awhite2000/sigmidi/design/front-panel.md

# SIGMIDI Foot Controller v0.1 — Front panel

The preferred Left main enclosure measures **350 × 92 × 54 mm**, with 65 mm horizontal switch pitch, 32.5 mm stagger, 53 mm row spacing and a 30 mm raised upper row. The shell has at least 2 mm sides and 3 mm top panels.

Viewed from the playing position, Left labels run **A B C D E** across the raised row and **1 2 3 4 5** across the lower row. The display and encoder are on the left. The Waveshare 24382 glass is flush with the lower deck; the ribbon is on the left and the firmware selects 180° rotation. Right has electronics on the right and labels **E D C B A / 5 4 3 2 1**.

Modular Left assemblies have an A B / 1 2 electronics section, C/3, D/4 and E/5 sections as required, and a right end cap. Right extends leftward from its electronics section. Every extension occupies 65 mm of width.

Switch names use Arial Bold outlines, 8 mm high and recessed 0.8 mm. The roof below the markings is 2.2 mm thick. An optional LED is below each switch; covers close unused LED holes.

The Left electronics upper shell carries a **25 × 20.183 mm** icon between A and B, raised 0.6 mm and backed by the full 3 mm roof. Maximum local body height at the icon is 54.6 mm.

Use the [Left top view](fusion/mirrored/main/top.png), [populated assembly](fusion/mirrored/main/assembled.png), [icon detail](fusion/mirrored/main/embossed-icon.png) and [assembly-coordinate geometry](fusion/mirrored/layout.json). Renders are overviews; manufacture from the [CAD and oriented print files](fusion/mirrored/README.md).
