awhite2000/sigmidi/previews/kicad-schematic.html

# SIGMIDI Foot Controller v0.1 · KiCad schematic

External board pins only. Arduino Nano ESP32 and display connectors retain physical pin order.

57 components · 49 nets · 178 connected terminals · connectivity and pin order verified against the electrical diagram.

Fit− 100%+ Readable detailOpen vector drawing PNG

Complete SIGMIDI KiCad schematic with physically ordered Arduino Nano ESP32 and display pins
