awhite2000/sigmidi/design/ladders/voltage-targets.csv

layout | switch_count | tap | displayed_switch | series_ohms | nominal_mV_at_3V3
linear | 4 | 0 | idle |  | 2200.000
linear | 4 | 1 | 1 | 1000 | 286.957
linear | 4 | 2 | 2 | 2000 | 507.692
linear | 4 | 3 | 3 | 3000 | 682.759
linear | 4 | 4 | 4 | 4000 | 825.000
linear | 5 | 0 | idle |  | 2200.000
linear | 5 | 1 | 1 | 1000 | 286.957
linear | 5 | 2 | 2 | 2000 | 507.692
linear | 5 | 3 | 3 | 3000 | 682.759
linear | 5 | 4 | 4 | 4000 | 825.000
linear | 5 | 5 | 5 | 5000 | 942.857
linear | 6 | 0 | idle |  | 2200.000
linear | 6 | 1 | 1 | 1000 | 286.957
linear | 6 | 2 | 2 | 2000 | 507.692
linear | 6 | 3 | 3 | 3000 | 682.759
linear | 6 | 4 | 4 | 4000 | 825.000
linear | 6 | 5 | 5 | 5000 | 942.857
linear | 6 | 6 | 6 | 6000 | 1042.105
linear | 7 | 0 | idle |  | 2200.000
linear | 7 | 1 | 1 | 1000 | 286.957
linear | 7 | 2 | 2 | 2000 | 507.692
linear | 7 | 3 | 3 | 3000 | 682.759
linear | 7 | 4 | 4 | 4000 | 825.000
linear | 7 | 5 | 5 | 5000 | 942.857
linear | 7 | 6 | 6 | 6000 | 1042.105
linear | 7 | 7 | 7 | 7000 | 1126.829
linear | 8 | 0 | idle |  | 2200.000
linear | 8 | 1 | 1 | 1000 | 286.957
linear | 8 | 2 | 2 | 2000 | 507.692
linear | 8 | 3 | 3 | 3000 | 682.759
linear | 8 | 4 | 4 | 4000 | 825.000
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
