awhite2000/sigmidi/design/fusion/archive/README.md

# Wall sample data

`post-display-m2x5-wall-sampling.zip` contains Right-enclosure thickness samples. Left samples are in `../mirrored/wall-sampling.zip`. The [complete native Fusion model](../sigmidi-foot-controller-0.1.f3d) contains all enclosure assemblies and part libraries.
