awhite2000/sigmidi/design/branding/sigmidi-mark-light.png

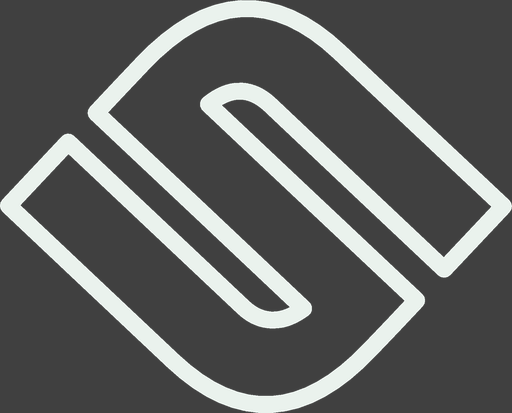
design/branding/sigmidi-mark-light.png
