awhite2000/sigmidi/design/branding/sigmidi-mark-original.png

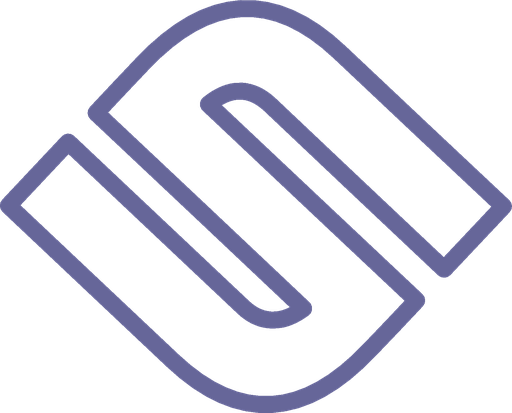
design/branding/sigmidi-mark-original.png
