awhite2000/sigmidi/design/fusion/base-corner-detail.png

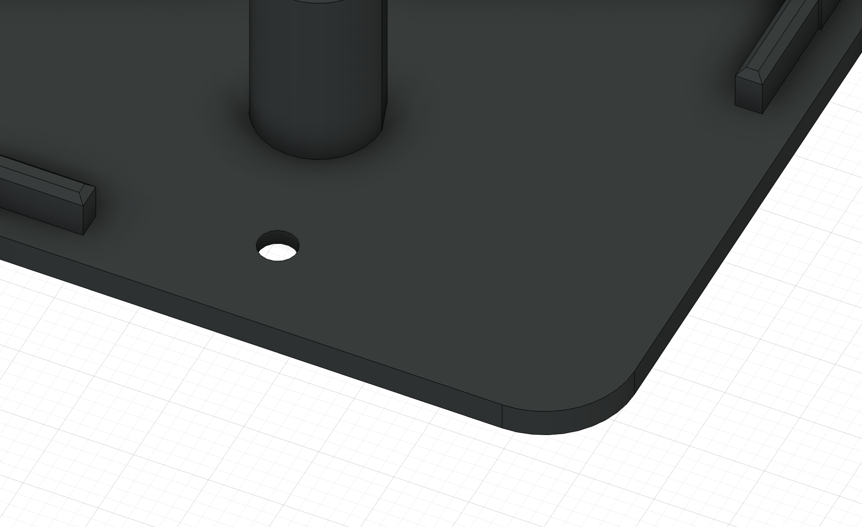
design/fusion/base-corner-detail.png
