awhite2000/sigmidi/design/fusion/base-open.png

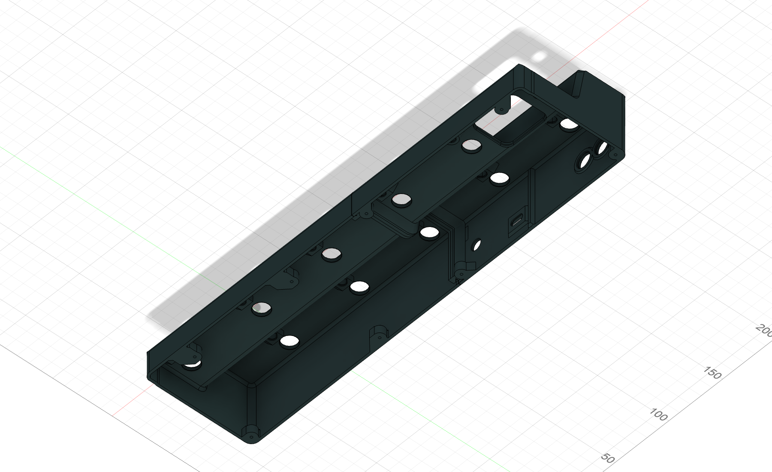
design/fusion/base-open.png
