awhite2000/sigmidi/design/fusion/base-supports.png

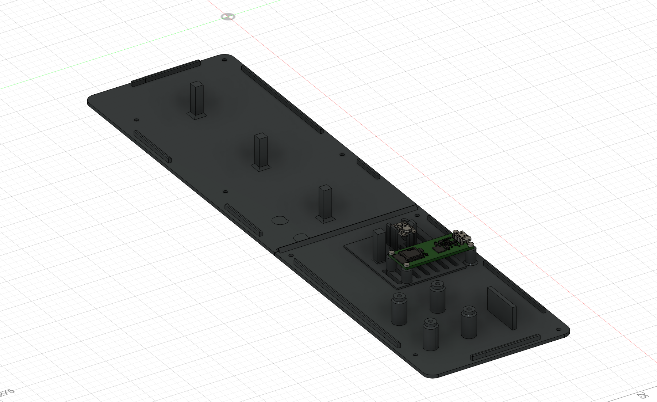
design/fusion/base-supports.png
