awhite2000/sigmidi/design/fusion/blind-pilot-cap-section.png

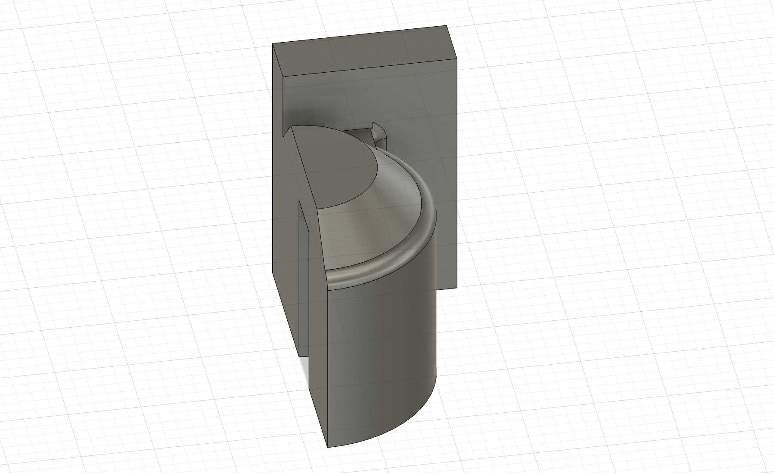
design/fusion/blind-pilot-cap-section.png
