awhite2000/sigmidi/design/fusion/clip-mount.png

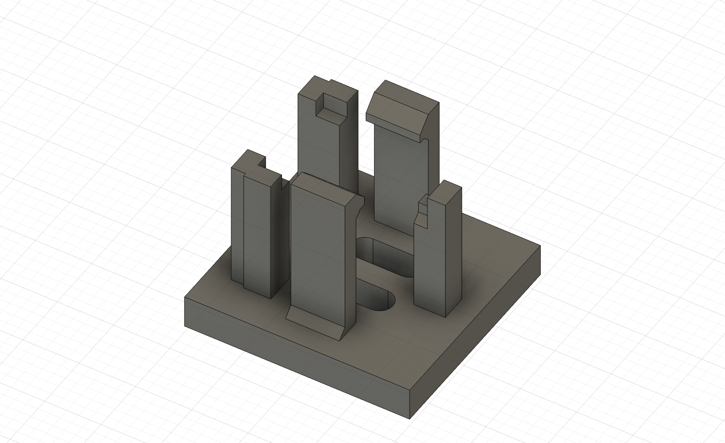
design/fusion/clip-mount.png
