awhite2000/sigmidi/design/fusion/exploded.png

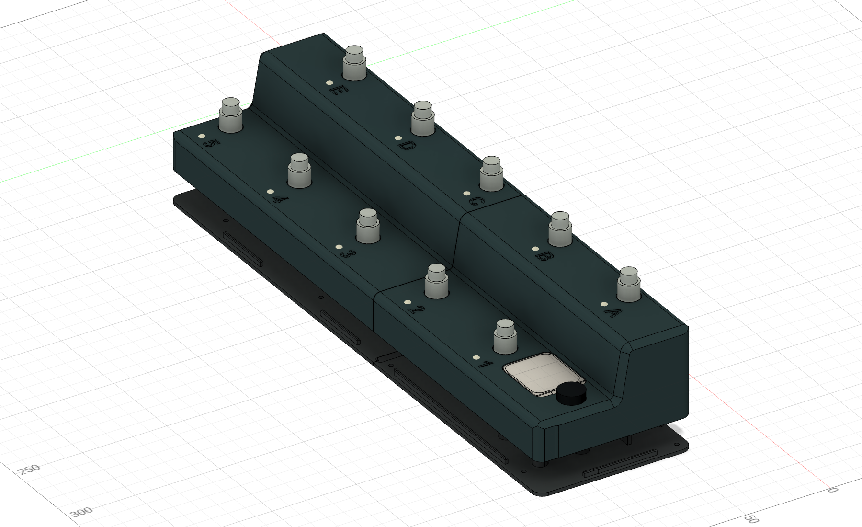
design/fusion/exploded.png
