awhite2000/sigmidi/design/fusion/internal.png

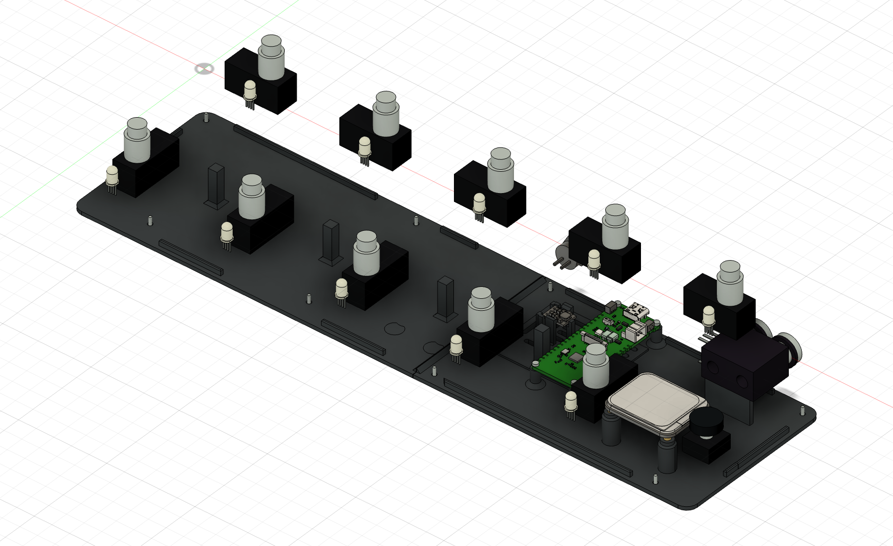
design/fusion/internal.png
