awhite2000/sigmidi/design/fusion/mirrored/main/display-ribbon-left.png

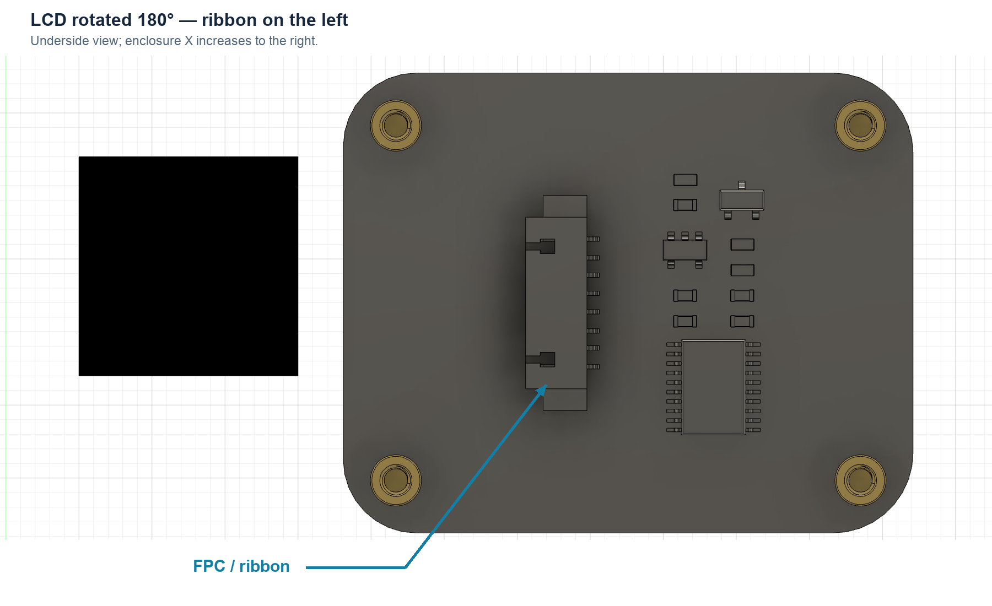
design/fusion/mirrored/main/display-ribbon-left.png
