awhite2000/sigmidi/design/fusion/mirrored/main/exploded.png

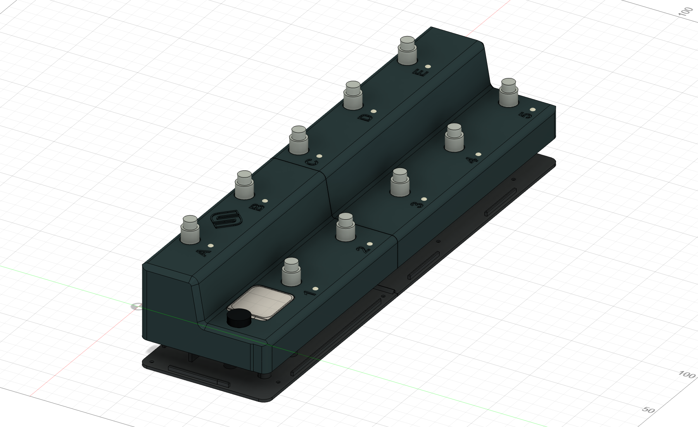
design/fusion/mirrored/main/exploded.png
