awhite2000/sigmidi/design/fusion/mirrored/main/internal.png

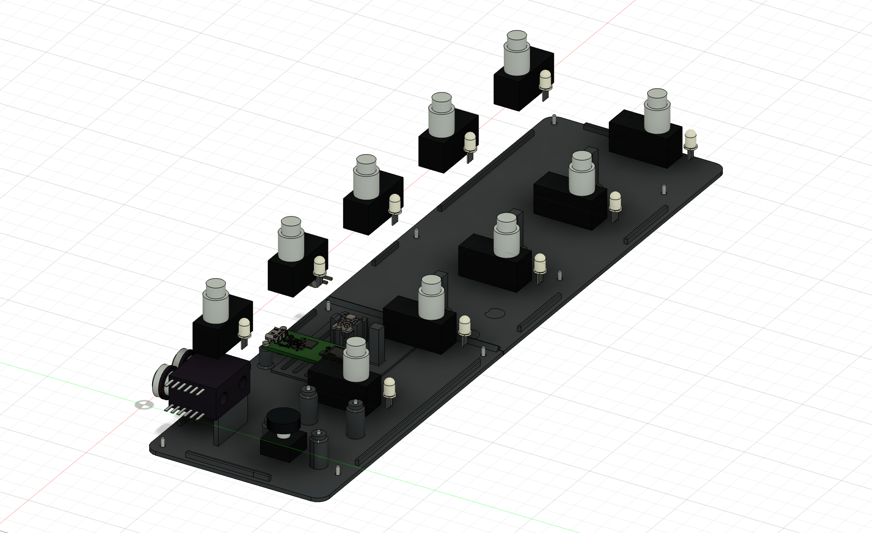
design/fusion/mirrored/main/internal.png
