awhite2000/sigmidi/design/fusion/mirrored/main/rear.png

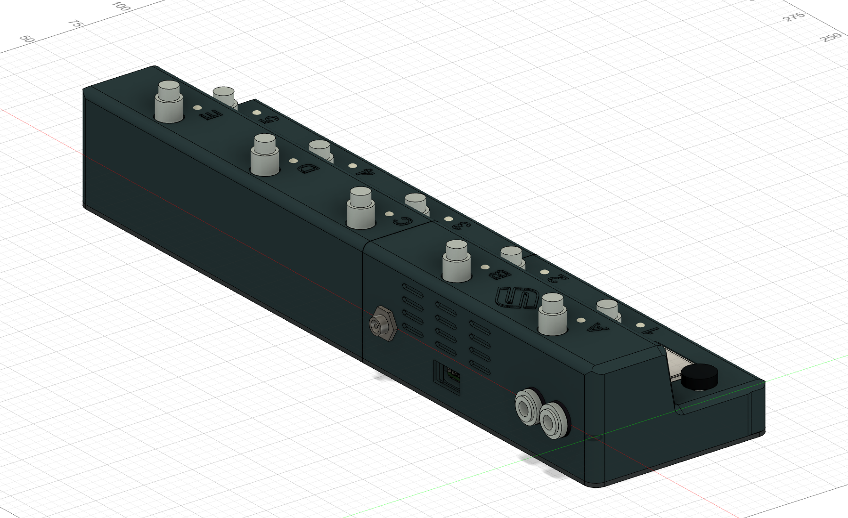
design/fusion/mirrored/main/rear.png
