awhite2000/sigmidi/design/fusion/mirrored/main/top.png

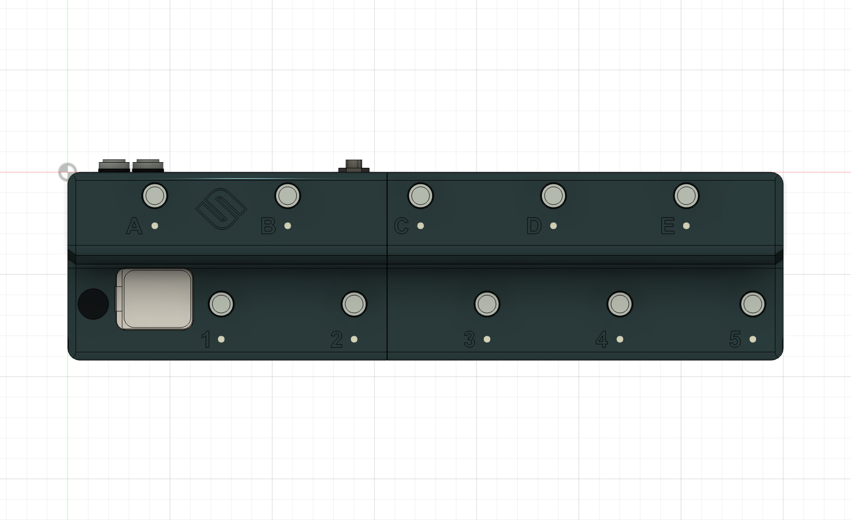
design/fusion/mirrored/main/top.png
