awhite2000/sigmidi/design/fusion/mirrored/modular/base-mounts.png

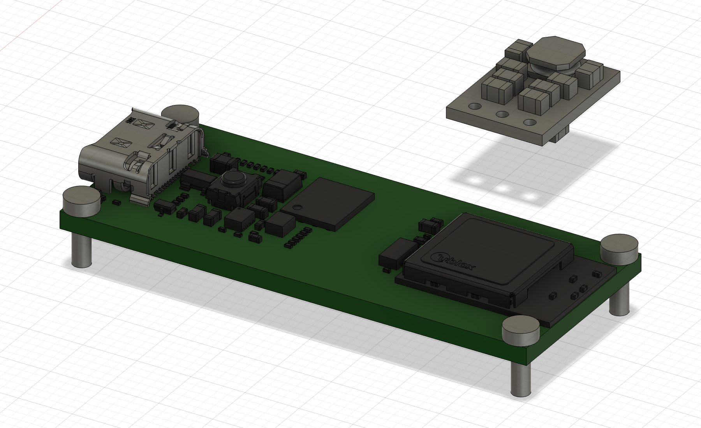
design/fusion/mirrored/modular/base-mounts.png
