awhite2000/sigmidi/design/fusion/mirrored/modular/exploded.png

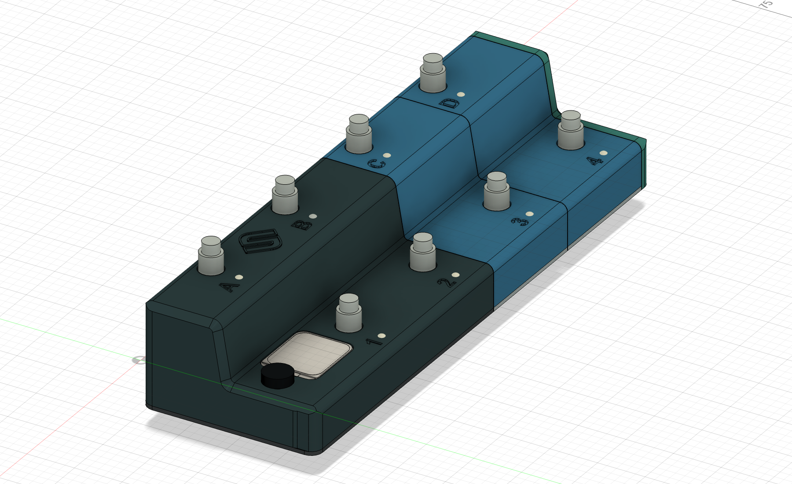
design/fusion/mirrored/modular/exploded.png
