awhite2000/sigmidi/design/fusion/mirrored/modular/internal.png

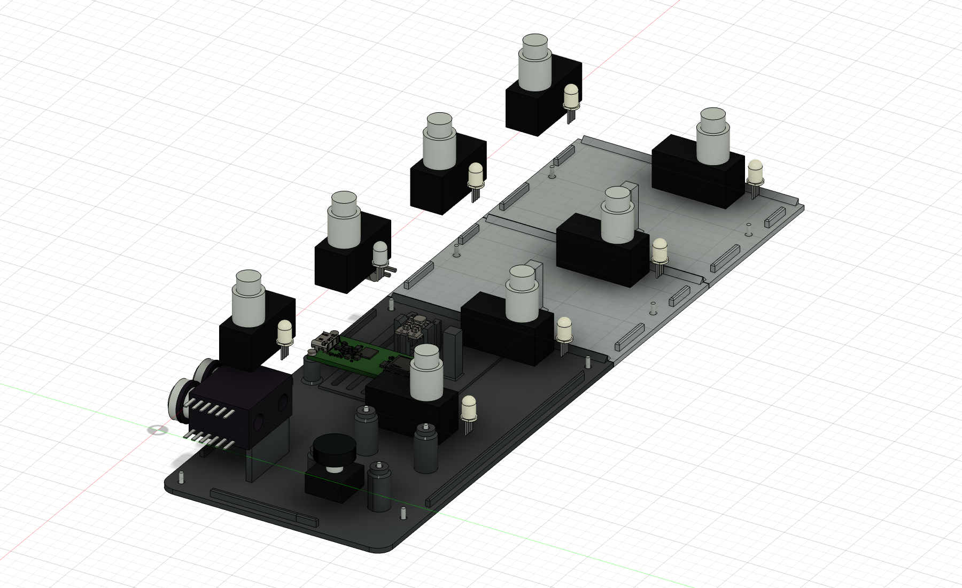
design/fusion/mirrored/modular/internal.png
