awhite2000/sigmidi/design/fusion/mirrored/modular/rear.png

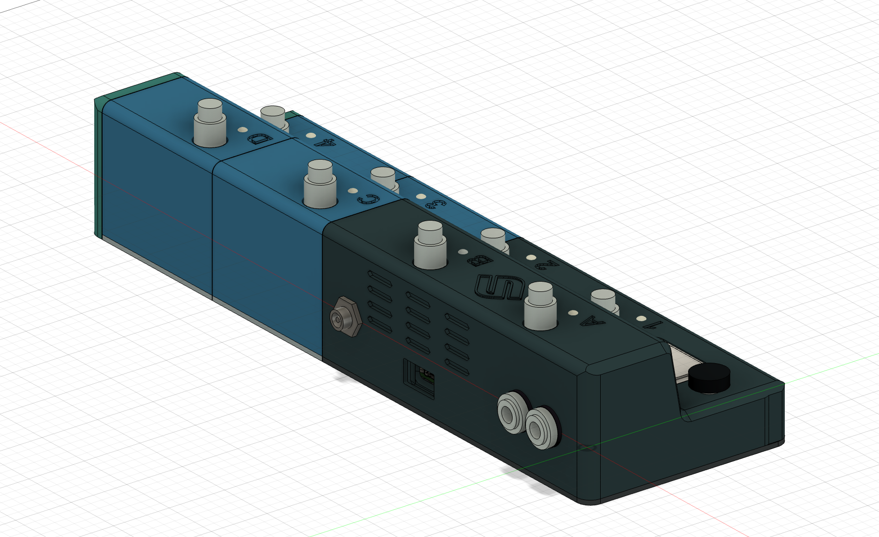
design/fusion/mirrored/modular/rear.png
