awhite2000/sigmidi/design/fusion/mirrored/modular/top.png

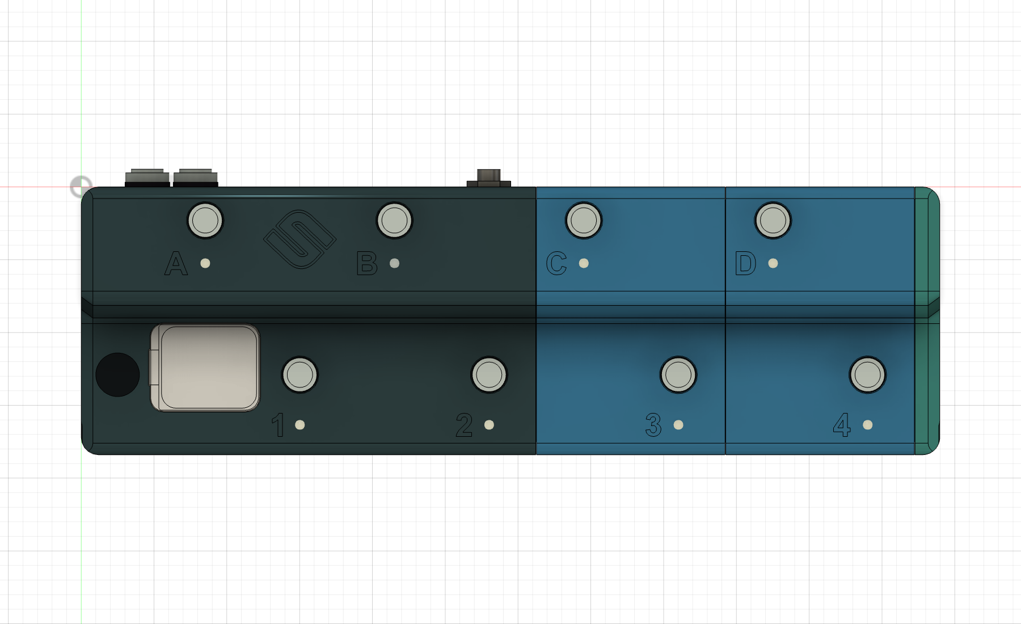
design/fusion/mirrored/modular/top.png
