awhite2000/sigmidi/design/fusion/modular/base-mounts.png

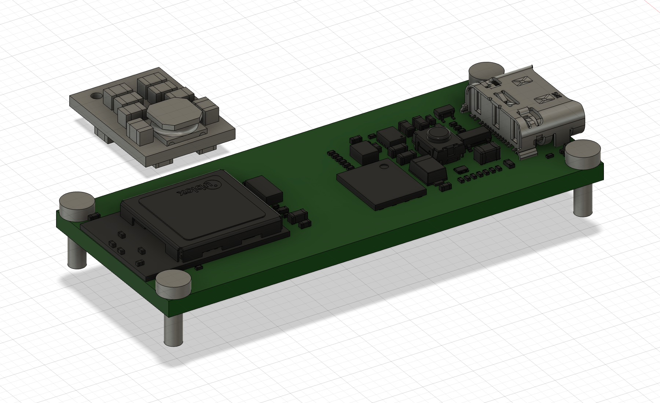
design/fusion/modular/base-mounts.png
