awhite2000/sigmidi/design/fusion/modular/cap-floor-underside.png

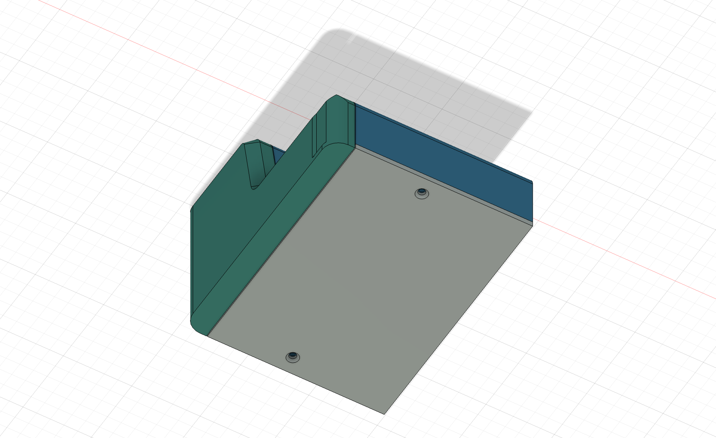
design/fusion/modular/cap-floor-underside.png
