awhite2000/sigmidi/design/fusion/modular/modular-internal.png

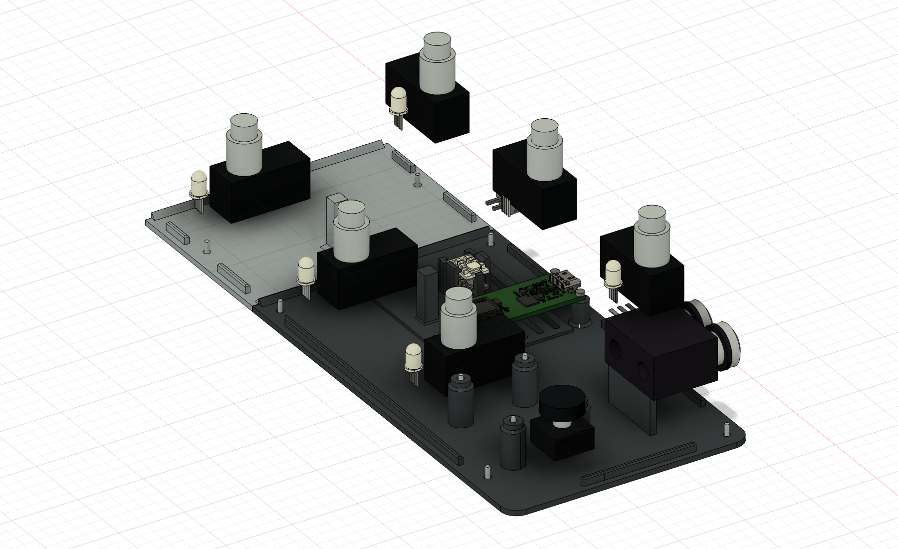
design/fusion/modular/modular-internal.png
