awhite2000/sigmidi/design/fusion/modular/pair-two-screw-mounts.png

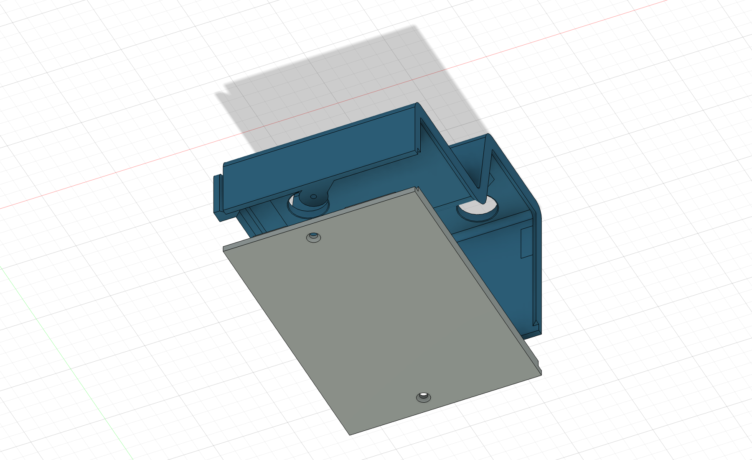
design/fusion/modular/pair-two-screw-mounts.png
