awhite2000/sigmidi/design/fusion/modular/rear.png

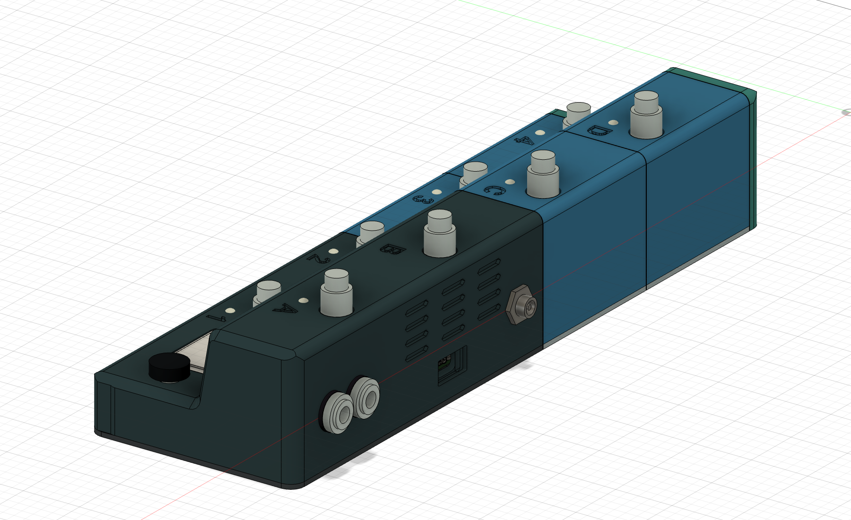
design/fusion/modular/rear.png
