awhite2000/sigmidi/design/fusion/modular/top.png

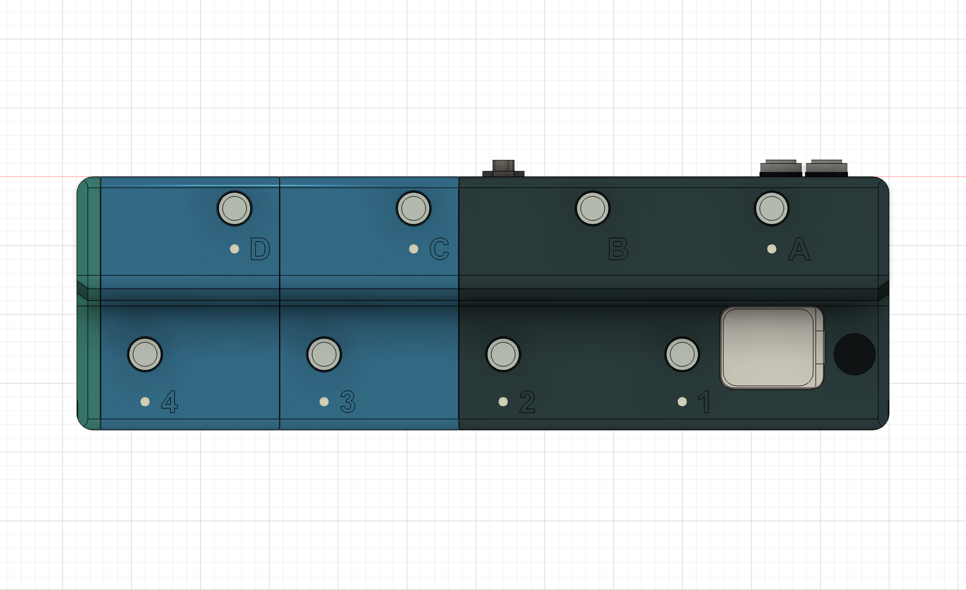
design/fusion/modular/top.png
