awhite2000/sigmidi/design/fusion/mounted-boards.png

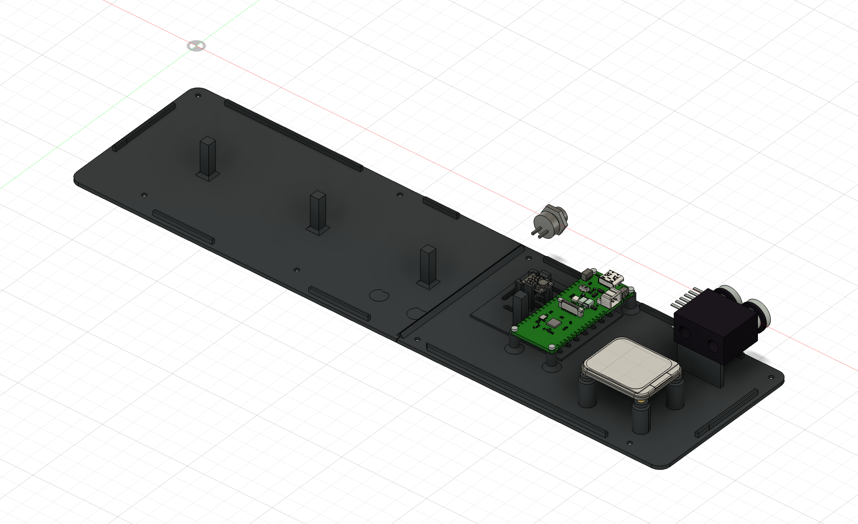
design/fusion/mounted-boards.png
