awhite2000/sigmidi/design/fusion/nano-esp32/posts.png

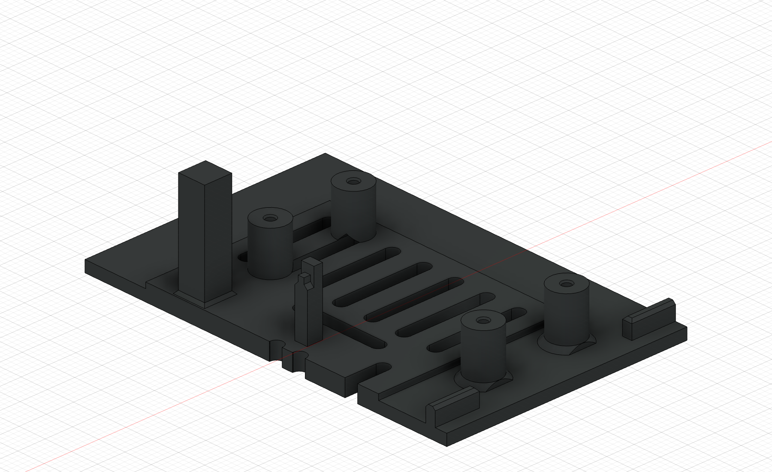
design/fusion/nano-esp32/posts.png
