awhite2000/sigmidi/design/fusion/panel-top.png

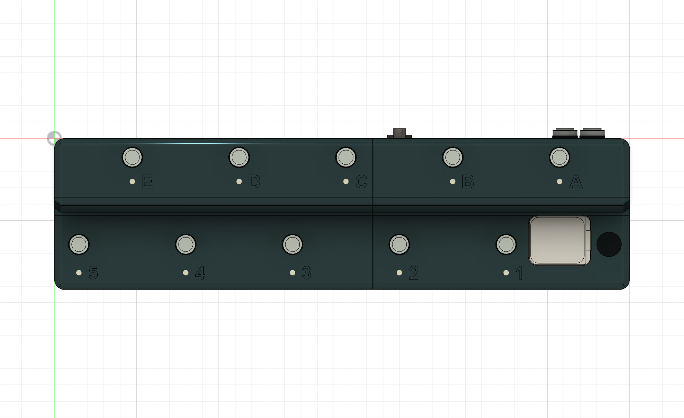
design/fusion/panel-top.png
