awhite2000/sigmidi/design/fusion/power-internal.png

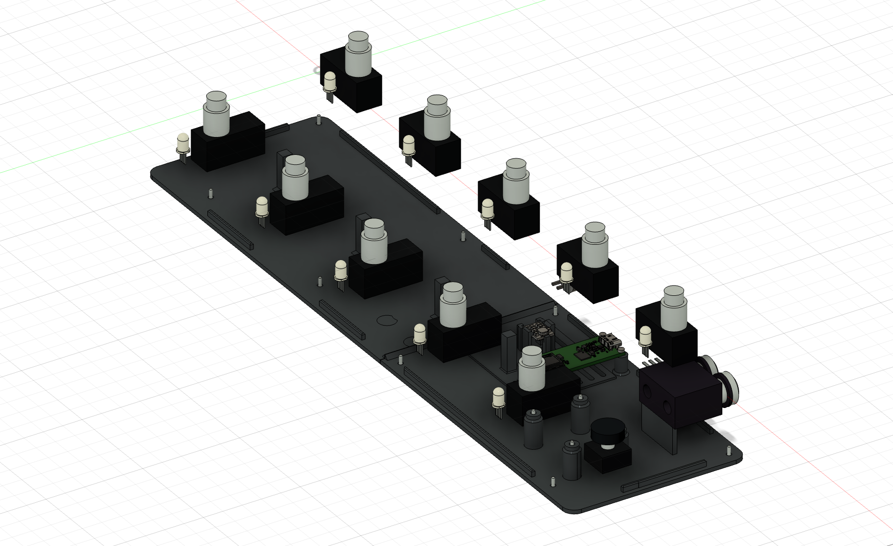
design/fusion/power-internal.png
