awhite2000/sigmidi/design/fusion/power-rear.png

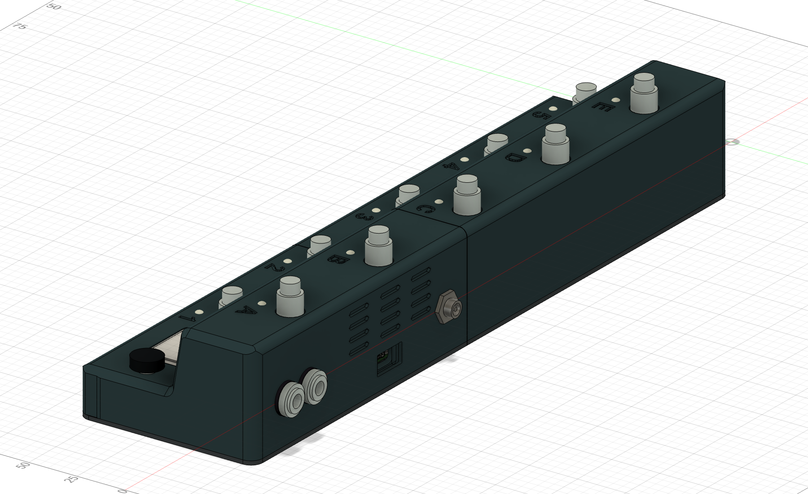
design/fusion/power-rear.png
