awhite2000/sigmidi/design/fusion/rear-rib-base-seat.png

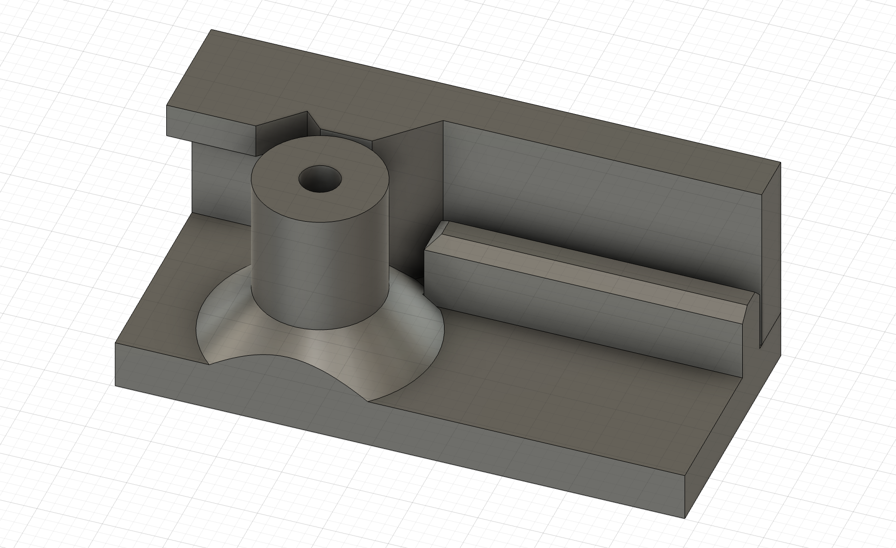
design/fusion/rear-rib-base-seat.png
