awhite2000/sigmidi/design/fusion/rear-ribs-internal.png

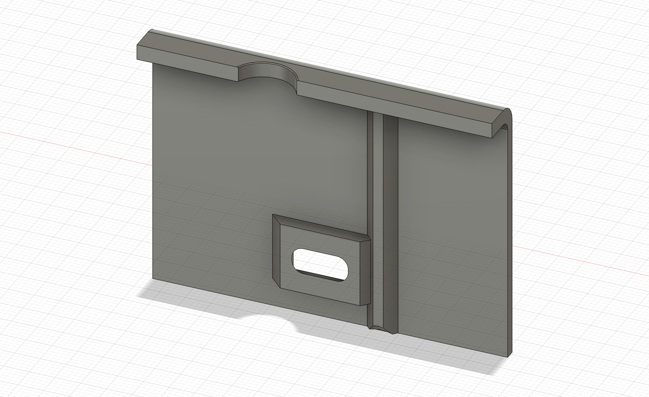
design/fusion/rear-ribs-internal.png
