awhite2000/sigmidi/design/fusion/rear-vent-membrane-section.png

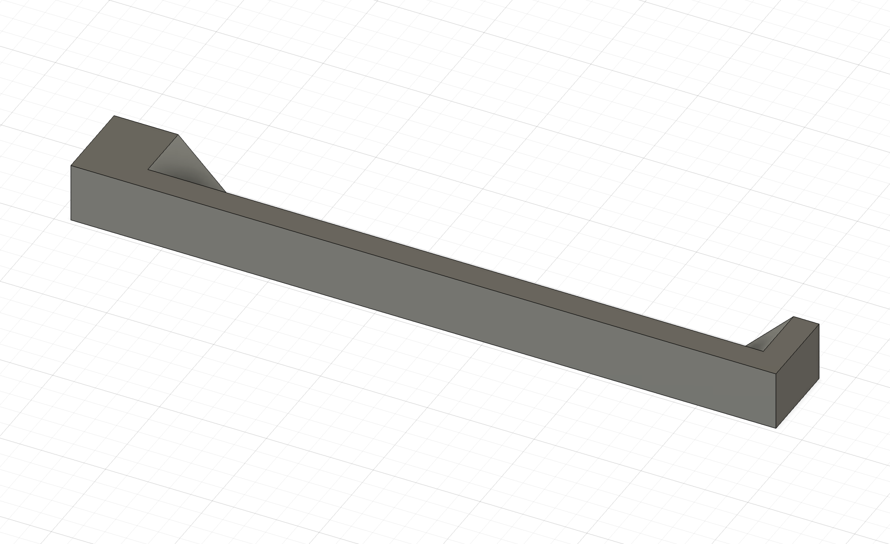
design/fusion/rear-vent-membrane-section.png
