awhite2000/sigmidi/design/fusion/switch-labels.png

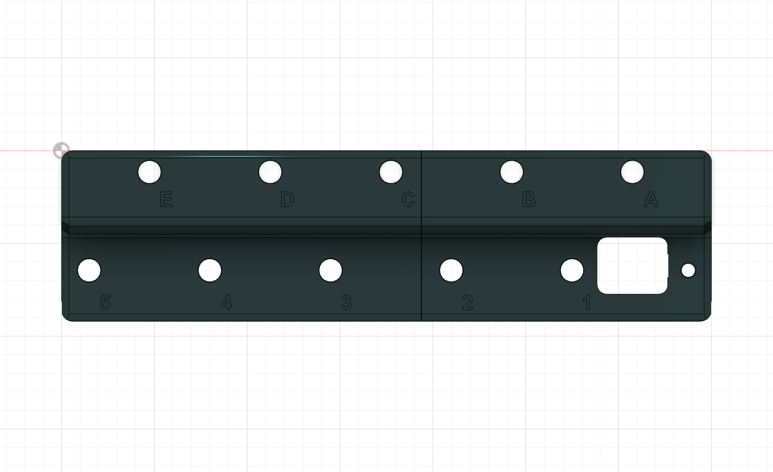
design/fusion/switch-labels.png
