awhite2000/sigmidi/design/fusion/upper-corner-toolpaths.png

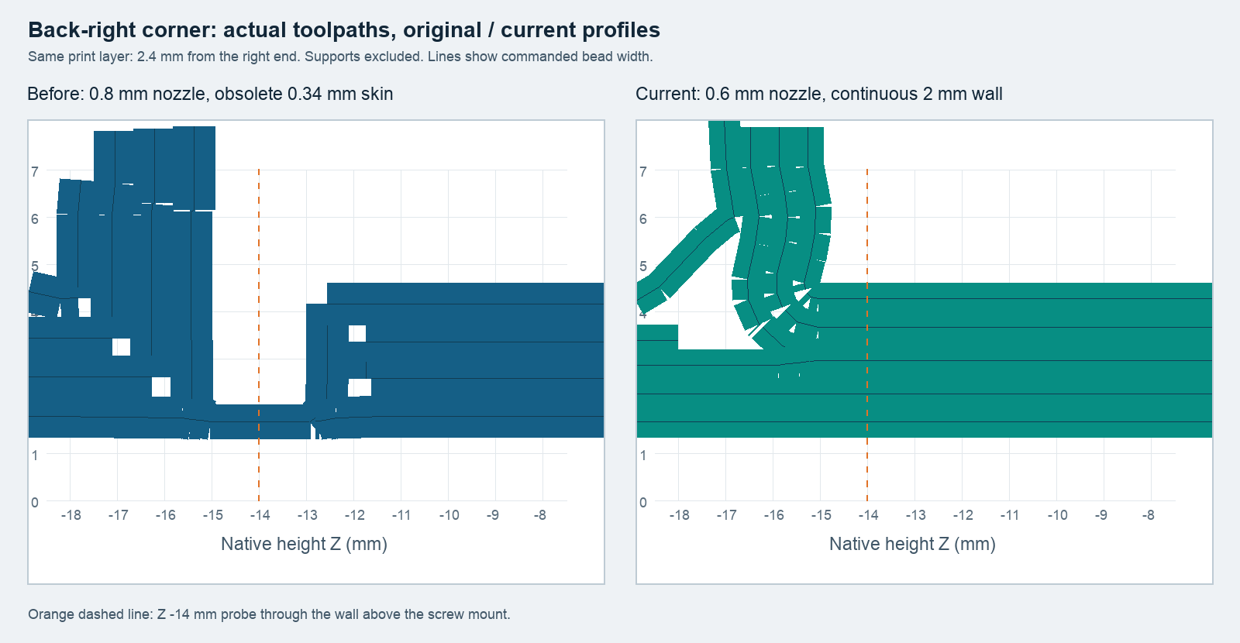
design/fusion/upper-corner-toolpaths.png
