awhite2000/sigmidi/design/fusion/upper-corner-wall-detail.png

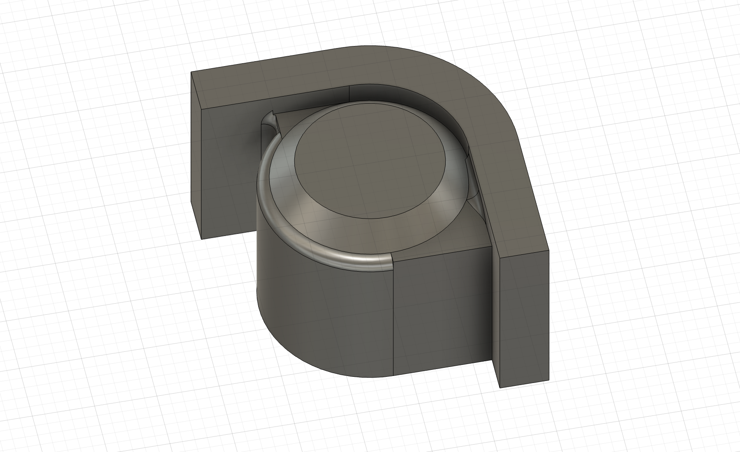
design/fusion/upper-corner-wall-detail.png
