awhite2000/sigmidi/design/fusion/ventilation-base.png

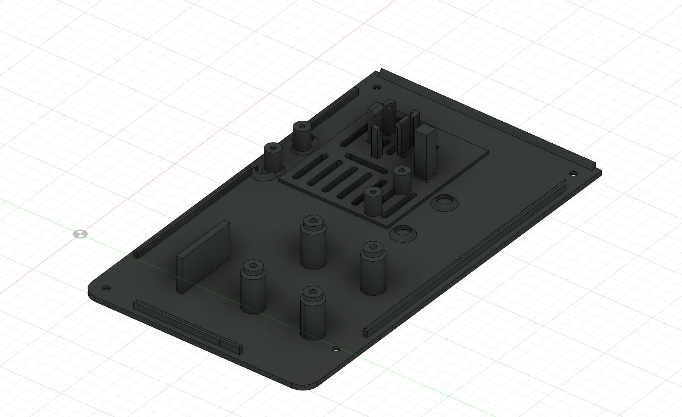
design/fusion/ventilation-base.png
