awhite2000/sigmidi/design/fusion/ventilation-rear.png

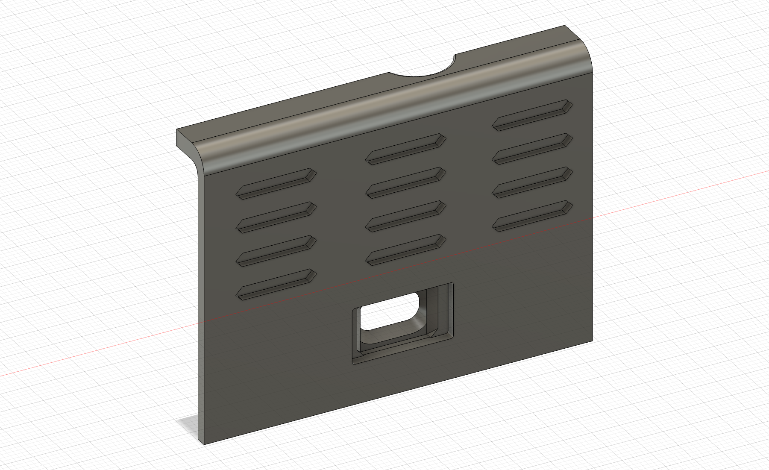
design/fusion/ventilation-rear.png
