awhite2000/sigmidi/design/kicad/sigmidi-foot-controller.png

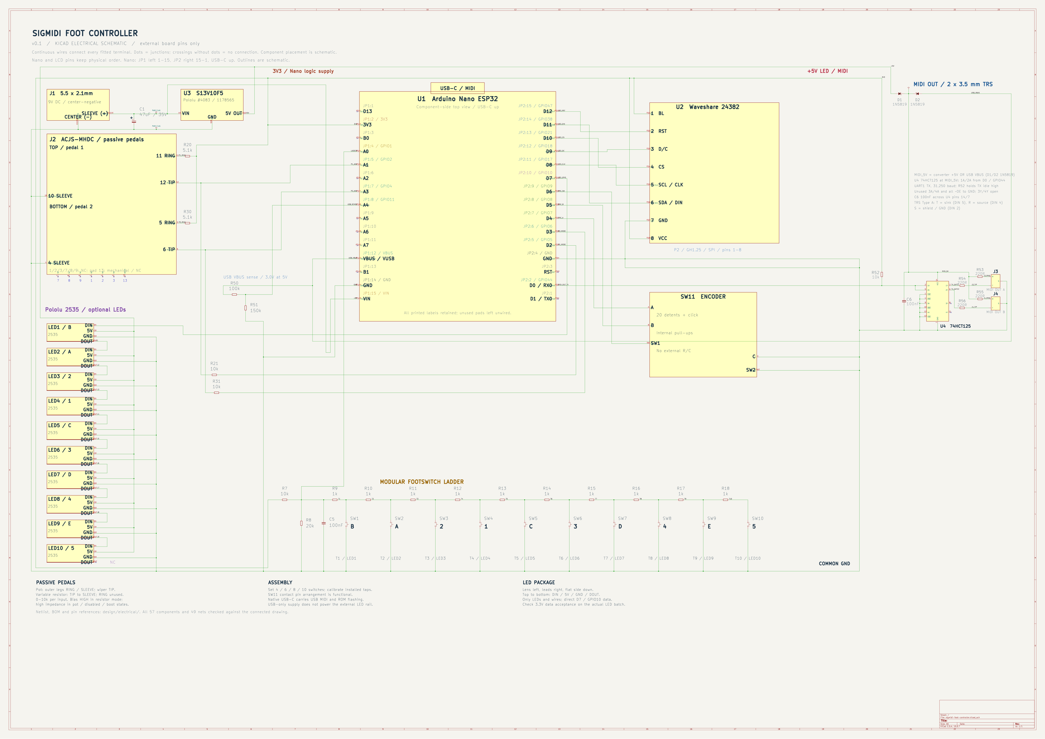
design/kicad/sigmidi-foot-controller.png
