awhite2000/sigmidi/distribution/web-flasher/assets/enclosure-left.png

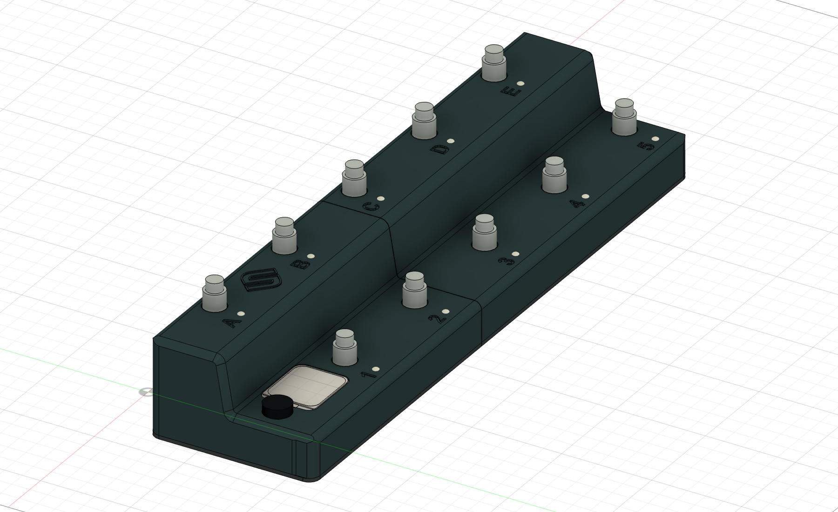
distribution/web-flasher/assets/enclosure-left.png
