awhite2000/sigmidi/docs/device-workflows/config-enclosure.png

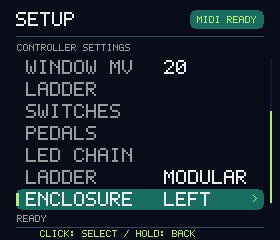
docs/device-workflows/config-enclosure.png
