awhite2000/sigmidi/docs/device-workflows/config-ladder.png

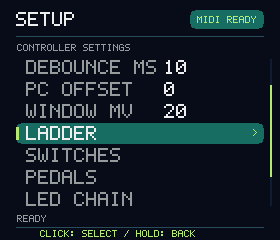
docs/device-workflows/config-ladder.png
