awhite2000/sigmidi/docs/device-workflows/config-switches.png

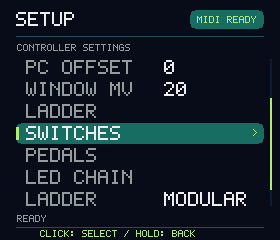
docs/device-workflows/config-switches.png
