awhite2000/sigmidi/docs/device-workflows/ladder-centers.png

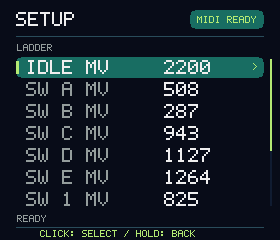
docs/device-workflows/ladder-centers.png
