awhite2000/sigmidi/docs/device-workflows/led-settings.png

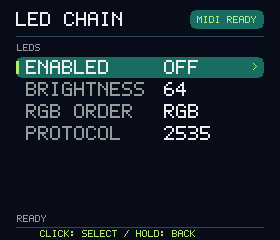
docs/device-workflows/led-settings.png
