awhite2000/sigmidi/docs/device-workflows/message-actions.png

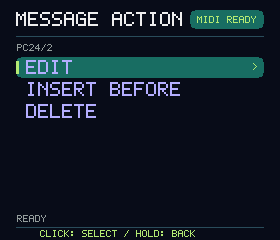
docs/device-workflows/message-actions.png
