awhite2000/sigmidi/docs/device-workflows/pc-editor.png

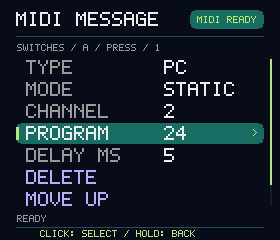
docs/device-workflows/pc-editor.png
