awhite2000/sigmidi/docs/device-workflows/pedal-list.png

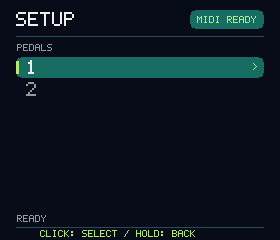
docs/device-workflows/pedal-list.png
