awhite2000/sigmidi/docs/device-workflows/pedal-settings.png

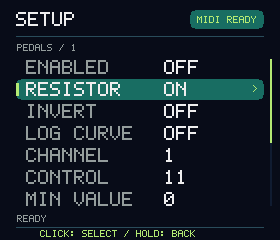
docs/device-workflows/pedal-settings.png
