awhite2000/sigmidi/docs/device-workflows/press-list.png

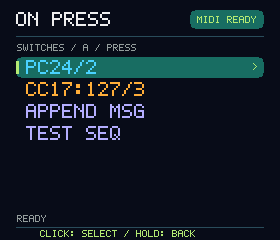
docs/device-workflows/press-list.png
