awhite2000/sigmidi/docs/device-workflows/save-workflow.png

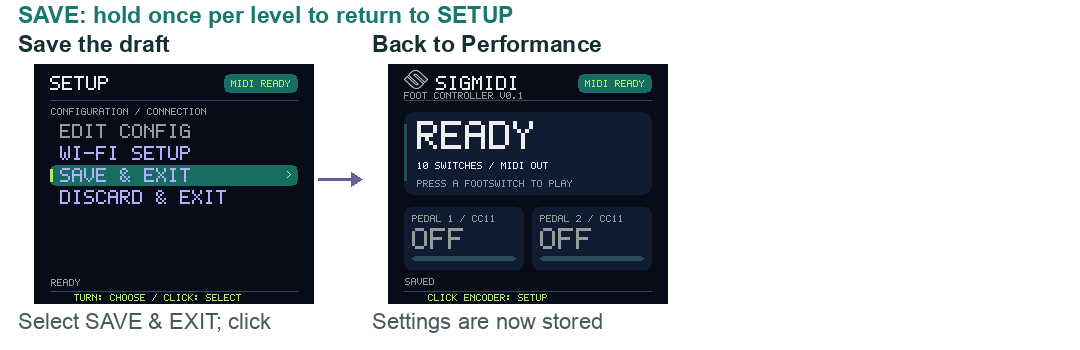
docs/device-workflows/save-workflow.png
