awhite2000/sigmidi/docs/device-workflows/switch-list.png

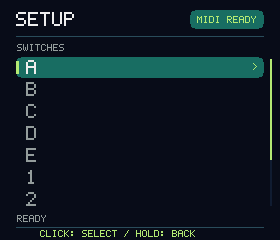
docs/device-workflows/switch-list.png
