awhite2000/sigmidi/docs/device-workflows/switch-press.png

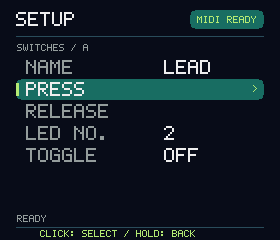
docs/device-workflows/switch-press.png
