awhite2000/sigmidi/previews/06.png

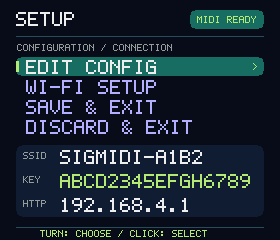
previews/06.png
