awhite2000/sigmidi/previews/07.png

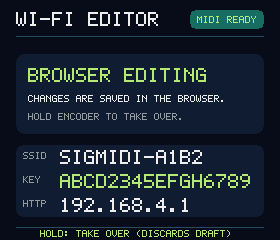
previews/07.png
