awhite2000/sigmidi/previews/10.png

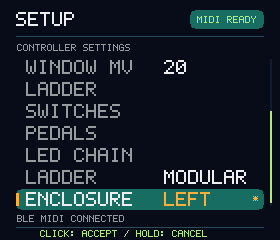
previews/10.png
