awhite2000/sigmidi/previews/13.png

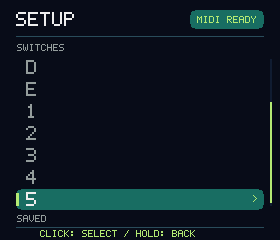
previews/13.png
