awhite2000/sigmidi/previews/14.png

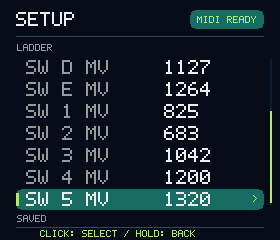
previews/14.png
