awhite2000/sigmidi/previews/17.png

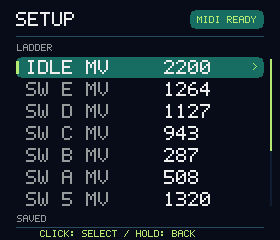
previews/17.png
