awhite2000/sigmidi/previews/18.png

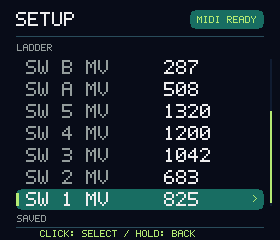
previews/18.png
