awhite2000/sigmidi/previews/21.png

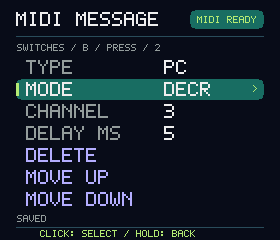
previews/21.png
