awhite2000/sigmidi/previews/24.png

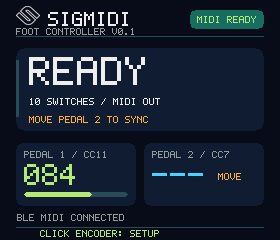
previews/24.png
