awhite2000/sigmidi/previews/25.png

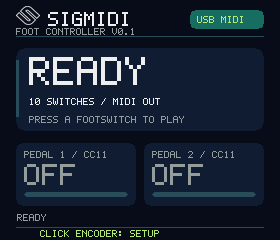
previews/25.png
