awhite2000/sigmidi/previews/cable-bundles-left-detail.png

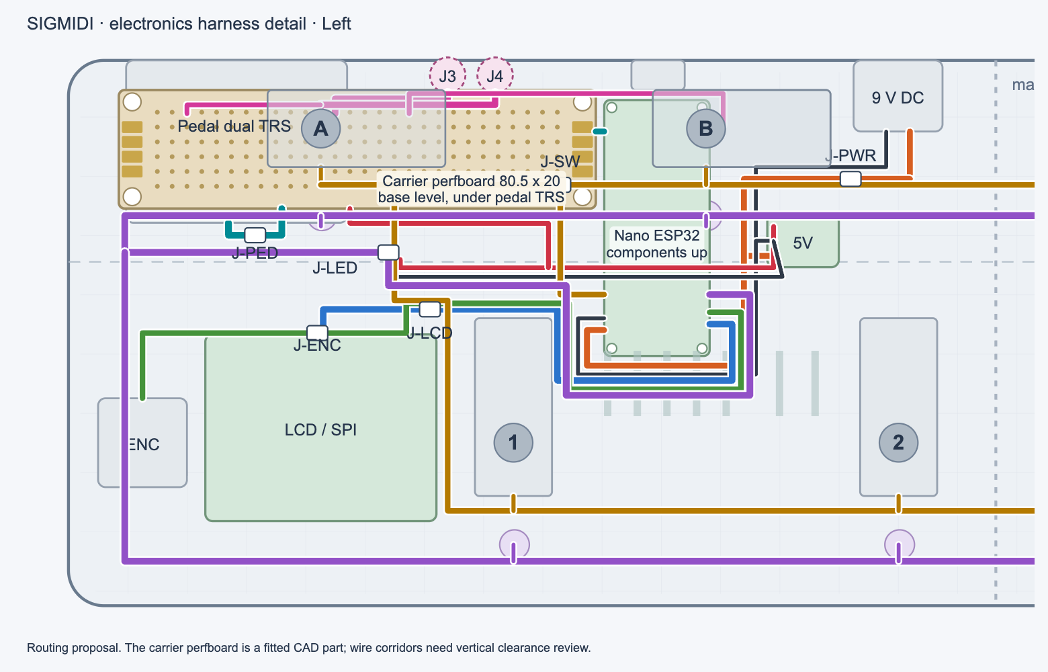
previews/cable-bundles-left-detail.png
