awhite2000/sigmidi/previews/display-overview.png

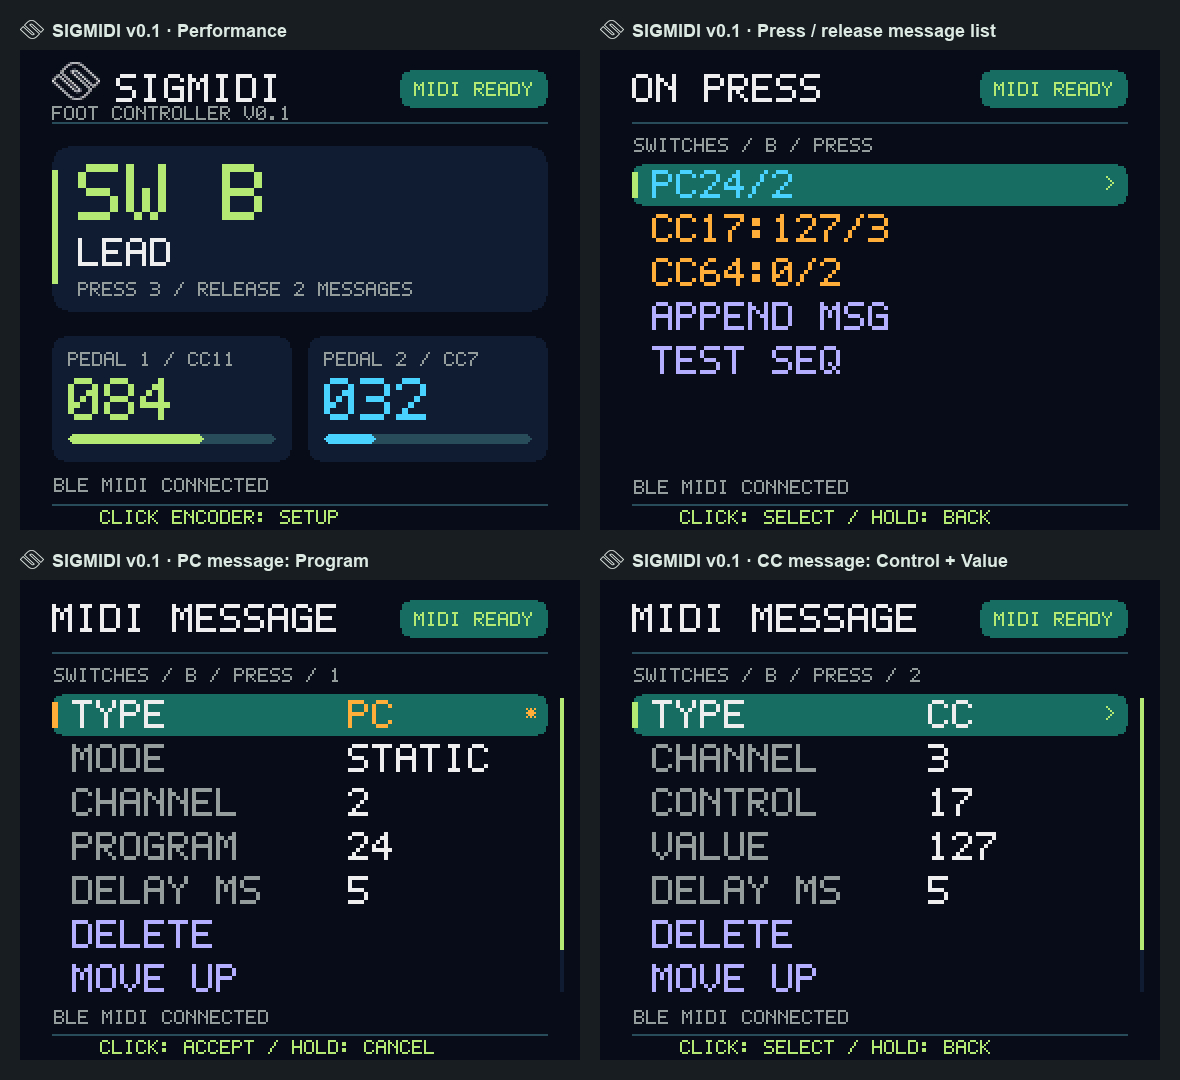
previews/display-overview.png
