awhite2000/sigmidi/previews/display-preview.png

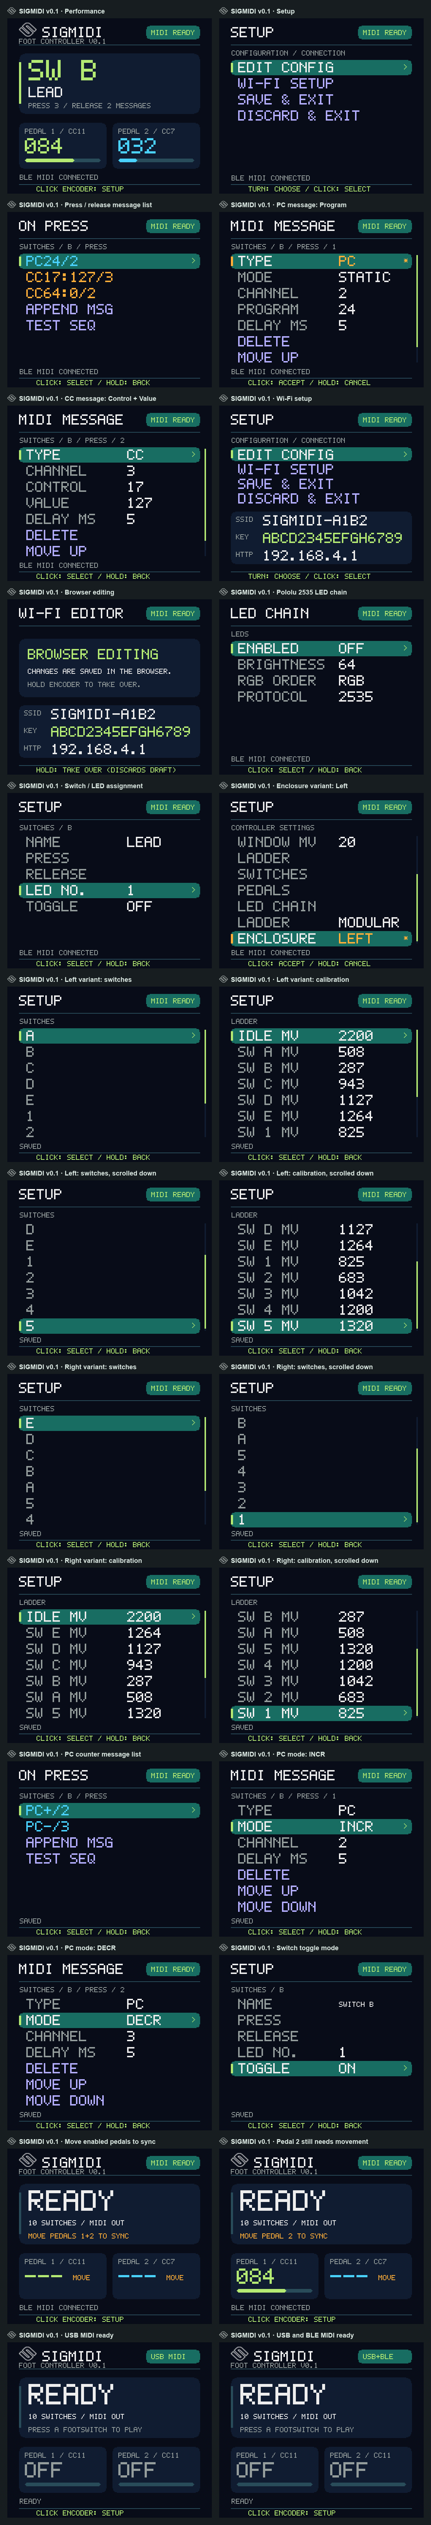
previews/display-preview.png
