awhite2000/sigmidi/previews/electrical-01.png

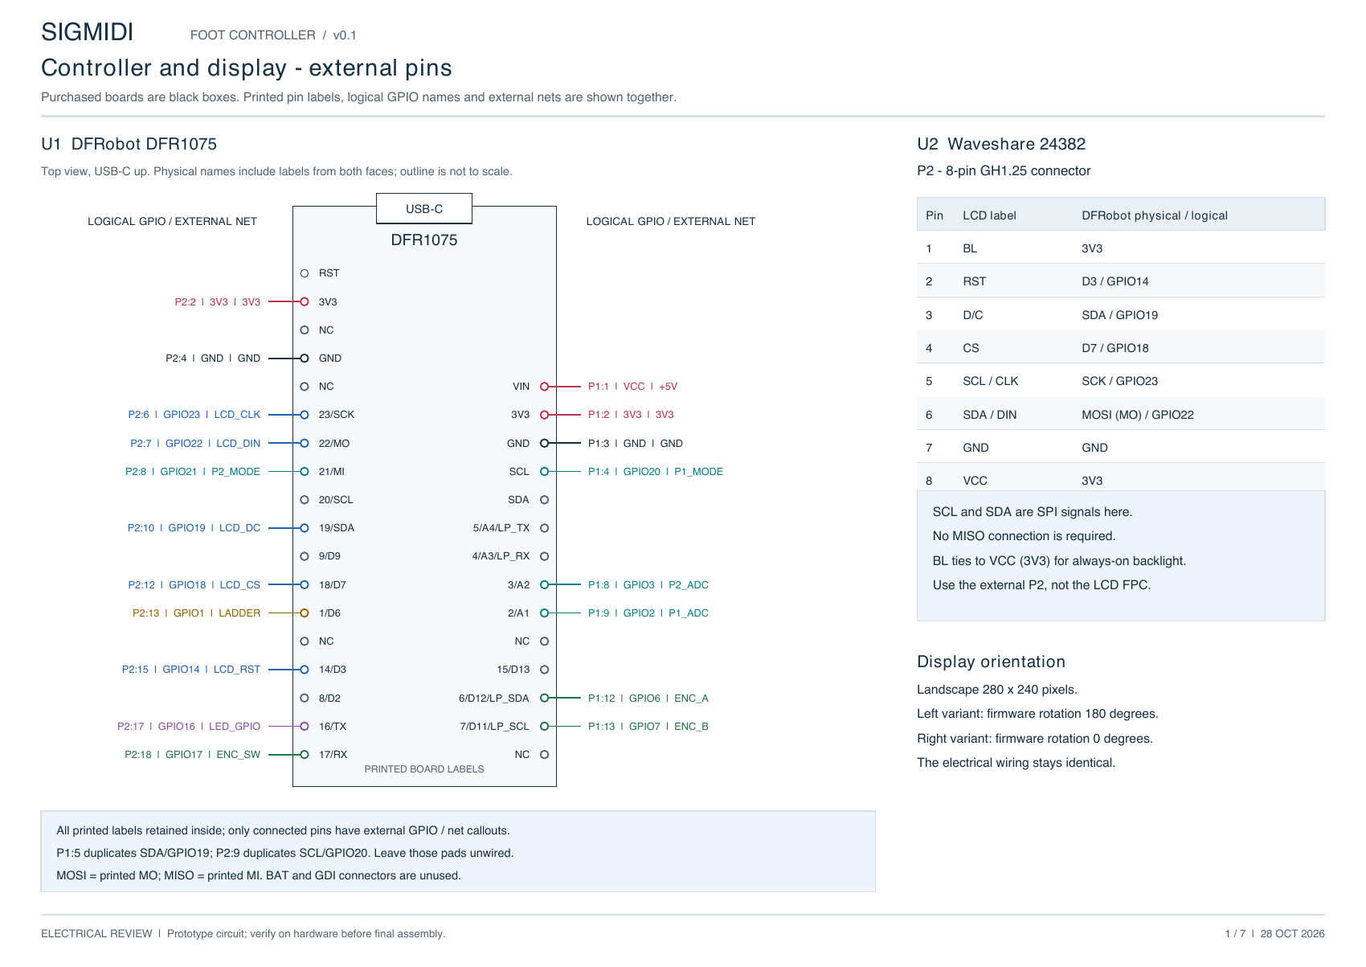
previews/electrical-01.png
