awhite2000/sigmidi/previews/electrical-02.png

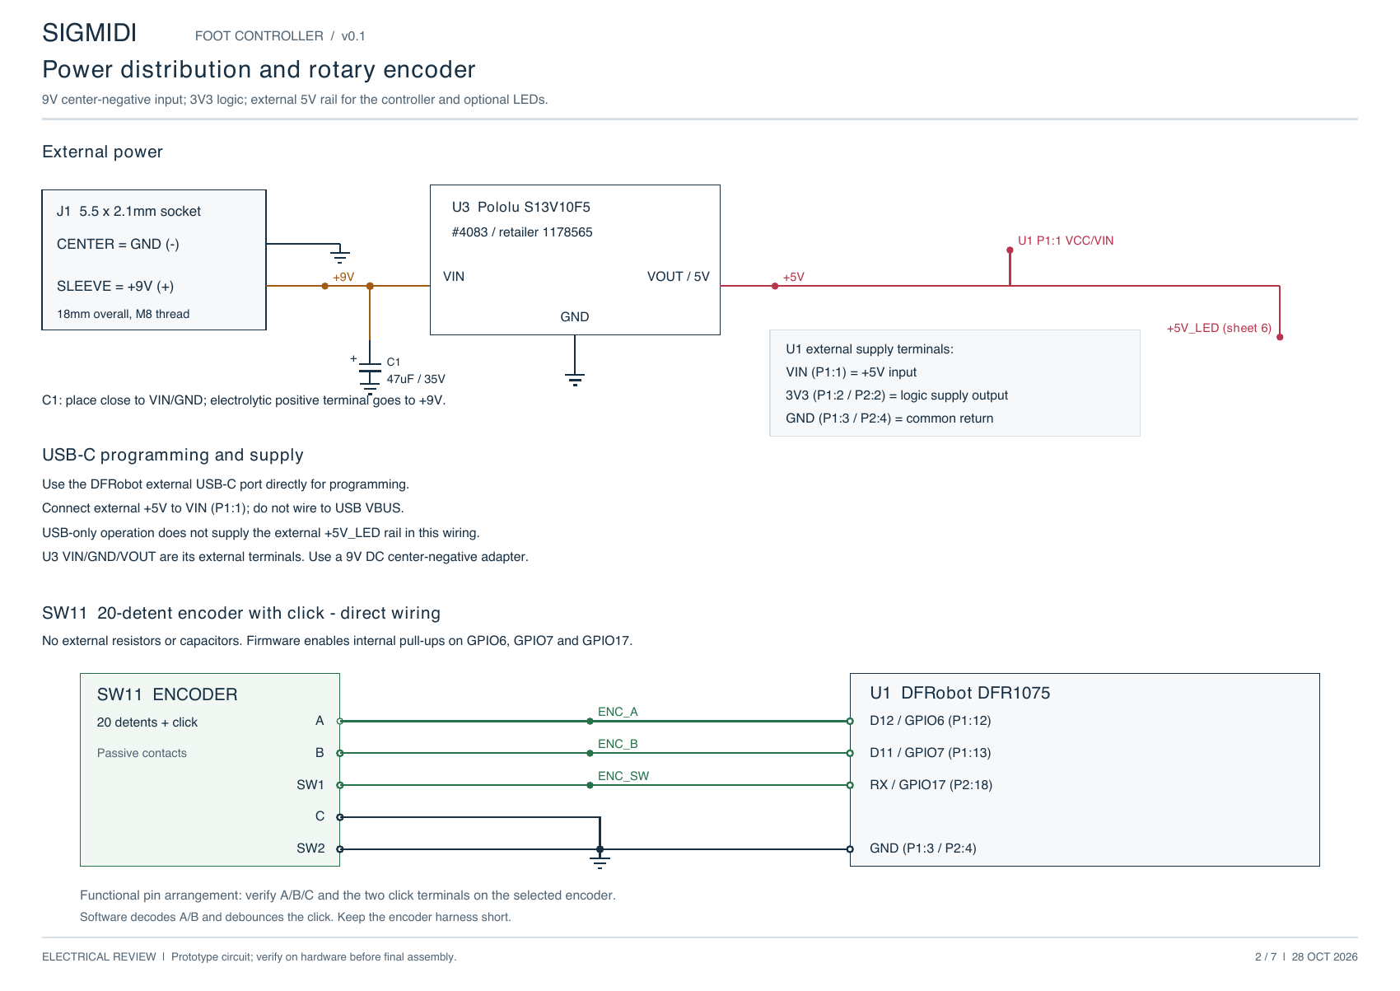
previews/electrical-02.png
