awhite2000/sigmidi/previews/electrical-03.png

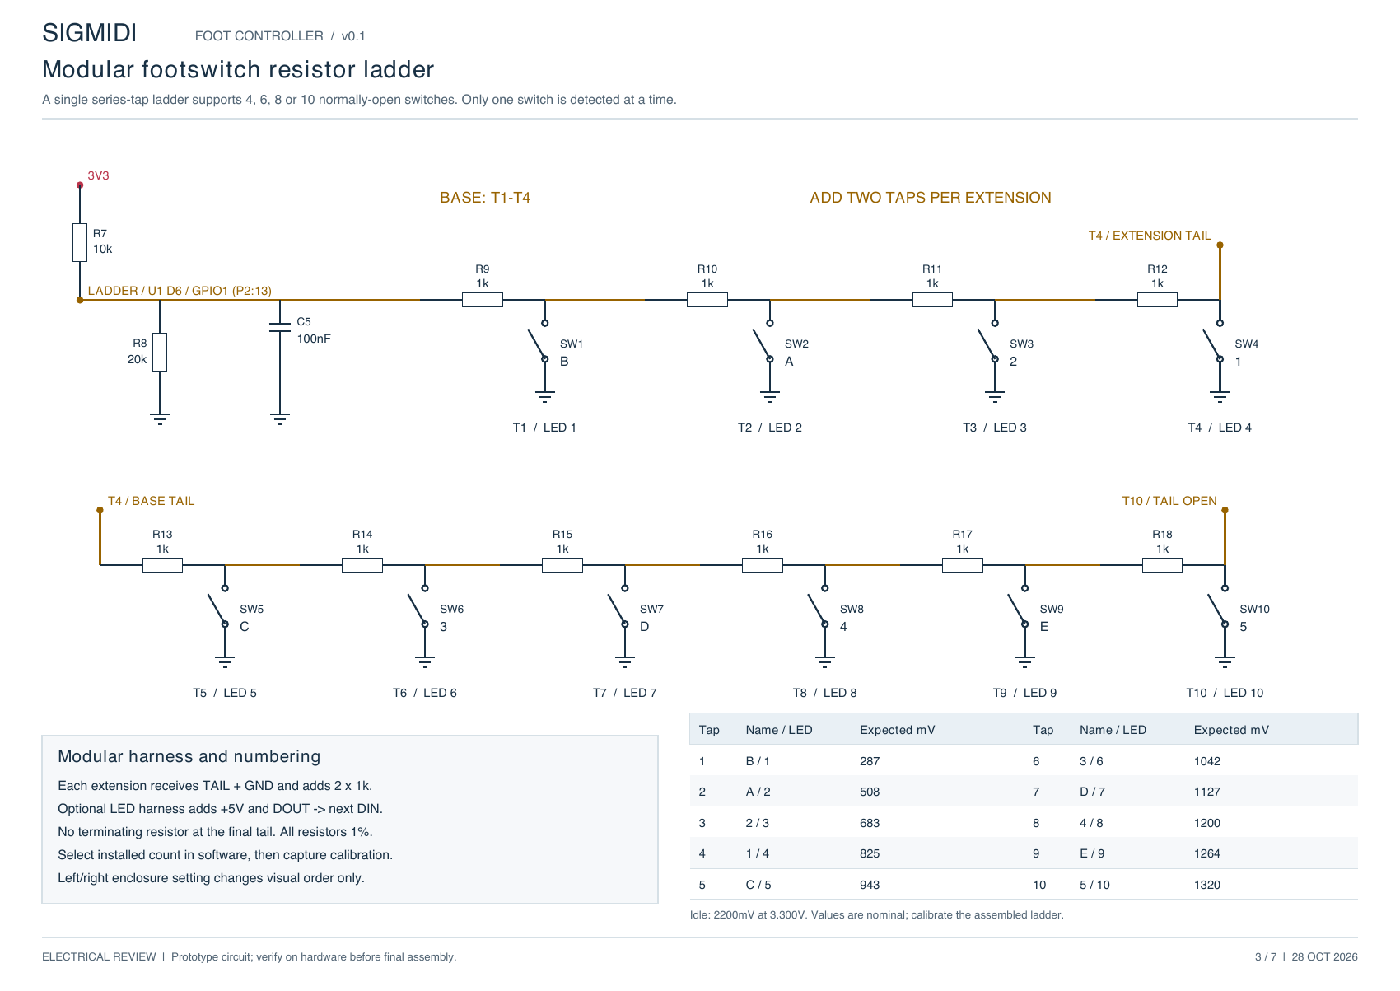
previews/electrical-03.png
