awhite2000/sigmidi/previews/electrical-04.png

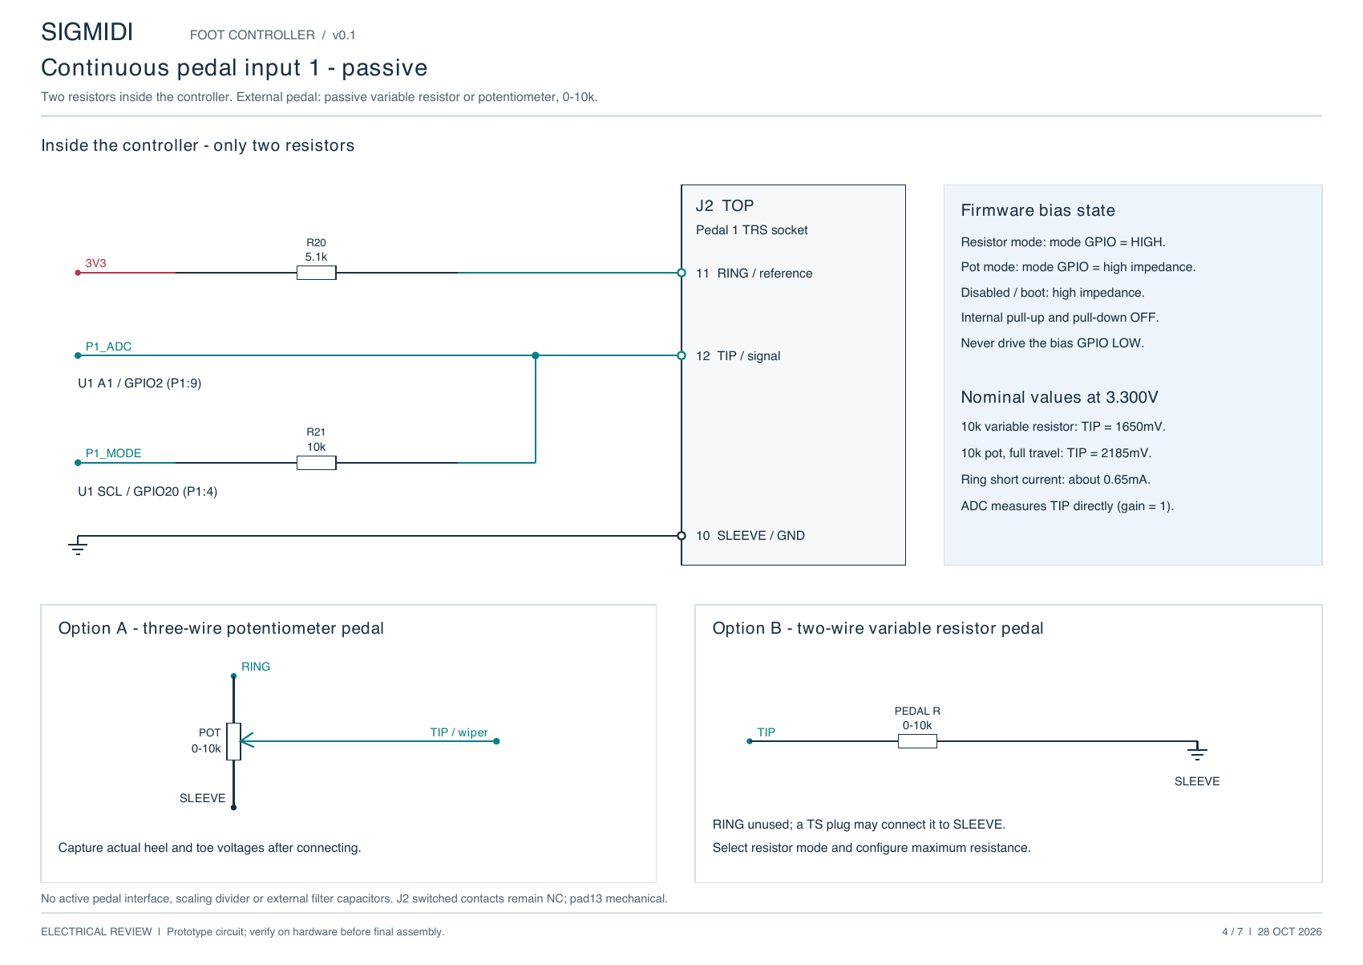
previews/electrical-04.png
