awhite2000/sigmidi/previews/electrical-06.png

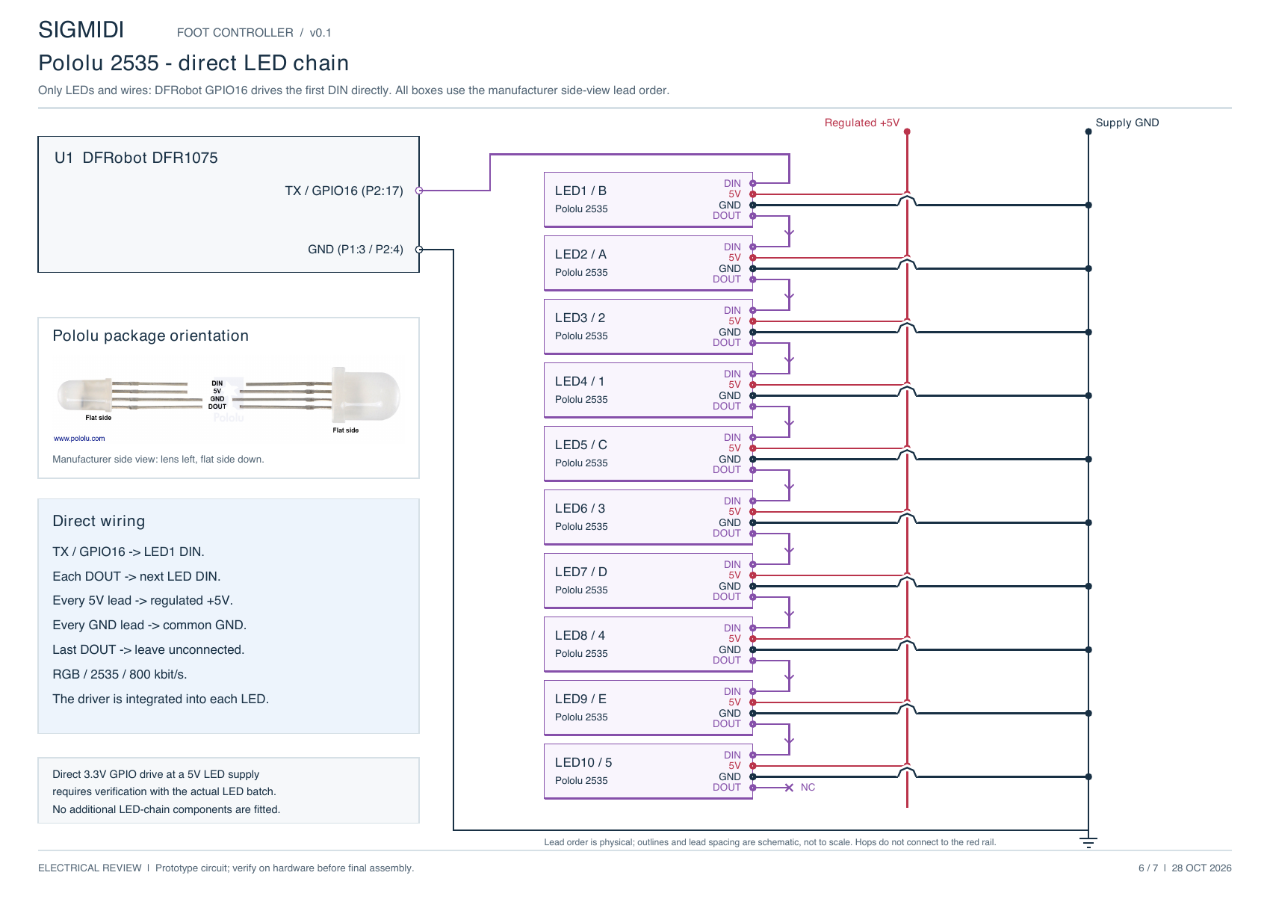
previews/electrical-06.png
