awhite2000/sigmidi/previews/electrical-07.png

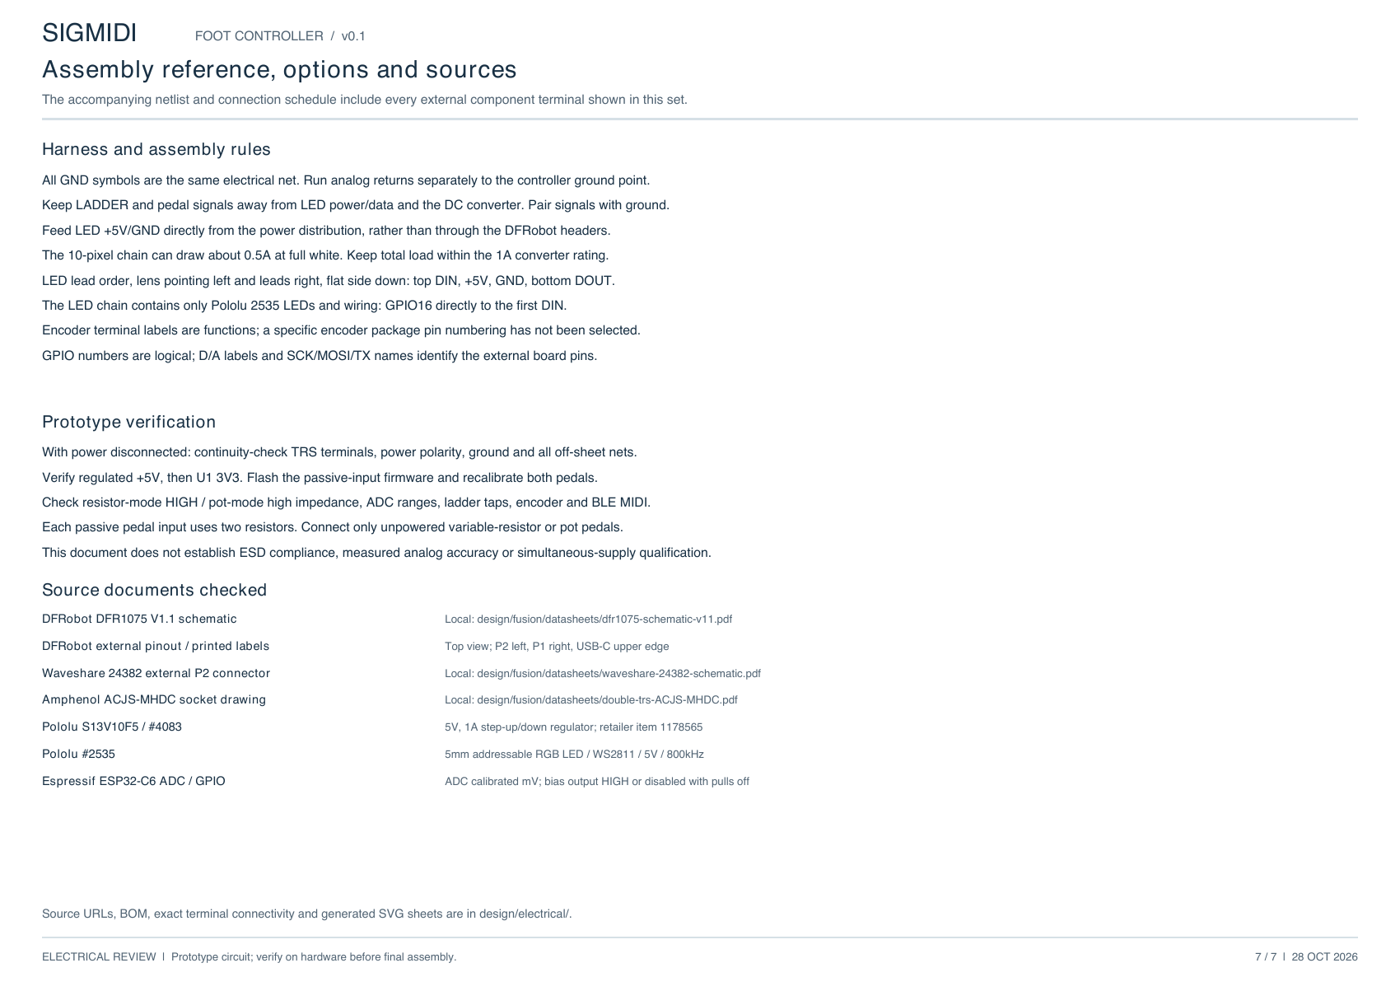
previews/electrical-07.png
