awhite2000/sigmidi/previews/electrical-browser.png

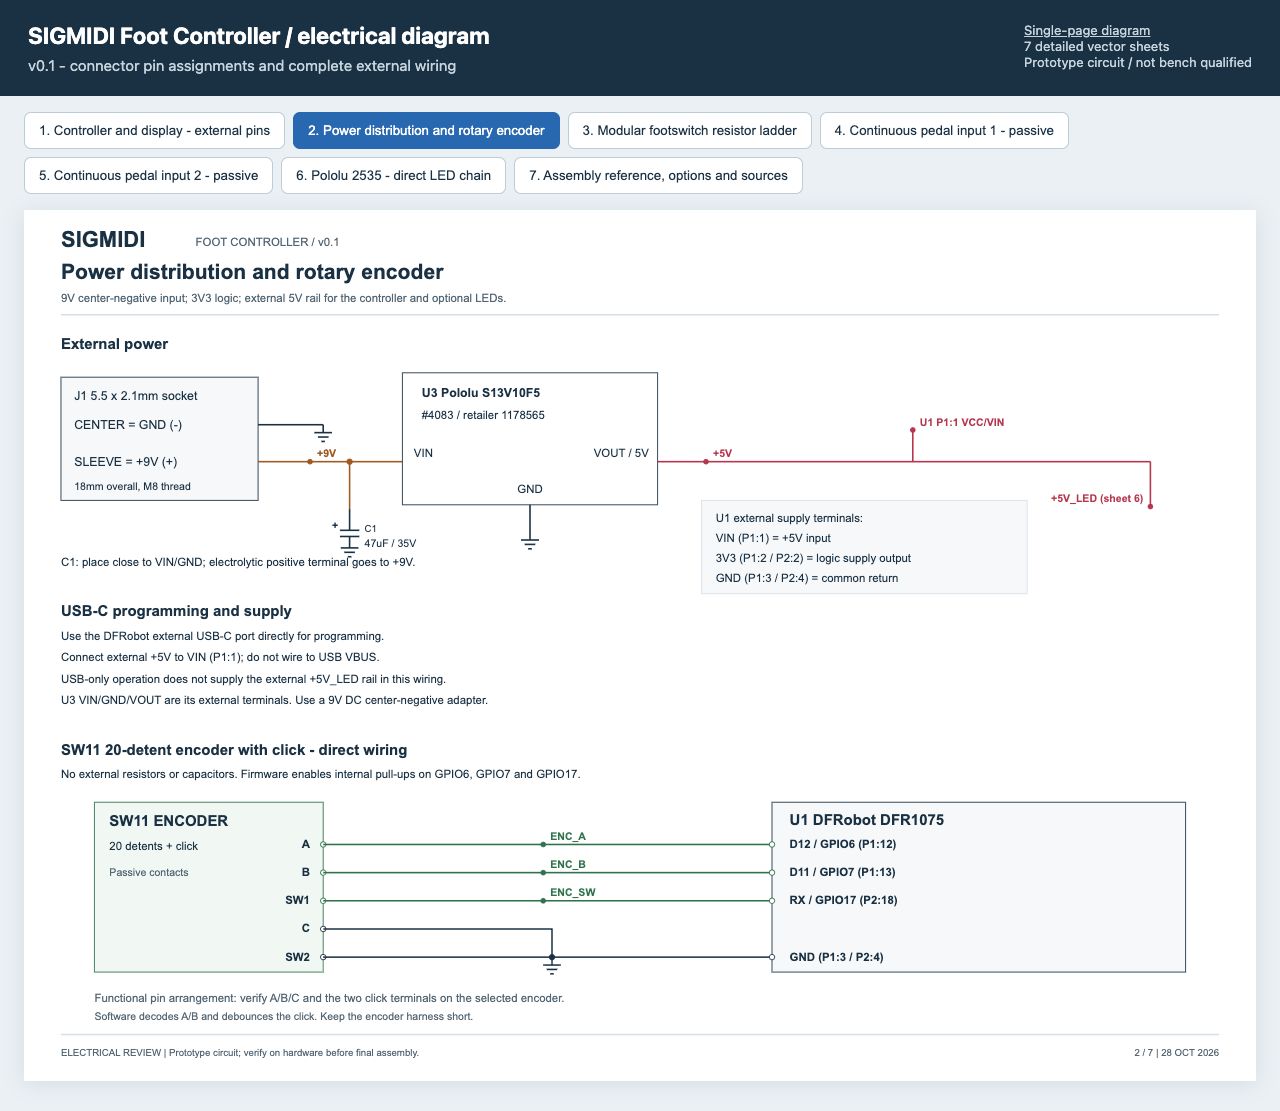
previews/electrical-browser.png
