awhite2000/sigmidi/previews/electrical-single-page-browser.png

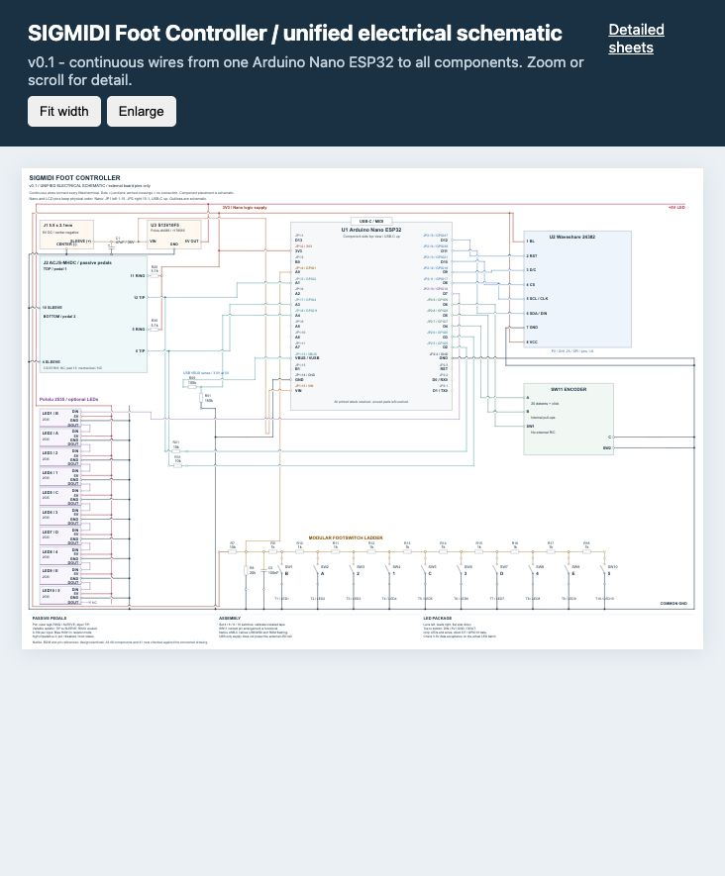
previews/electrical-single-page-browser.png
