awhite2000/sigmidi/previews/electrical-single-page.png

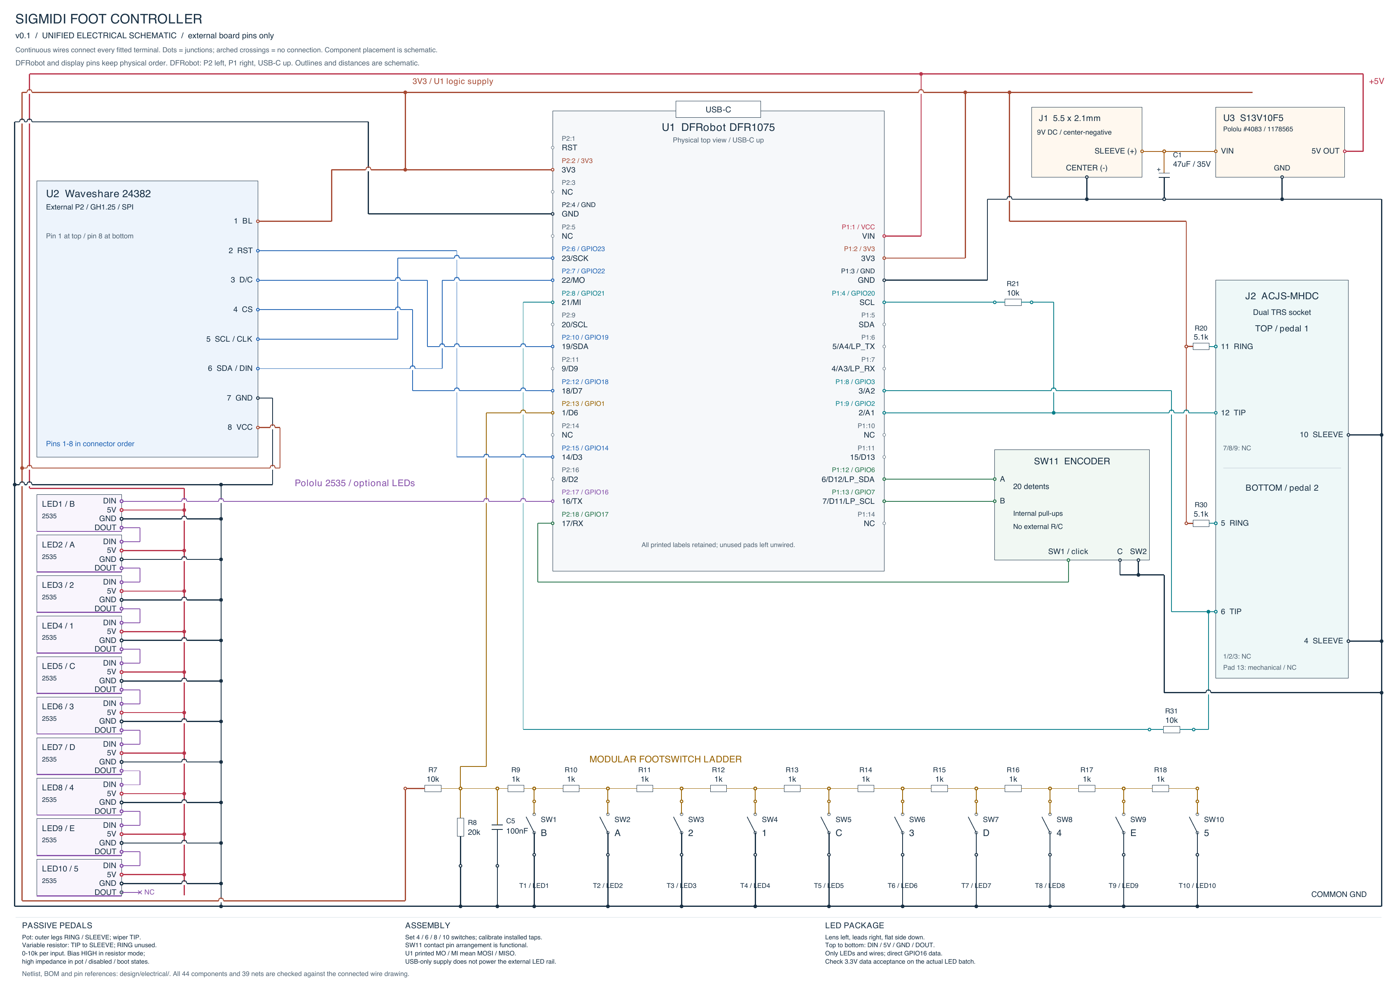
previews/electrical-single-page.png
