awhite2000/sigmidi/previews/enclosure-menu-preview.png

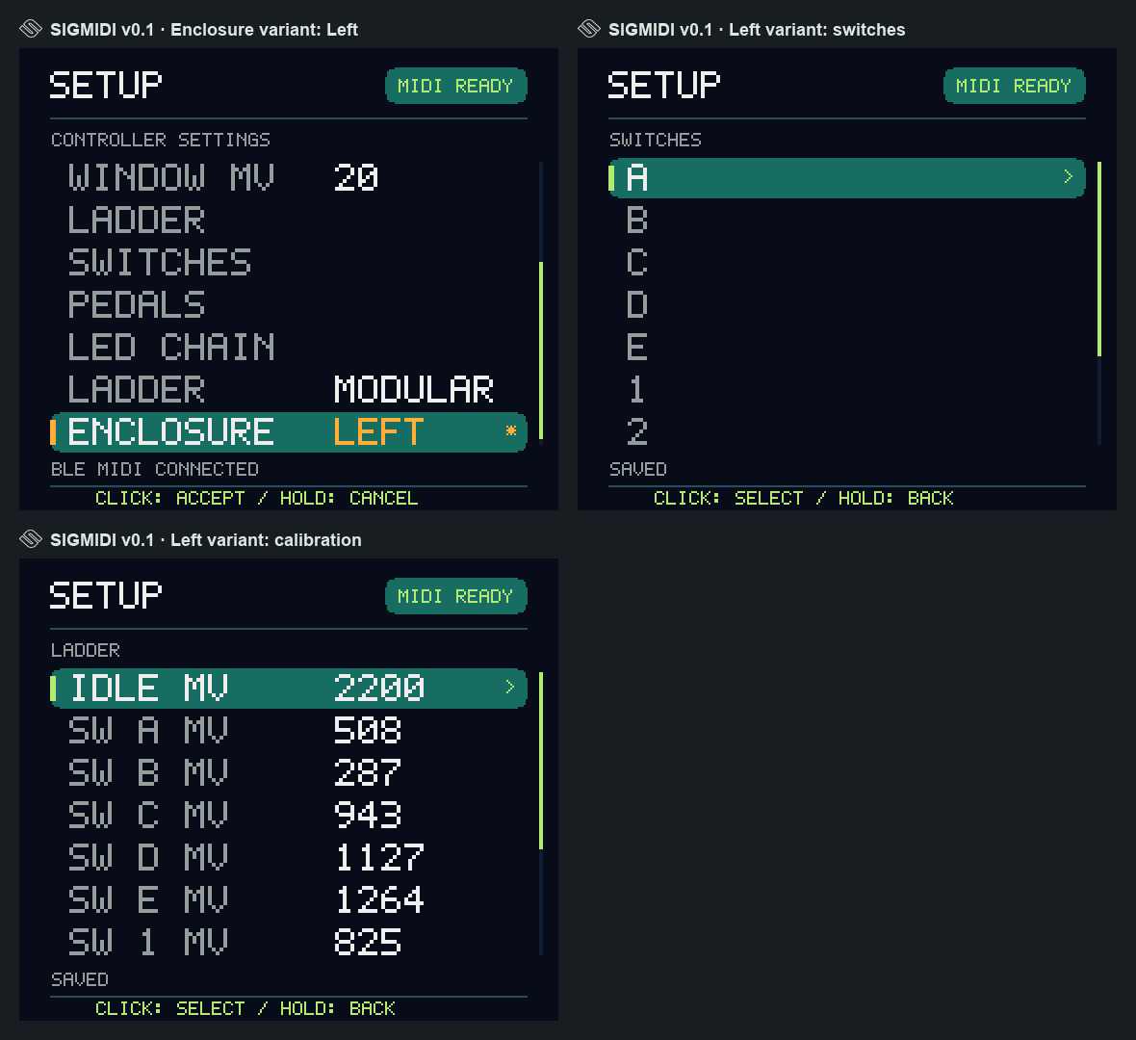
previews/enclosure-menu-preview.png
