awhite2000/sigmidi/previews/enclosure-menus-both-variants.png

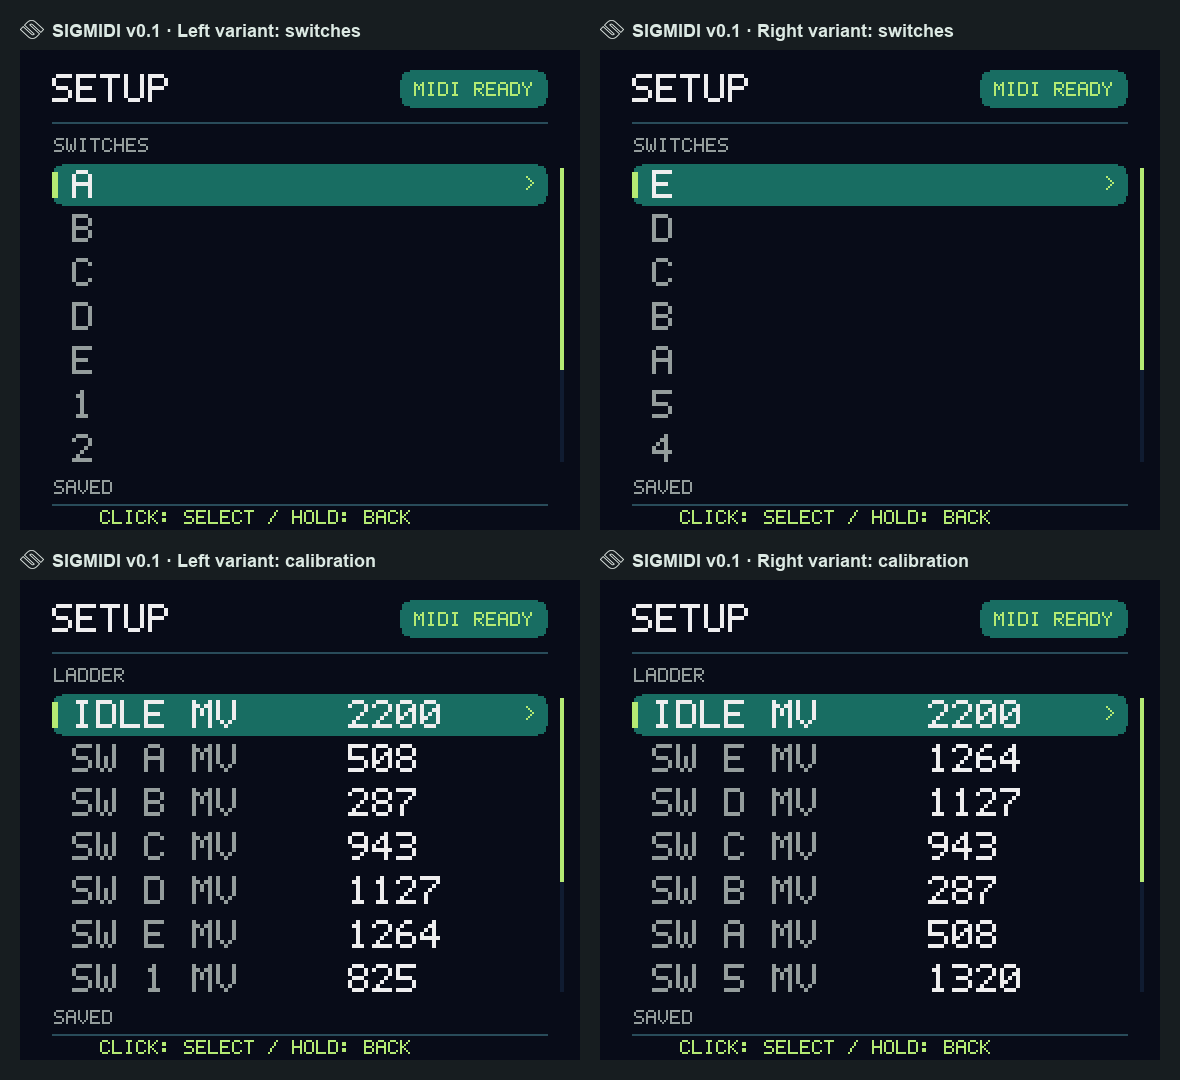
previews/enclosure-menus-both-variants.png
