awhite2000/sigmidi/previews/enclosure-menus-scrolled.png

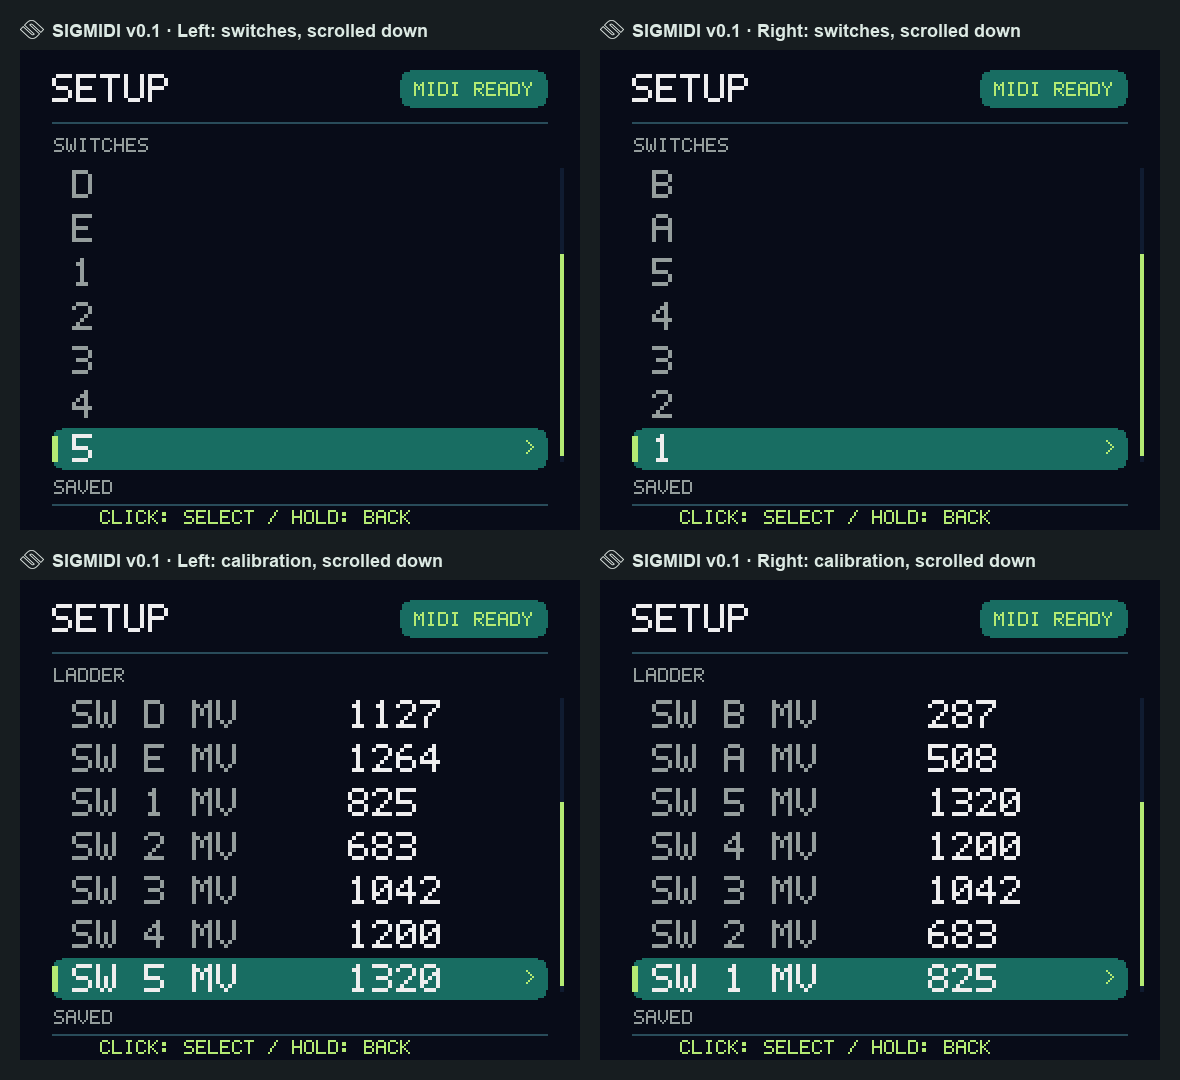
previews/enclosure-menus-scrolled.png
