awhite2000/sigmidi/previews/kicad-schematic-browser.png

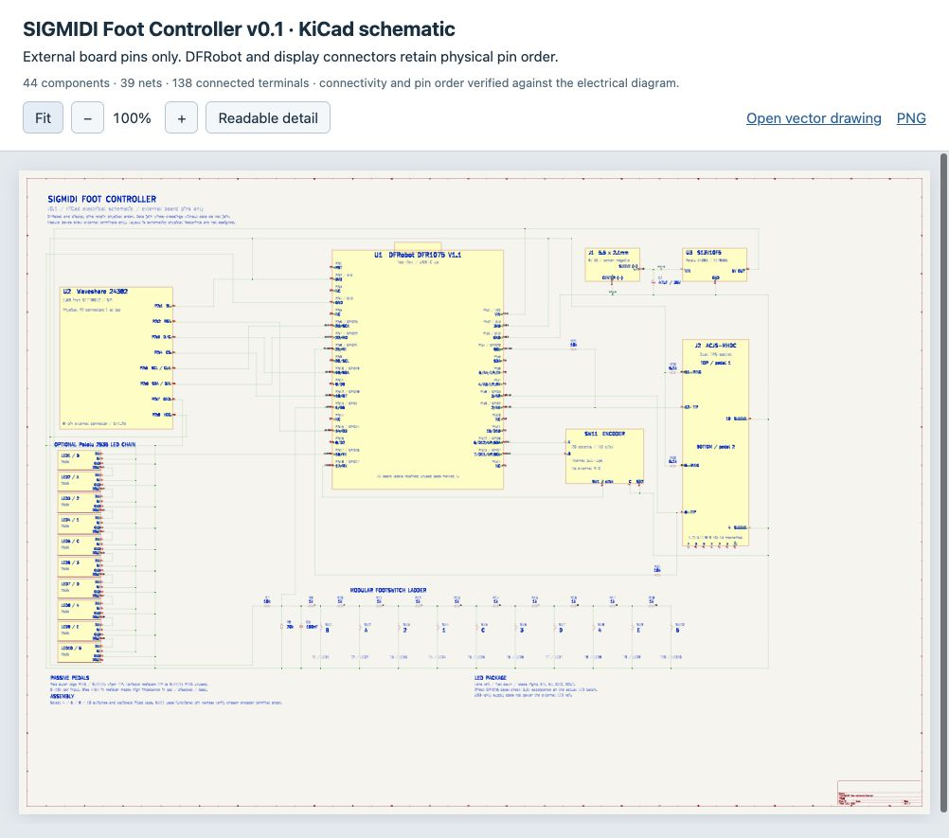
previews/kicad-schematic-browser.png
