awhite2000/sigmidi/previews/led-menu-preview.png

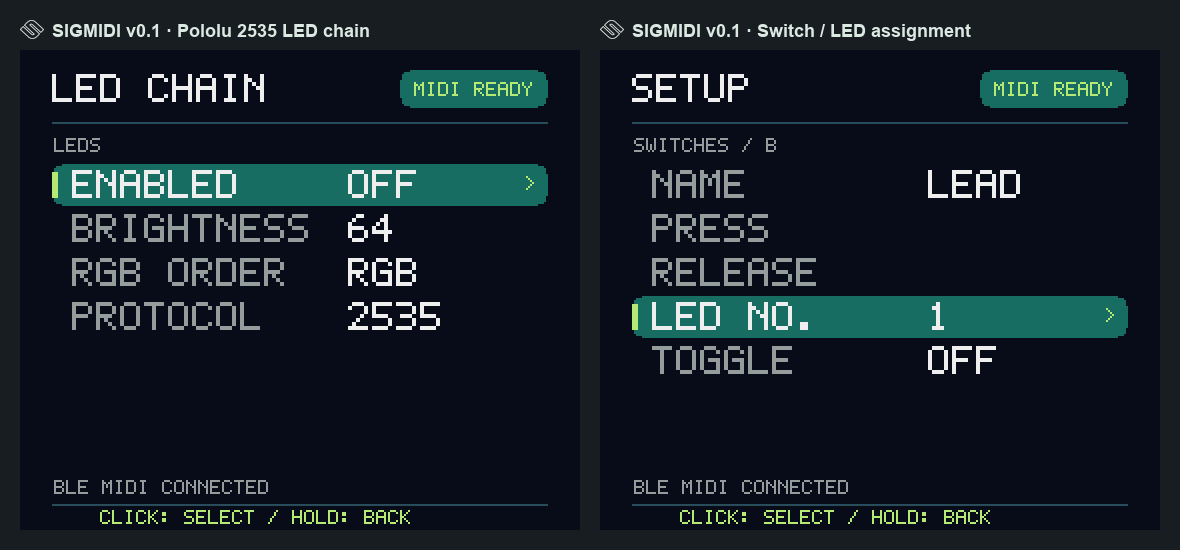
previews/led-menu-preview.png
