awhite2000/sigmidi/previews/menu-editor-preview.png

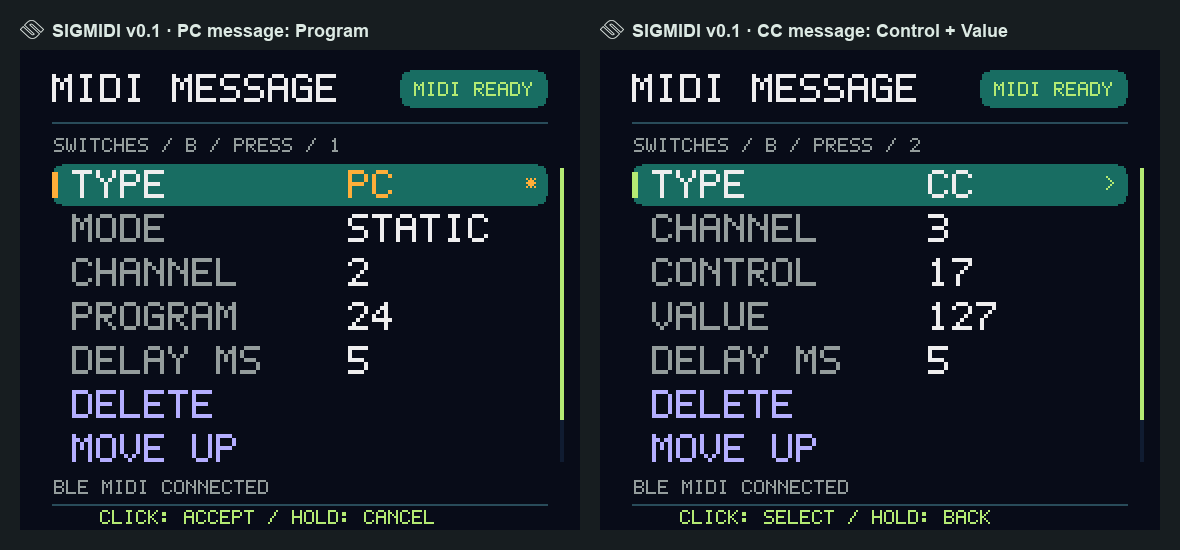
previews/menu-editor-preview.png
