awhite2000/sigmidi/previews/pc-counter-menu-preview.png

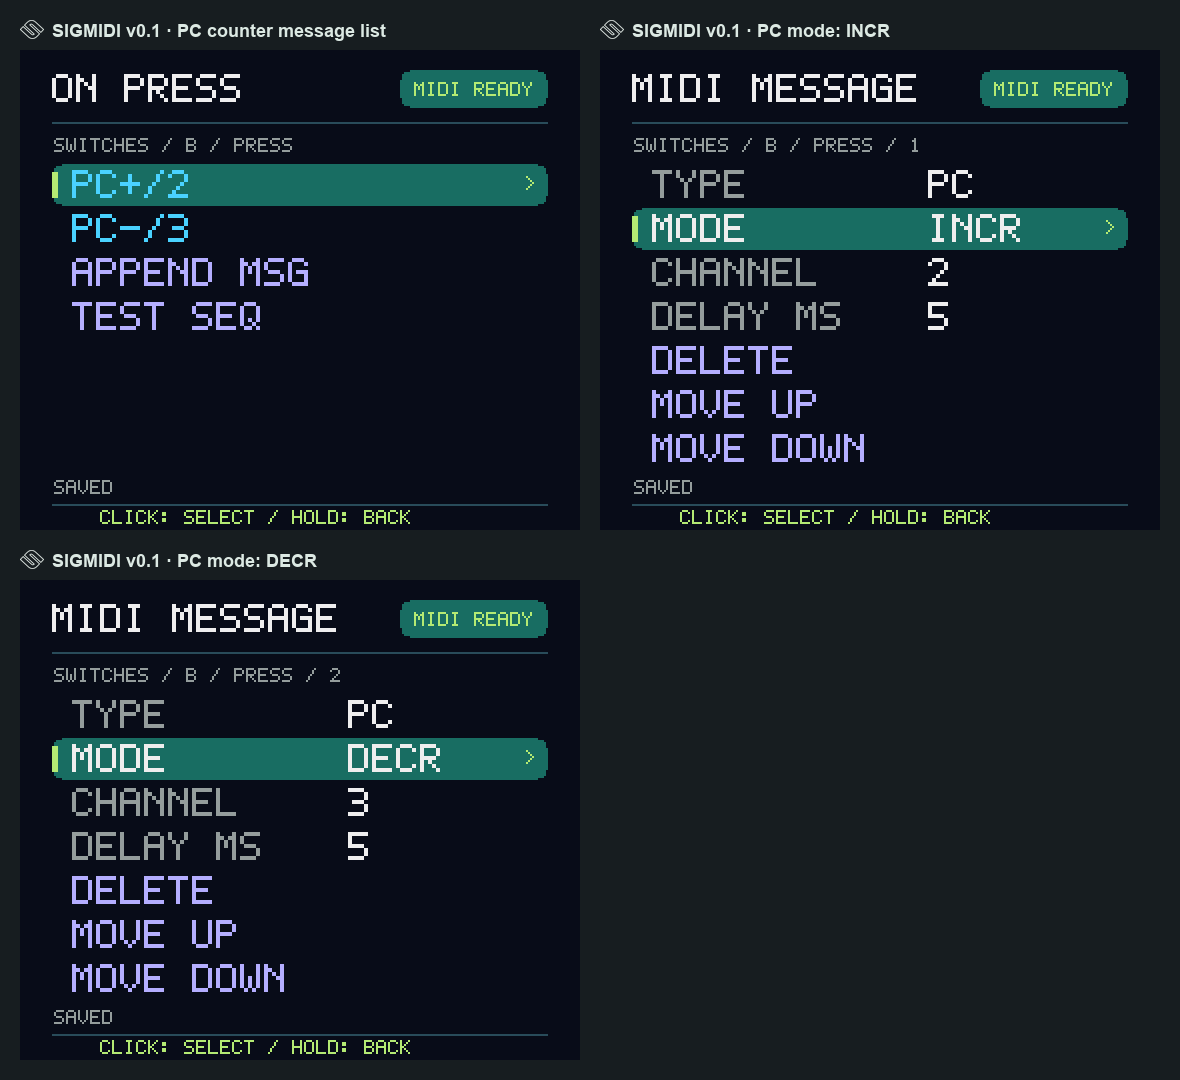
previews/pc-counter-menu-preview.png
