awhite2000/sigmidi/previews/pedal-startup-preview.png

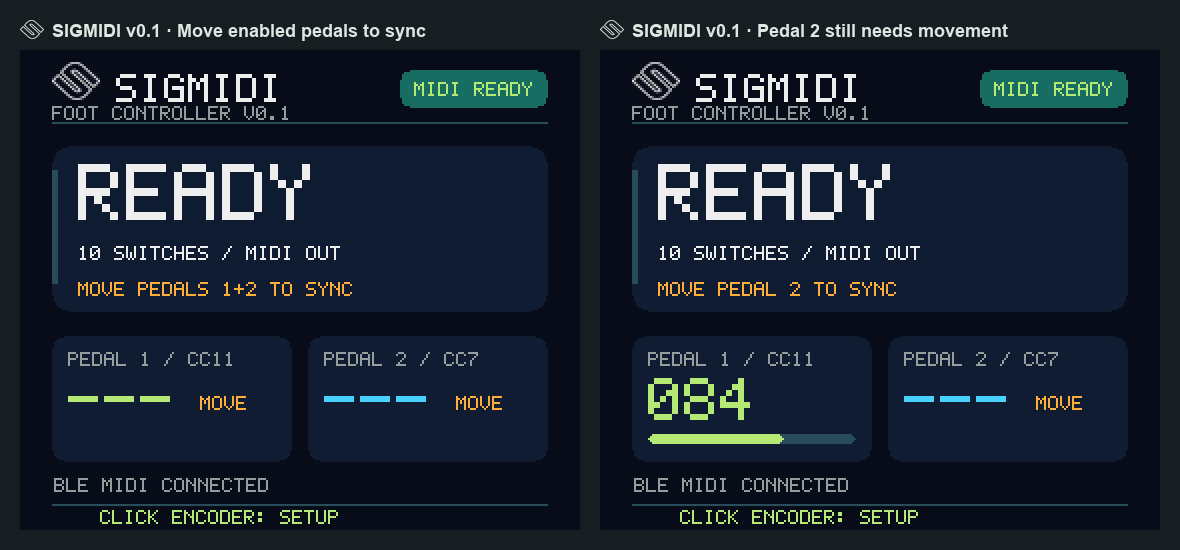
previews/pedal-startup-preview.png
