awhite2000/sigmidi/previews/sigmidi-left-modular.png

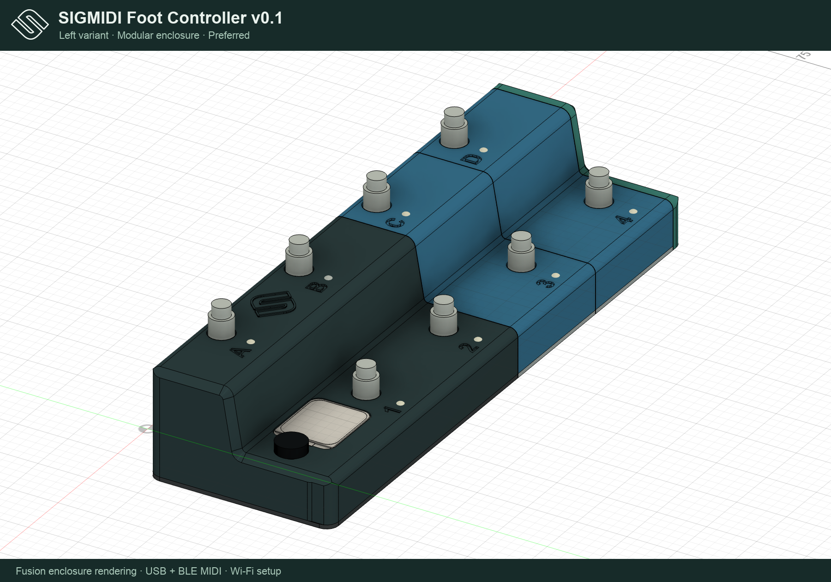
previews/sigmidi-left-modular.png
