awhite2000/sigmidi/previews/sigmidi-right-main.png

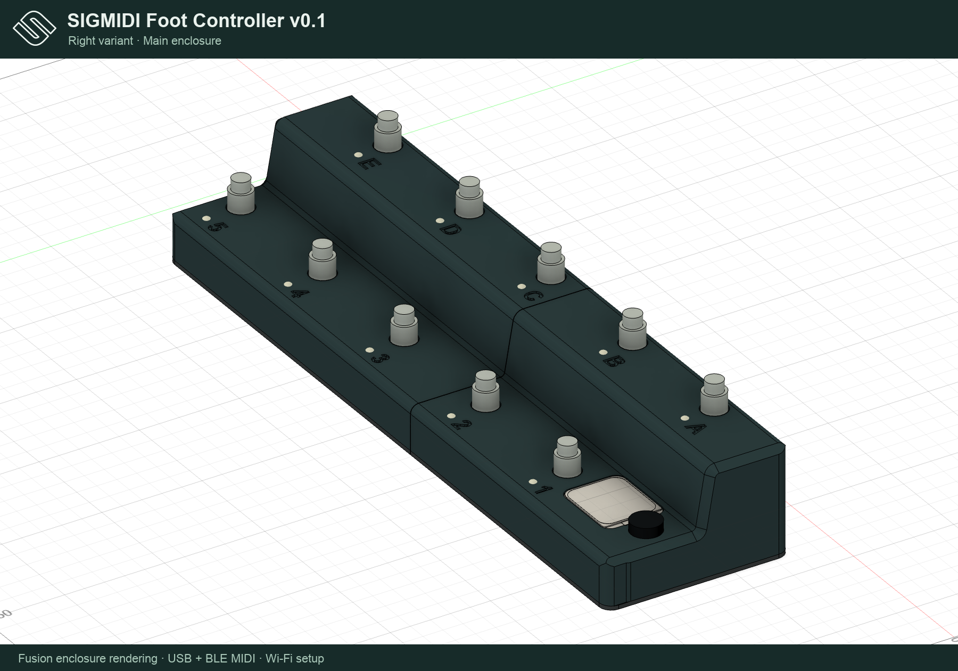
previews/sigmidi-right-main.png
