awhite2000/sigmidi/previews/sigmidi-right-modular.png

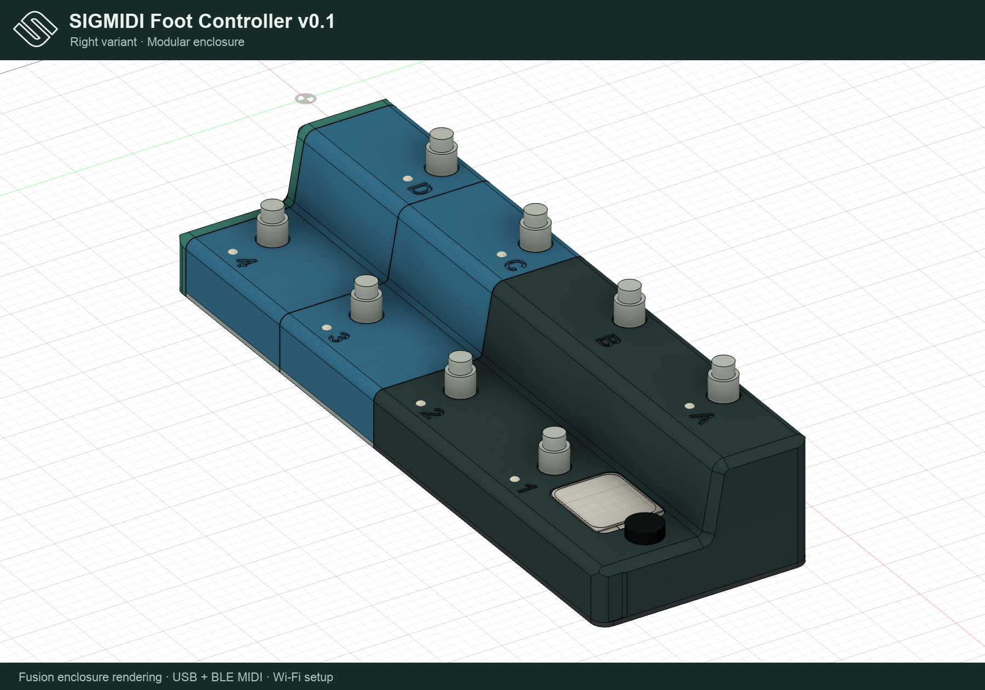
previews/sigmidi-right-modular.png
