awhite2000/sigmidi/previews/toggle-menu-preview.png

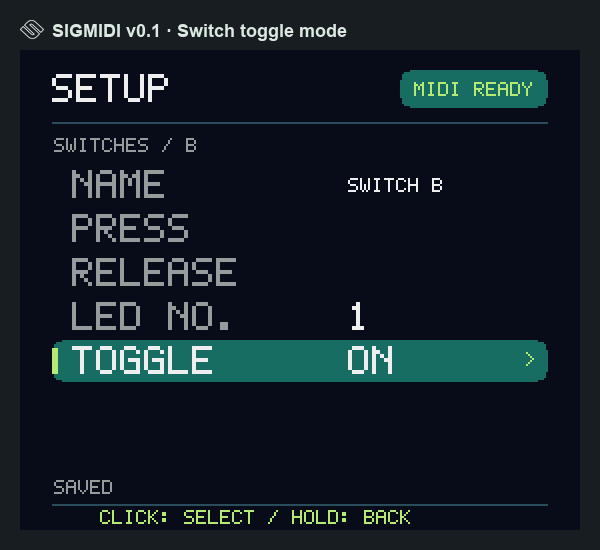
previews/toggle-menu-preview.png
