awhite2000/sigmidi/previews/usb-midi-preview.png

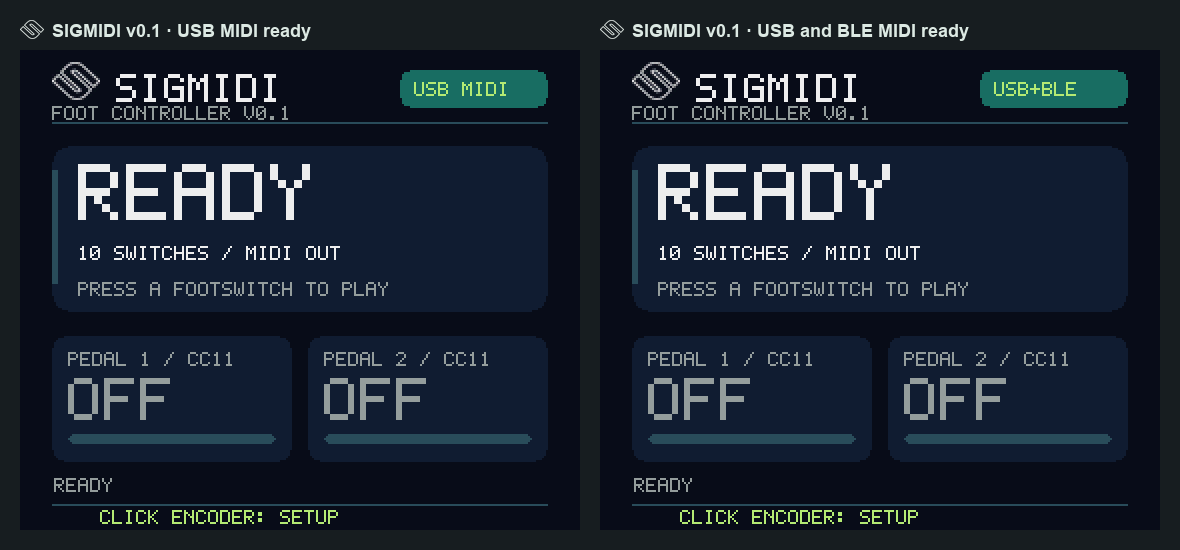
previews/usb-midi-preview.png
