awhite2000/sigmidi/previews/web-flasher.png

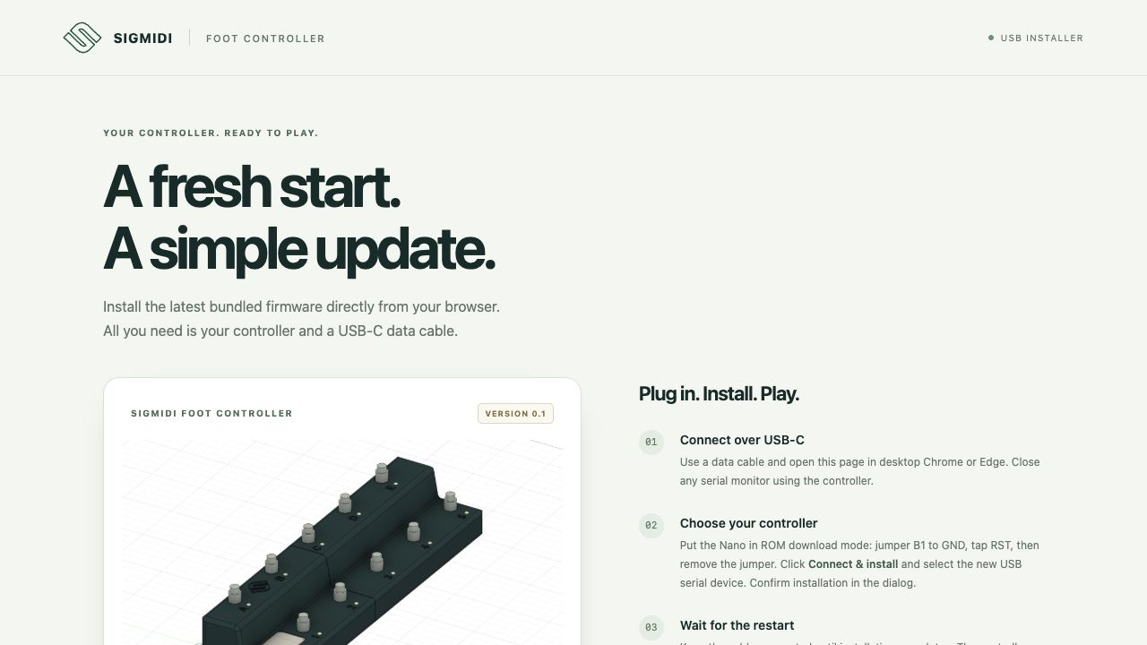
previews/web-flasher.png
