awhite2000/sigmidi/previews/wifi-cc-editor.png

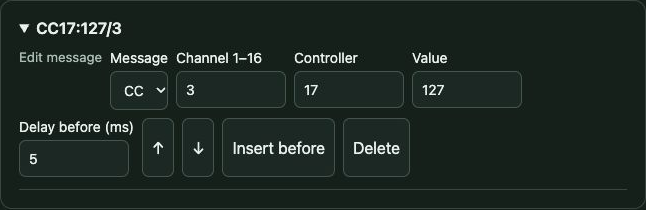
previews/wifi-cc-editor.png
