awhite2000/sigmidi/previews/wifi-left-switches.png

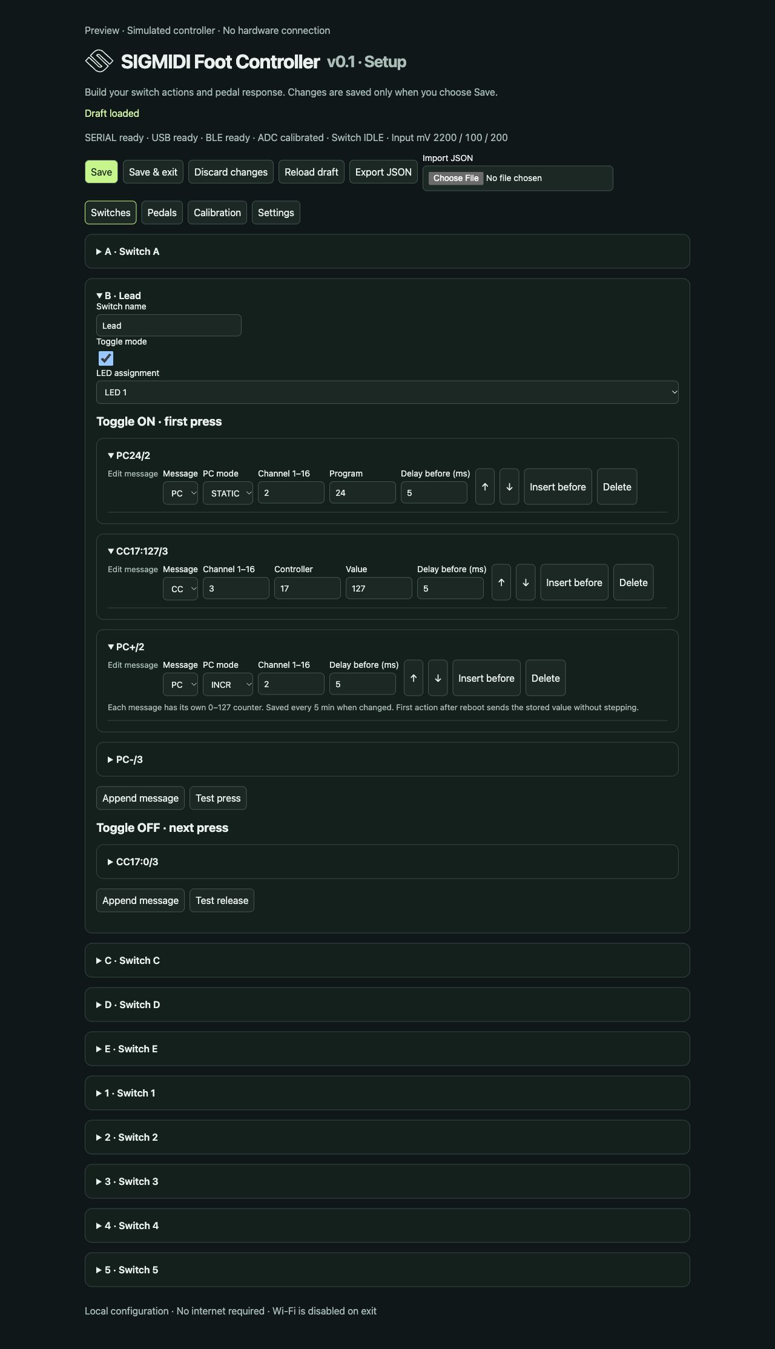
previews/wifi-left-switches.png
