awhite2000/sigmidi/previews/wifi-pc-counters.png

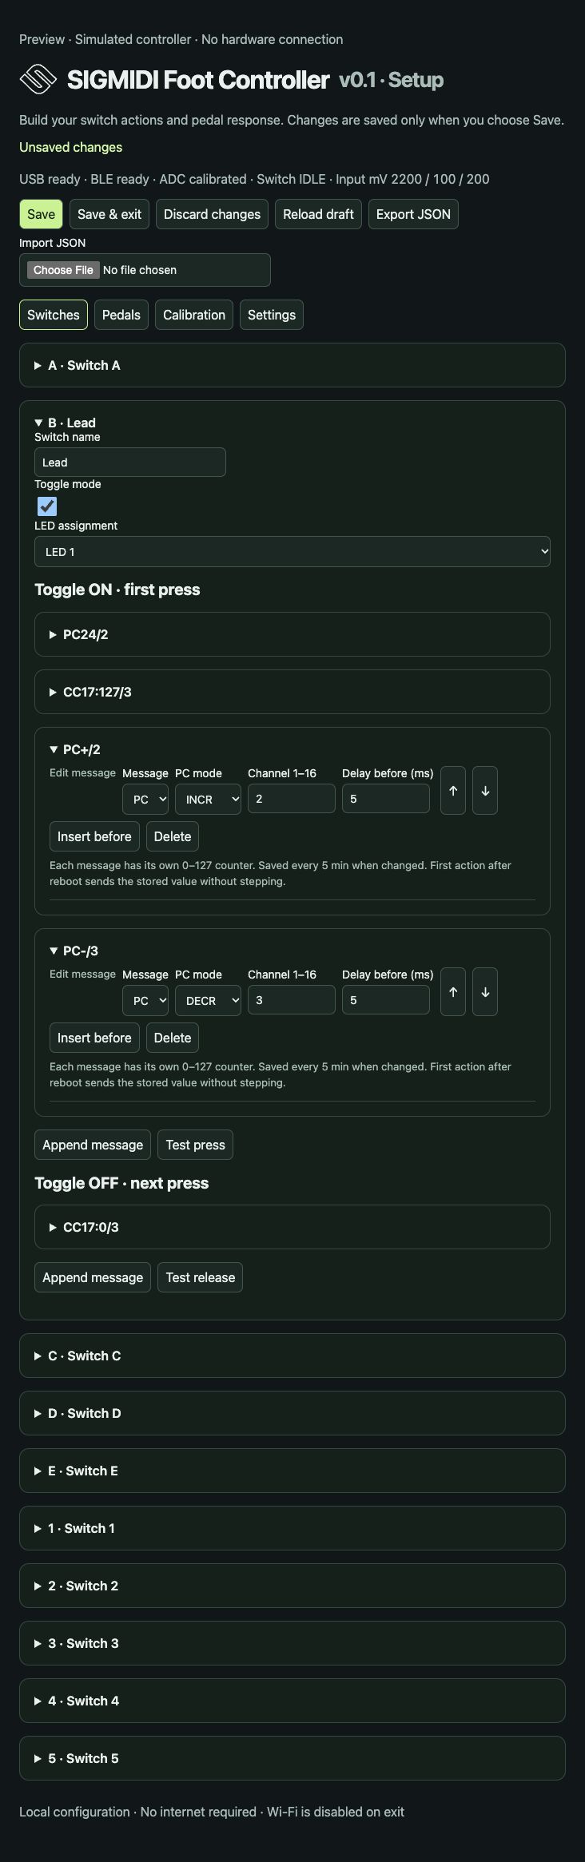
previews/wifi-pc-counters.png
