awhite2000/sigmidi/previews/wifi-pc-editor.png

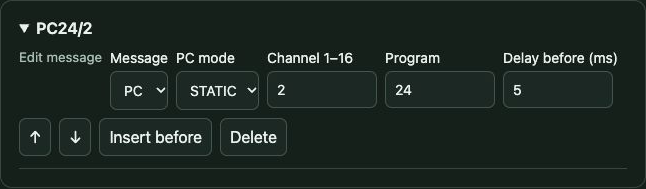
previews/wifi-pc-editor.png
