awhite2000/sigmidi/previews/wifi-pedals.png

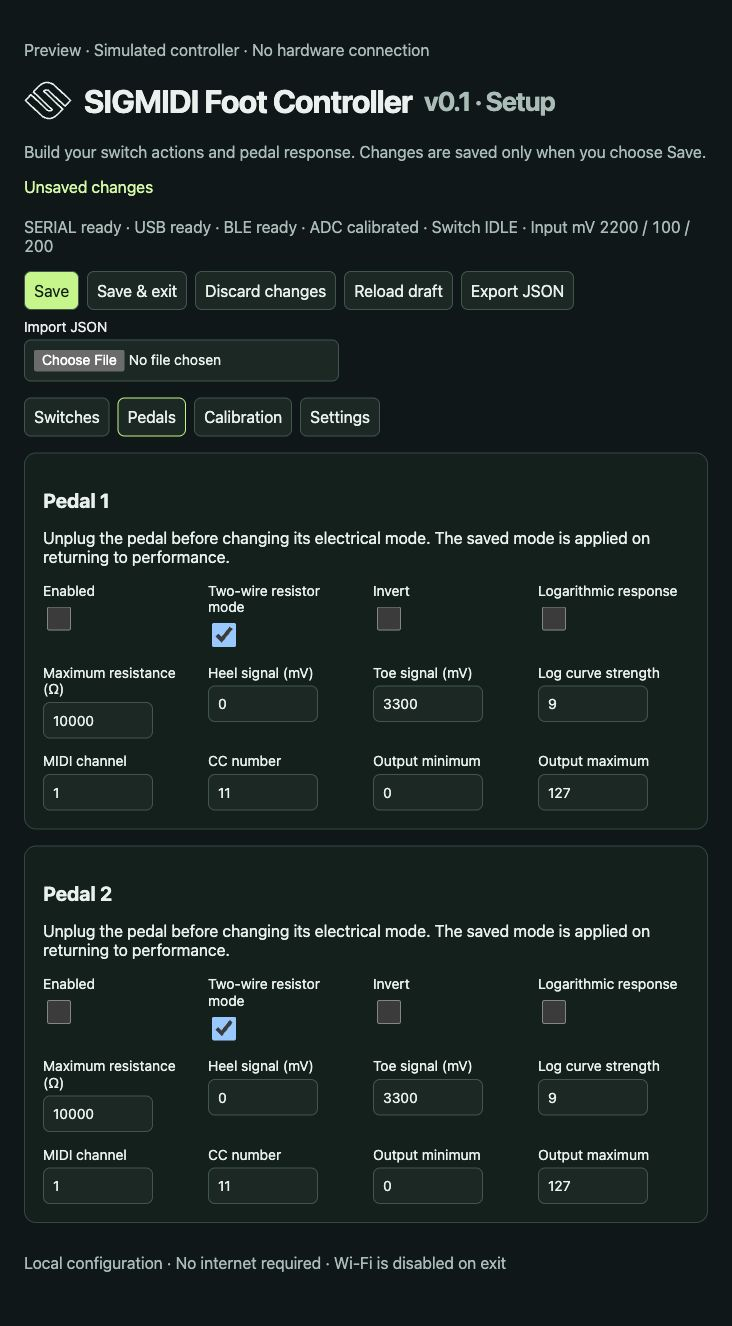
previews/wifi-pedals.png
