awhite2000/sigmidi/previews/wifi-settings.png

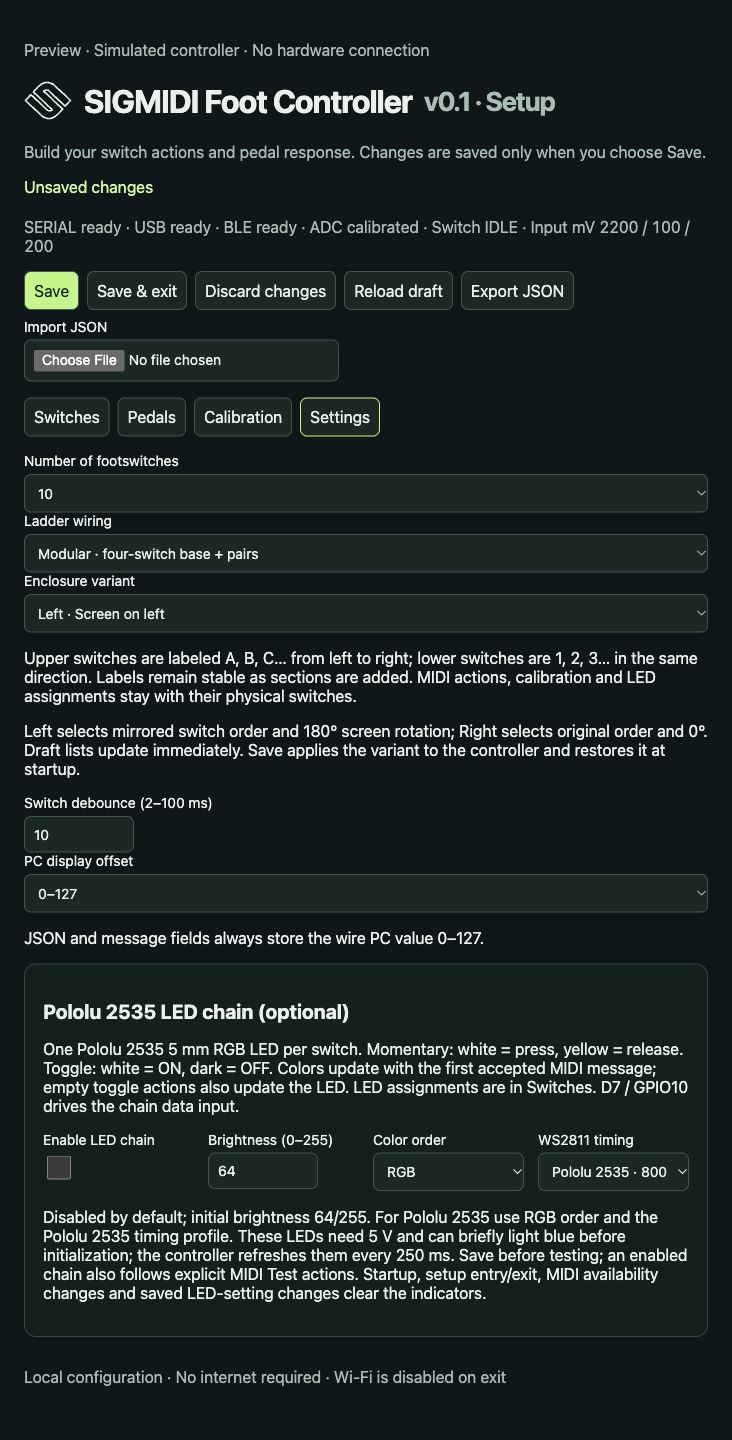
previews/wifi-settings.png
