awhite2000/sigmidi/previews/wifi-switches-both-variants.png

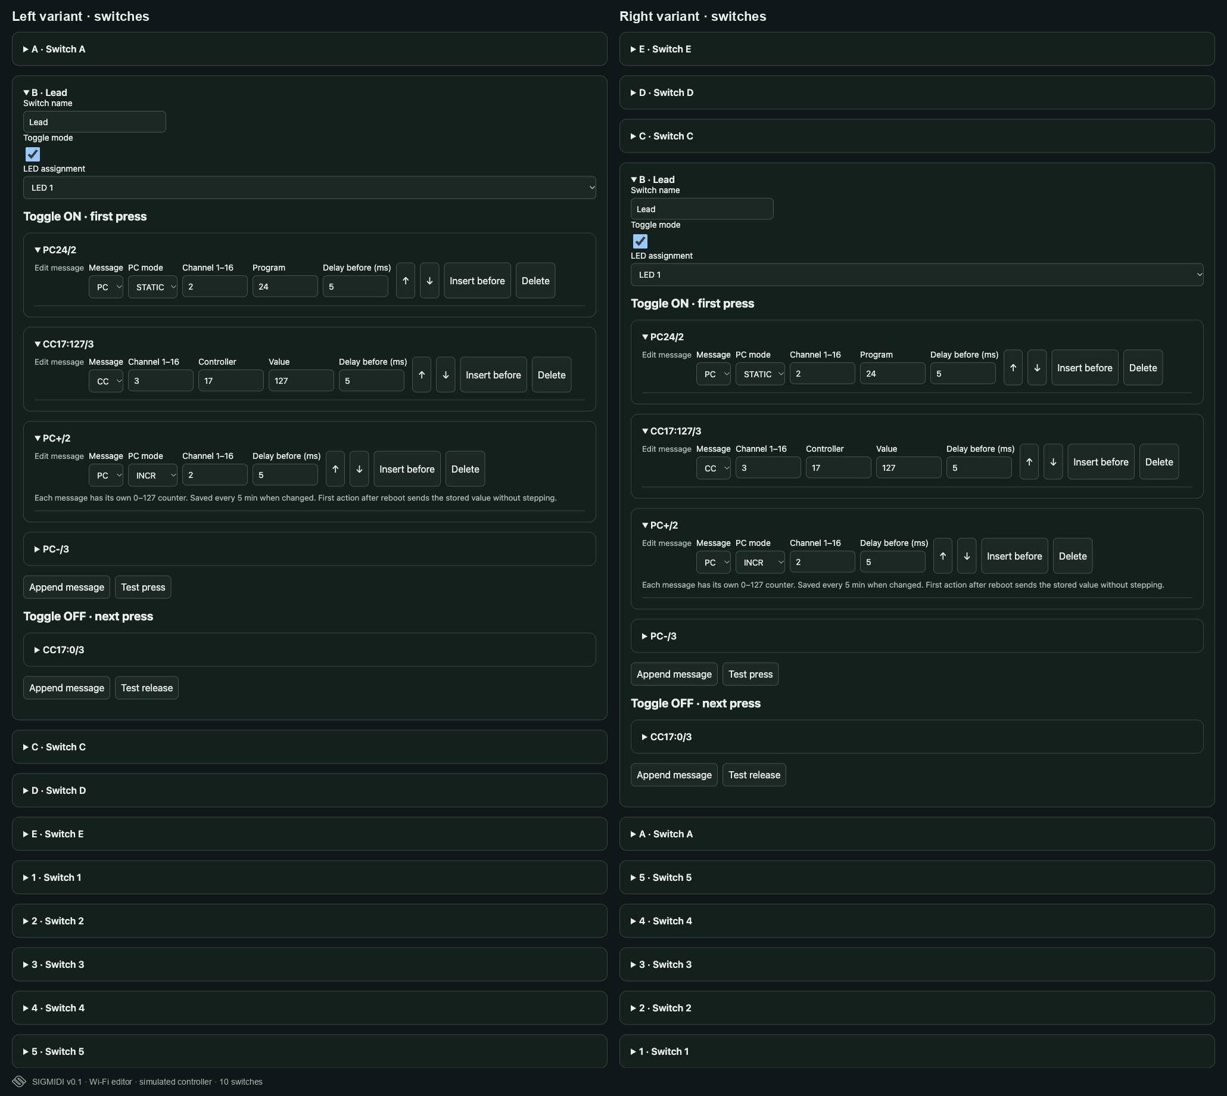
previews/wifi-switches-both-variants.png
