awhite2000/sigmidi/docs/bill-of-materials.csv

ID | Group | Part | Specification | Fit condition | References | Unit | Mod 4 | Mod 6 | Mod 8 | Mod 10 | Main 10 | Purchase unit | Notes | Source
E01 | Core | Arduino Nano ESP32 ABX00083 | ESP32-S3, 16 MB flash; 43.18 x 17.78 mm PCB; without headers | Required | U1 | piece | 1 | 1 | 1 | 1 | 1 | Each | Component-side up, directly on four integral base posts; direct-solder harness. Use Nano GPIO/power map and USB VBUS divider. | https://docs.arduino.cc/hardware/nano-esp32/
E02 | Core | Waveshare 24382 | 1.69inch LCD Module; ST7789V2; 240 x 280 native / 280 x 240 landscape; 31.5 x 39 mm PCB | Required | U2 | piece | 1 | 1 | 1 | 1 | 1 | Each | Non-touch version. Supply/logic 3.3 V in this project; four factory rear M2 studs. | https://www.waveshare.com/wiki/1.69inch_LCD_Module
E03 | Core | Rotary encoder with push switch | Passive quadrature, 20 detents/revolution; normally-open click; 15 x 15 mm body | Required | SW11 | piece | 1 | 1 | 1 | 1 | 1 | Each | Exact manufacturer part not selected. Verify shaft, bushing and detent phase; CAD assumes 6 mm shaft and 8 mm housing height. No external encoder resistors/capacitors. | Project design
E04 | Core | Momentary footswitch | Normally open, non-latching; 12 mm mounting thread; 30 x 13 x 15 mm body; shaft offset 9 mm from short end | Required | SW1 SW2 SW3 SW4 SW5 SW6 SW7 SW8 SW9 SW10 | piece | 4 | 6 | 8 | 10 | 10 | Each | One per installed switch. Match supplied drawing and CAD actuator height; exact orderable part remains to be selected. Do not buy latching switches. | Project design
E05 | Core | 10 kOhm ladder pull-up | 1% metal-film, through-hole; 0.25 W procurement choice | Required | R7 | piece | 1 | 1 | 1 | 1 | 1 | Each |  | Project design
E06 | Core | 20 kOhm idle resistor | 1% metal-film, through-hole; 0.25 W procurement choice | Required | R8 | piece | 1 | 1 | 1 | 1 | 1 | Each |  | Project design
E07 | Core | 1 kOhm ladder sections | 1% metal-film, through-hole; 0.25 W procurement choice | Required | R9 R10 R11 R12 R13 R14 R15 R16 R17 R18 | piece | 4 | 6 | 8 | 10 | 10 | Each | Four in electronics base, plus two per extension. No end-termination resistor. | Project design
E08 | Core | 100 nF ladder filter capacitor | Ceramic, through-hole; >=10 V rating (50 V is suitable) | Required | C5 | piece | 1 | 1 | 1 | 1 | 1 | Each | Connect at GPIO1 / SENSE to ground. | Project design
E09 | Pedals | Amphenol ACJS-MHDC | One dual 6.35 mm switched TRS socket housing; fitted horizontally in chassis | Fit pedal interface | J2 | piece | 1 | 1 | 1 | 1 | 1 | Each | One part provides both pedal inputs. Buy with two nickel nuts and two fiber washers; included hardware is listed separately as fitted content. | design/fusion/datasheets/double-trs-ACJS-MHDC.pdf
E10 | Pedals | 10 kOhm pedal bias resistors | 1% metal-film, through-hole; 0.25 W | Fit both pedal inputs | R21 R31 | piece | 2 | 2 | 2 | 2 | 2 | Each | One per fitted input. If only one input is wired, fit one resistor of this value. | Project design
E11 | Pedals | 5.1 kOhm pedal reference resistors | 1% metal-film, through-hole; 0.25 W | Fit both pedal inputs | R20 R30 | piece | 2 | 2 | 2 | 2 | 2 | Each | One per fitted input. Pedals are entirely passive; no external active interface. | Project design
E12 | Power | Barrel power socket | 5.5 x 2.1 mm; external thread diameter 8 mm, length 8 mm; 4 mm flange/body + 6 mm terminals = 18 mm total | Fit 9 V input | J1 | piece | 1 | 1 | 1 | 1 | 1 | Each | 2 mm retaining nut. Exact supplier part unselected; check flange/nut diameter against CAD. Wire center negative, sleeve positive. | Project design
E13 | Power | Pololu S13V10F5 #4083 | 5 V, nominal 1 A step-up/step-down regulator; about 8.9 x 12.1 mm | Fit 9 V input | U3 | piece | 1 | 1 | 1 | 1 | 1 | Each | Kamami listing 1178565 identifies this module. Use the molded PETG clip mount; no extra screw mount. Current/temperature depend on input and cooling. | https://www.pololu.com/product/4083
E14 | Power | 47 uF input capacitor | Polarized electrolytic; 35 V minimum; compact radial package | Fit 9 V input | C1 | piece | 1 | 1 | 1 | 1 | 1 | Each | Across converter VIN/GND. Chosen value in current schematic; Pololu recommends at least 33 uF for input transients. Verify package clearance. | https://www.pololu.com/product/4083
E15 | LEDs | Pololu 2535 | 5 mm diffused through-hole RGB pixel with integrated WS2811; 5 V; four leads DIN/5V/GND/DOUT | Optional LED feedback | LED1 LED2 LED3 LED4 LED5 LED6 LED7 LED8 LED9 LED10 | piece | 4 | 6 | 8 | 10 | 10 | 10-pack; one pack covers any 4-10 switch build | Installed count is LEDs, not packs. Direct D7/GPIO10 data requires batch/harness verification. | https://www.pololu.com/product/2535
H01 | Hardware | Base screws | M2 x 6 mm countersunk | Required |  | piece | 4 | 6 | 8 | 10 | 8 | Each | Modular: four in electronics base plus two per extension; integral cap uses none. Main enclosure uses eight. | Project design
H02 | Hardware | Display screws | M2 x 5 mm countersunk | Required |  | piece | 4 | 4 | 4 | 4 | 4 | Each | Four hollow posts and factory blind M2 studs. Nominal engagement 1.39 mm; verify actual screws do not bottom out. | Project design
H03 | Hardware | Nano PCB screws | M1.6 x 5 mm pan head | Required |  | piece | 4 | 4 | 4 | 4 | 4 | Each | Four screws through the 1.61 mm PCB into 4.3 mm-deep integral-post pilots; nominal engagement 3.39 mm. Confirm actual printed fit. | Project design
H04 | Hardware | Footswitch mounting hardware | Matching nuts and washer set supplied for each selected footswitch | Required |  | set | 4 | 6 | 8 | 10 | 10 | Included with footswitch; verify contents | Reference drawing shows two nuts and one washer per switch. Do not double-order included sets. | Project design
H05 | Hardware | Encoder knob | 15 mm diameter x 5 mm height; bore matched to selected shaft | Required |  | piece | 1 | 1 | 1 | 1 | 1 | Each | CAD assumes 6 mm shaft diameter; shaft form/length not specified. Knob is not one of the enclosure print files. | Project design
H06 | Hardware | Encoder panel hardware | Matching retaining nut and washer | Required |  | set | 1 | 1 | 1 | 1 | 1 | Included with encoder where supplied | Check bushing length through the 3 mm roof. | Project design
H07 | Hardware | TRS panel hardware | Two nickel nuts and two black fiber washers for ACJS-MHDC | Fit pedal interface |  | set | 1 | 1 | 1 | 1 | 1 | Included with J2 where supplied | Count as contents of the socket assembly; no additional saddle screw is specified. | Project design
H08 | Hardware | DC socket retaining nut | Matching 8 mm thread; 2 mm thick | Fit 9 V input |  | piece | 1 | 1 | 1 | 1 | 1 | Included with J1 where supplied |  | Project design
W01 | Wiring | LCD cable | GH1.25, 8-pin mating cable; verify orientation and signal labels | Required |  | piece | 1 | 1 | 1 | 1 | 1 | Check Waveshare package before buying separately | One cable assembly. No MISO required; BL tied to 3.3 V. | Project design
W02 | Wiring | Signal hookup wire | Stranded, insulated 26-28 AWG; assorted purpose colors | Required |  | length | AR | AR | AR | AR | AR | Planning allowance: about 5 m total | Allowance, not a measured cut list. Include switch ladder, encoder, pedal, control and optional LED data routes. | Project design
W03 | Wiring | Supply/return wire | Stranded, insulated 22-24 AWG | Required |  | length | AR | AR | AR | AR | AR | Planning allowance: about 2 m total | Regulated supply, common ground and optional LED distribution; check actual voltage drop and load. | Project design
W04 | Wiring | Carrier perfboard and U4 socket | 80.5 x 20 x 1.5 mm perfboard, 6 x 28 holes at 2.5 mm pitch, four 3 mm mounting holes on 76 x 16 mm, four 2 x 3.5 mm pads at each end, plus one DIP-14 socket; carries the U1-side passives, ladder top segment and TRS MIDI OUT stage | Required |  | set | 1 | 1 | 1 | 1 | 1 | Each | Layout in assembly guide step 7: bare tinned trails plus three insulated links. Mount at base level under the dual TRS socket, beside the Nano, on insulated standoffs or tape. | Project design
W05 | Wiring | Insulation and strain relief | Heat-shrink, small ties/anchors and insulating sleeves | Required |  | set | AR | AR | AR | AR | AR | Each | Leave slack between upper-shell ports and removable base; keep vents and USB withdrawal path clear. | Project design
M01 | Assembly | PETG filament | For the selected supplied enclosure print files | Required |  | mass | AR | AR | AR | AR | AR | A 1 kg spool is a practical stock allowance, not part consumption | Current profiles: Prusa MK3S+, 0.6 mm nozzle, 0.3 mm layers. Use slicer mass including supports, brim and coupons. | Project design
M02 | Assembly | PETG-compatible adhesive | For upper joint chain and removable-base joint chain | Required |  | set | AR | AR | AR | AR | AR | Each | Select adhesive rated for PETG and test a coupon. Do not glue removable bases to upper shells or cap-floor butt seam. | Project design
M03 | Assembly | Non-slip feet / clearance pads | Maintain >=3 mm open space beneath floor vents | Recommended; not CAD-modeled |  | piece | 4 | 4 | 4 | 4 | 4 | Each | Place away from vent slots and screws. Verify stability; fit additional pads if needed. | Project design
P01 | Printed parts | Electronics upper shell | PETG enclosure solid; print one selected orientation per listed piece | Required |  | piece | 1 | 1 | 1 | 1 | 1 | Each | Left: mirrored/main/shell-left; modular reuses same electronics geometry. | Project design
P02 | Printed parts | Electronics base | PETG enclosure solid; print one selected orientation per listed piece | Required |  | piece | 1 | 1 | 1 | 1 | 1 | Each | Left: mirrored/main/base-left; modular reuses same geometry. | Project design
P03 | Printed parts | Main outer upper shell | PETG enclosure solid; print one selected orientation per listed piece | Required |  | piece | 0 | 0 | 0 | 0 | 1 | Each | Left main shell-right only; omit for modular. | Project design
P04 | Printed parts | Main outer base | PETG enclosure solid; print one selected orientation per listed piece | Required |  | piece | 0 | 0 | 0 | 0 | 1 | Each | Left main base-right only; omit for modular. | Project design
P05 | Printed parts | Repeatable pair upper | PETG enclosure solid; print one selected orientation per listed piece | Required |  | piece | 0 | 0 | 1 | 2 | 0 | Each | Left modular: C/3 then D/4; choose correct engraved variant. | Project design
P06 | Printed parts | Cap-adjacent pair upper | PETG enclosure solid; print one selected orientation per listed piece | Required |  | piece | 0 | 1 | 1 | 1 | 0 | Each | Left modular: final C/3, D/4 or E/5 at the cap. | Project design
P07 | Printed parts | Universal pair base | PETG enclosure solid; print one selected orientation per listed piece | Required |  | piece | 0 | 1 | 2 | 3 | 0 | Each | Same pair-base at every extension, including next to cap. | Project design
P08 | Printed parts | Integral-floor end cap | PETG enclosure solid; print one selected orientation per listed piece | Required |  | piece | 1 | 1 | 1 | 1 | 0 | Each | Left modular right-cap; no detachable floor or cap screws. | Project design
A01 | External accessories | USB-C data cable | Suitable USB host/source end | For flashing / USB power |  | piece | 1 | 1 | 1 | 1 | 1 | Each | Do not use a charge-only cable for flashing. | Project design
A02 | External accessories | USB 5 V source | Capacity for measured controller and any USB-powered LED load | If using USB supply |  | piece | 1 | 1 | 1 | 1 | 1 | Each | Do not assume converter-side LED power is present when only USB is connected. | Project design
A03 | External accessories | 9 V DC adapter / pedalboard output | Center-negative 5.5 x 2.1 mm; >=1 A procurement allowance | If using 9 V input |  | piece | 1 | 1 | 1 | 1 | 1 | Each | Supply allowance does not raise the Pololu module output/thermal rating. | Project design
A04 | External accessories | Passive continuous pedal | Variable resistor or potentiometer, up to 10 kOhm | Optional; one per used input |  | piece | 2 | 2 | 2 | 2 | 2 | Each | User-owned pedals; verify TS/TRS wiring and calibrate. May fit zero, one or two. | Project design
A05 | External accessories | BLE MIDI DIN dongle | Central-role support and third-party peripheral compatibility | For direct HX Stomp connection |  | piece | 1 | 1 | 1 | 1 | 1 | Each | External to controller. Exact dongle not specified; verify pairing with SIGMIDI. HX Stomp/iPad and their power supplies are not controller BOM parts. | Project design
E16 | Core | USB VBUS sense upper resistor | 100 kOhm, 1%, 0.25 W | Required | R50 | piece | 1 | 1 | 1 | 1 | 1 | Each | VBUS to A4 / GPIO11 divider node; required for self-powered USB operation.
E17 | Core | USB VBUS sense lower resistor | 150 kOhm, 1%, 0.25 W | Required | R51 | piece | 1 | 1 | 1 | 1 | 1 | Each | A4 / GPIO11 divider node to GND. Never connect VBUS directly to GPIO.
E18 | MIDI OUT | 74HCT125 quad buffer | 5 V TTL-compatible quad buffer; DIP-14 or SOIC-14; gates 1 and 2 used with inputs 2/5 joined and /OE 1/4 grounded; unused inputs 9/12 and /OE 10/13 to GND | Required for TRS MIDI output | U4 | piece | 1 | 1 | 1 | 1 | 1 | Each | Power from isolated MIDI_5V; 100 nF bypass close to pins 14/7. Output 1Y drives J3, 2Y drives J4. Verify exact package pinout before wiring. | Texas Instruments SN74HCT125 datasheet
E19 | MIDI OUT | 1N5819 Schottky diodes | 40 V, 1 A Schottky rectifier, DO-41; source-isolation diode OR | Required for TRS MIDI output | D1 D2 | piece | 2 | 2 | 2 | 2 | 2 | Each | Anodes: converter +5 V and USB VBUS; cathodes joined as MIDI_5V. Prevents back-feed between supplies. Check diode polarity. | Project design
E20 | MIDI OUT | 10 kOhm UART idle pull-up | 1% metal-film, through-hole; 0.25 W. Terminals 3V3 to MIDI_OUT_TX | Required for TRS MIDI output | R52 | piece | 1 | 1 | 1 | 1 | 1 | Each | Holds both 74HCT125 inputs high during Nano reset; 1% metal-film. | Project design
E21 | MIDI OUT | 220 Ohm MIDI current-loop resistor | 1% metal-film, through-hole; 0.25 W. Terminals MIDI_5V to J3_RING / J4_RING | Required for TRS MIDI output | R53 R55 | piece | 2 | 2 | 2 | 2 | 2 | Each | 1% metal-film; current-source leg to each TRS ring (DIN pin 4). | Project design
E22 | MIDI OUT | 220 Ohm MIDI current-loop resistor | 1% metal-film, through-hole; 0.25 W. Terminals TX_GATE1 to J3_TIP / TX_GATE2 to J4_TIP | Required for TRS MIDI output | R54 R56 | piece | 2 | 2 | 2 | 2 | 2 | Each | 1% metal-film; buffered sink leg to each TRS tip (DIN pin 5). | Project design
E23 | MIDI OUT | 100 nF buffer bypass capacitor | 100 nF X7R ceramic, >=10 V, through-hole or 1206. Terminals MIDI_5V to GND | Required for TRS MIDI output | C6 | piece | 1 | 1 | 1 | 1 | 1 | Each | Ceramic, >=10 V; place directly across 74HCT125 supply pins. | Project design
E24 | MIDI OUT | 3.5 mm TRS MIDI OUT sockets | 3.5 mm stereo (TRS) panel-mount socket; wired MIDI TRS Type A | Required for TRS MIDI output | J3 J4 | piece | 2 | 2 | 2 | 2 | 2 | Each | Tip = DIN pin 5 (sink), ring = DIN pin 4 (source), sleeve = DIN pin 2 shield to GND. Verify tip/ring/sleeve lugs on the selected socket. | Project design
