awhite2000/sigmidi/design/electrical/bom.csv

Quantity (10-switch maximum) | References | Value | Package / type
1 | U1 | Arduino Nano ESP32 ABX00083 | ESP32-S3 board
1 | U2 | Waveshare 24382 | 1.69 inch ST7789V2 LCD module
1 | J1 | 5.5x2.1mm center-negative | 18mm barrel socket / M8
1 | U3 | Pololu S13V10F5 #4083 | 5V 1A step-up/down module
1 | C1 | 47uF / 35V | capacitor
1 | R50 | 100k | 1% resistor
1 | R51 | 150k | 1% resistor
1 | SW11 | 20-detent rotary encoder + NO click | passive encoder
3 | R7 R21 R31 | 10k | 1% resistor
1 | R8 | 20k | 1% resistor
1 | C5 | 100nF | capacitor
10 | R9 R10 R11 R12 R13 R14 R15 R16 R17 R18 | 1k | 1% resistor
10 | SW1 SW2 SW3 SW4 SW5 SW6 SW7 SW8 SW9 SW10 | momentary NO | 12mm footswitch
1 | J2 | Amphenol ACJS-MHDC | dual switched TRS
2 | R20 R30 | 5.1k | 1% resistor
10 | LED1 LED2 LED3 LED4 LED5 LED6 LED7 LED8 LED9 LED10 | Pololu 2535 | 5mm WS2811 pixel
1 | U4 | 74HCT125 | DIP-14/SOIC-14 quad buffer
1 | R52 | 10k | UART idle-high pull-up
2 | D1 D2 | 1N5819 | DO-41 Schottky OR diode
1 | C6 | 100nF | local bypass capacitor
2 | J3 J4 | 3.5 mm TRS MIDI OUT | 3.5 mm stereo panel socket
4 | R53 R54 R55 R56 | 220R | 1% resistor
