awhite2000/sigmidi/design/electrical/connections.csv

Component | Value | Terminal | Physical board label | Logical GPIO / signal | Net | Note
U1 | Arduino Nano ESP32 ABX00083 | JP1:1 | D13 | GPIO48 | NC
U1 | Arduino Nano ESP32 ABX00083 | JP1:2 | 3V3 | 3V3 | 3V3
U1 | Arduino Nano ESP32 ABX00083 | JP1:3 | B0 | GPIO46 | NC
U1 | Arduino Nano ESP32 ABX00083 | JP1:4 | A0 | GPIO1 | LADDER
U1 | Arduino Nano ESP32 ABX00083 | JP1:5 | A1 | GPIO2 | P1_ADC
U1 | Arduino Nano ESP32 ABX00083 | JP1:6 | A2 | GPIO3 | NC
U1 | Arduino Nano ESP32 ABX00083 | JP1:7 | A3 | GPIO4 | P2_ADC
U1 | Arduino Nano ESP32 ABX00083 | JP1:8 | A4 | GPIO11 | USB_SENSE
U1 | Arduino Nano ESP32 ABX00083 | JP1:9 | A5 | GPIO12 | NC
U1 | Arduino Nano ESP32 ABX00083 | JP1:10 | A6 | GPIO13 | NC
U1 | Arduino Nano ESP32 ABX00083 | JP1:11 | A7 | GPIO14 | NC
U1 | Arduino Nano ESP32 ABX00083 | JP1:12 | VBUS / VUSB | VBUS | USB_VBUS
U1 | Arduino Nano ESP32 ABX00083 | JP1:13 | B1 | GPIO0 | NC
U1 | Arduino Nano ESP32 ABX00083 | JP1:14 | GND | GND | GND
U1 | Arduino Nano ESP32 ABX00083 | JP1:15 | VIN | VIN | +9V
U1 | Arduino Nano ESP32 ABX00083 | JP2:15 | D12 | GPIO47 | LCD_RST
U1 | Arduino Nano ESP32 ABX00083 | JP2:14 | D11 | GPIO38 | LCD_DIN
U1 | Arduino Nano ESP32 ABX00083 | JP2:13 | D10 | GPIO21 | LCD_CS
U1 | Arduino Nano ESP32 ABX00083 | JP2:12 | D9 | GPIO18 | LCD_DC
U1 | Arduino Nano ESP32 ABX00083 | JP2:11 | D8 | GPIO17 | LCD_CLK
U1 | Arduino Nano ESP32 ABX00083 | JP2:10 | D7 | GPIO10 | LED_GPIO
U1 | Arduino Nano ESP32 ABX00083 | JP2:9 | D6 | GPIO9 | ENC_SW
U1 | Arduino Nano ESP32 ABX00083 | JP2:8 | D5 | GPIO8 | ENC_B
U1 | Arduino Nano ESP32 ABX00083 | JP2:7 | D4 | GPIO7 | ENC_A
U1 | Arduino Nano ESP32 ABX00083 | JP2:6 | D3 | GPIO6 | P2_MODE
U1 | Arduino Nano ESP32 ABX00083 | JP2:5 | D2 | GPIO5 | P1_MODE
U1 | Arduino Nano ESP32 ABX00083 | JP2:4 | GND | GND | GND
U1 | Arduino Nano ESP32 ABX00083 | JP2:3 | RST | RST | NC
U1 | Arduino Nano ESP32 ABX00083 | JP2:2 | D0 / RX0 | GPIO44 | MIDI_OUT_TX
U1 | Arduino Nano ESP32 ABX00083 | JP2:1 | D1 / TX0 | GPIO43 | NC
U2 | Waveshare 24382 | P2:1 |  |  | 3V3
U2 | Waveshare 24382 | P2:2 |  |  | LCD_RST
U2 | Waveshare 24382 | P2:3 |  |  | LCD_DC
U2 | Waveshare 24382 | P2:4 |  |  | LCD_CS
U2 | Waveshare 24382 | P2:5 |  |  | LCD_CLK
U2 | Waveshare 24382 | P2:6 |  |  | LCD_DIN
U2 | Waveshare 24382 | P2:7 |  |  | GND
U2 | Waveshare 24382 | P2:8 |  |  | 3V3
J1 | 5.5x2.1mm center-negative | CENTER |  |  | GND
J1 | 5.5x2.1mm center-negative | SLEEVE |  |  | +9V
U3 | Pololu S13V10F5 #4083 | VIN |  |  | +9V
U3 | Pololu S13V10F5 #4083 | GND |  |  | GND
U3 | Pololu S13V10F5 #4083 | VOUT |  |  | +5V
C1 | 47uF / 35V | 1 |  |  | +9V
C1 | 47uF / 35V | 2 |  |  | GND
R50 | 100k | 1 |  |  | USB_VBUS
R50 | 100k | 2 |  |  | USB_SENSE
R51 | 150k | 1 |  |  | USB_SENSE
R51 | 150k | 2 |  |  | GND
SW11 | 20-detent rotary encoder + NO click | A |  |  | ENC_A | Functional pin names only; verify the selected encoder terminal order.
SW11 | 20-detent rotary encoder + NO click | B |  |  | ENC_B | Functional pin names only; verify the selected encoder terminal order.
SW11 | 20-detent rotary encoder + NO click | C |  |  | GND | Functional pin names only; verify the selected encoder terminal order.
SW11 | 20-detent rotary encoder + NO click | SW1 |  |  | ENC_SW | Functional pin names only; verify the selected encoder terminal order.
SW11 | 20-detent rotary encoder + NO click | SW2 |  |  | GND | Functional pin names only; verify the selected encoder terminal order.
R7 | 10k | 1 |  |  | 3V3
R7 | 10k | 2 |  |  | LADDER
R8 | 20k | 1 |  |  | LADDER
R8 | 20k | 2 |  |  | GND
C5 | 100nF | 1 |  |  | LADDER
C5 | 100nF | 2 |  |  | GND
R9 | 1k | 1 |  |  | LADDER
R9 | 1k | 2 |  |  | T1
SW1 | momentary NO | 1 |  |  | T1 | B
SW1 | momentary NO | 2 |  |  | GND | B
R10 | 1k | 1 |  |  | T1
R10 | 1k | 2 |  |  | T2
SW2 | momentary NO | 1 |  |  | T2 | A
SW2 | momentary NO | 2 |  |  | GND | A
R11 | 1k | 1 |  |  | T2
R11 | 1k | 2 |  |  | T3
SW3 | momentary NO | 1 |  |  | T3 | 2
SW3 | momentary NO | 2 |  |  | GND | 2
R12 | 1k | 1 |  |  | T3
R12 | 1k | 2 |  |  | T4
SW4 | momentary NO | 1 |  |  | T4 | 1
SW4 | momentary NO | 2 |  |  | GND | 1
R13 | 1k | 1 |  |  | T4
R13 | 1k | 2 |  |  | T5
SW5 | momentary NO | 1 |  |  | T5 | C
SW5 | momentary NO | 2 |  |  | GND | C
R14 | 1k | 1 |  |  | T5
R14 | 1k | 2 |  |  | T6
SW6 | momentary NO | 1 |  |  | T6 | 3
SW6 | momentary NO | 2 |  |  | GND | 3
R15 | 1k | 1 |  |  | T6
R15 | 1k | 2 |  |  | T7
SW7 | momentary NO | 1 |  |  | T7 | D
SW7 | momentary NO | 2 |  |  | GND | D
R16 | 1k | 1 |  |  | T7
R16 | 1k | 2 |  |  | T8
SW8 | momentary NO | 1 |  |  | T8 | 4
SW8 | momentary NO | 2 |  |  | GND | 4
R17 | 1k | 1 |  |  | T8
R17 | 1k | 2 |  |  | T9
SW9 | momentary NO | 1 |  |  | T9 | E
SW9 | momentary NO | 2 |  |  | GND | E
R18 | 1k | 1 |  |  | T9
R18 | 1k | 2 |  |  | T10
SW10 | momentary NO | 1 |  |  | T10 | 5
SW10 | momentary NO | 2 |  |  | GND | 5
J2 | Amphenol ACJS-MHDC | 10 |  |  | GND | TOP=pedal1, BOTTOM=pedal2; pad13 mechanical. All normal contacts NC.
J2 | Amphenol ACJS-MHDC | 11 |  |  | P1_RING | TOP=pedal1, BOTTOM=pedal2; pad13 mechanical. All normal contacts NC.
J2 | Amphenol ACJS-MHDC | 12 |  |  | P1_ADC | TOP=pedal1, BOTTOM=pedal2; pad13 mechanical. All normal contacts NC.
J2 | Amphenol ACJS-MHDC | 7 |  |  | NC | TOP=pedal1, BOTTOM=pedal2; pad13 mechanical. All normal contacts NC.
J2 | Amphenol ACJS-MHDC | 8 |  |  | NC | TOP=pedal1, BOTTOM=pedal2; pad13 mechanical. All normal contacts NC.
J2 | Amphenol ACJS-MHDC | 9 |  |  | NC | TOP=pedal1, BOTTOM=pedal2; pad13 mechanical. All normal contacts NC.
J2 | Amphenol ACJS-MHDC | 4 |  |  | GND | TOP=pedal1, BOTTOM=pedal2; pad13 mechanical. All normal contacts NC.
J2 | Amphenol ACJS-MHDC | 5 |  |  | P2_RING | TOP=pedal1, BOTTOM=pedal2; pad13 mechanical. All normal contacts NC.
J2 | Amphenol ACJS-MHDC | 6 |  |  | P2_ADC | TOP=pedal1, BOTTOM=pedal2; pad13 mechanical. All normal contacts NC.
J2 | Amphenol ACJS-MHDC | 1 |  |  | NC | TOP=pedal1, BOTTOM=pedal2; pad13 mechanical. All normal contacts NC.
J2 | Amphenol ACJS-MHDC | 2 |  |  | NC | TOP=pedal1, BOTTOM=pedal2; pad13 mechanical. All normal contacts NC.
J2 | Amphenol ACJS-MHDC | 3 |  |  | NC | TOP=pedal1, BOTTOM=pedal2; pad13 mechanical. All normal contacts NC.
J2 | Amphenol ACJS-MHDC | 13 |  |  | NC | TOP=pedal1, BOTTOM=pedal2; pad13 mechanical. All normal contacts NC.
R20 | 5.1k | 1 |  |  | 3V3
R20 | 5.1k | 2 |  |  | P1_RING
R21 | 10k | 1 |  |  | P1_MODE
R21 | 10k | 2 |  |  | P1_ADC
R30 | 5.1k | 1 |  |  | 3V3
R30 | 5.1k | 2 |  |  | P2_RING
R31 | 10k | 1 |  |  | P2_MODE
R31 | 10k | 2 |  |  | P2_ADC
LED1 | Pololu 2535 | DIN | top / farthest from flat (lens left, flat down) | DIN | LED_GPIO | Physical side view: lens left, flat down; right-side leads top-to-bottom DIN, 5V, GND, DOUT. Switch B / tap T1.
LED1 | Pololu 2535 | DOUT | bottom / nearest flat (lens left, flat down) | DOUT | L1 | Physical side view: lens left, flat down; right-side leads top-to-bottom DIN, 5V, GND, DOUT. Switch B / tap T1.
LED1 | Pololu 2535 | +5V | second (lens left, flat down) | 5V | +5V | Physical side view: lens left, flat down; right-side leads top-to-bottom DIN, 5V, GND, DOUT. Switch B / tap T1.
LED1 | Pololu 2535 | GND | third (lens left, flat down) | GND | GND | Physical side view: lens left, flat down; right-side leads top-to-bottom DIN, 5V, GND, DOUT. Switch B / tap T1.
LED2 | Pololu 2535 | DIN | top / farthest from flat (lens left, flat down) | DIN | L1 | Physical side view: lens left, flat down; right-side leads top-to-bottom DIN, 5V, GND, DOUT. Switch A / tap T2.
LED2 | Pololu 2535 | DOUT | bottom / nearest flat (lens left, flat down) | DOUT | L2 | Physical side view: lens left, flat down; right-side leads top-to-bottom DIN, 5V, GND, DOUT. Switch A / tap T2.
LED2 | Pololu 2535 | +5V | second (lens left, flat down) | 5V | +5V | Physical side view: lens left, flat down; right-side leads top-to-bottom DIN, 5V, GND, DOUT. Switch A / tap T2.
LED2 | Pololu 2535 | GND | third (lens left, flat down) | GND | GND | Physical side view: lens left, flat down; right-side leads top-to-bottom DIN, 5V, GND, DOUT. Switch A / tap T2.
LED3 | Pololu 2535 | DIN | top / farthest from flat (lens left, flat down) | DIN | L2 | Physical side view: lens left, flat down; right-side leads top-to-bottom DIN, 5V, GND, DOUT. Switch 2 / tap T3.
LED3 | Pololu 2535 | DOUT | bottom / nearest flat (lens left, flat down) | DOUT | L3 | Physical side view: lens left, flat down; right-side leads top-to-bottom DIN, 5V, GND, DOUT. Switch 2 / tap T3.
LED3 | Pololu 2535 | +5V | second (lens left, flat down) | 5V | +5V | Physical side view: lens left, flat down; right-side leads top-to-bottom DIN, 5V, GND, DOUT. Switch 2 / tap T3.
LED3 | Pololu 2535 | GND | third (lens left, flat down) | GND | GND | Physical side view: lens left, flat down; right-side leads top-to-bottom DIN, 5V, GND, DOUT. Switch 2 / tap T3.
LED4 | Pololu 2535 | DIN | top / farthest from flat (lens left, flat down) | DIN | L3 | Physical side view: lens left, flat down; right-side leads top-to-bottom DIN, 5V, GND, DOUT. Switch 1 / tap T4.
LED4 | Pololu 2535 | DOUT | bottom / nearest flat (lens left, flat down) | DOUT | L4 | Physical side view: lens left, flat down; right-side leads top-to-bottom DIN, 5V, GND, DOUT. Switch 1 / tap T4.
LED4 | Pololu 2535 | +5V | second (lens left, flat down) | 5V | +5V | Physical side view: lens left, flat down; right-side leads top-to-bottom DIN, 5V, GND, DOUT. Switch 1 / tap T4.
LED4 | Pololu 2535 | GND | third (lens left, flat down) | GND | GND | Physical side view: lens left, flat down; right-side leads top-to-bottom DIN, 5V, GND, DOUT. Switch 1 / tap T4.
LED5 | Pololu 2535 | DIN | top / farthest from flat (lens left, flat down) | DIN | L4 | Physical side view: lens left, flat down; right-side leads top-to-bottom DIN, 5V, GND, DOUT. Switch C / tap T5.
LED5 | Pololu 2535 | DOUT | bottom / nearest flat (lens left, flat down) | DOUT | L5 | Physical side view: lens left, flat down; right-side leads top-to-bottom DIN, 5V, GND, DOUT. Switch C / tap T5.
LED5 | Pololu 2535 | +5V | second (lens left, flat down) | 5V | +5V | Physical side view: lens left, flat down; right-side leads top-to-bottom DIN, 5V, GND, DOUT. Switch C / tap T5.
LED5 | Pololu 2535 | GND | third (lens left, flat down) | GND | GND | Physical side view: lens left, flat down; right-side leads top-to-bottom DIN, 5V, GND, DOUT. Switch C / tap T5.
LED6 | Pololu 2535 | DIN | top / farthest from flat (lens left, flat down) | DIN | L5 | Physical side view: lens left, flat down; right-side leads top-to-bottom DIN, 5V, GND, DOUT. Switch 3 / tap T6.
LED6 | Pololu 2535 | DOUT | bottom / nearest flat (lens left, flat down) | DOUT | L6 | Physical side view: lens left, flat down; right-side leads top-to-bottom DIN, 5V, GND, DOUT. Switch 3 / tap T6.
LED6 | Pololu 2535 | +5V | second (lens left, flat down) | 5V | +5V | Physical side view: lens left, flat down; right-side leads top-to-bottom DIN, 5V, GND, DOUT. Switch 3 / tap T6.
LED6 | Pololu 2535 | GND | third (lens left, flat down) | GND | GND | Physical side view: lens left, flat down; right-side leads top-to-bottom DIN, 5V, GND, DOUT. Switch 3 / tap T6.
LED7 | Pololu 2535 | DIN | top / farthest from flat (lens left, flat down) | DIN | L6 | Physical side view: lens left, flat down; right-side leads top-to-bottom DIN, 5V, GND, DOUT. Switch D / tap T7.
LED7 | Pololu 2535 | DOUT | bottom / nearest flat (lens left, flat down) | DOUT | L7 | Physical side view: lens left, flat down; right-side leads top-to-bottom DIN, 5V, GND, DOUT. Switch D / tap T7.
LED7 | Pololu 2535 | +5V | second (lens left, flat down) | 5V | +5V | Physical side view: lens left, flat down; right-side leads top-to-bottom DIN, 5V, GND, DOUT. Switch D / tap T7.
LED7 | Pololu 2535 | GND | third (lens left, flat down) | GND | GND | Physical side view: lens left, flat down; right-side leads top-to-bottom DIN, 5V, GND, DOUT. Switch D / tap T7.
LED8 | Pololu 2535 | DIN | top / farthest from flat (lens left, flat down) | DIN | L7 | Physical side view: lens left, flat down; right-side leads top-to-bottom DIN, 5V, GND, DOUT. Switch 4 / tap T8.
LED8 | Pololu 2535 | DOUT | bottom / nearest flat (lens left, flat down) | DOUT | L8 | Physical side view: lens left, flat down; right-side leads top-to-bottom DIN, 5V, GND, DOUT. Switch 4 / tap T8.
LED8 | Pololu 2535 | +5V | second (lens left, flat down) | 5V | +5V | Physical side view: lens left, flat down; right-side leads top-to-bottom DIN, 5V, GND, DOUT. Switch 4 / tap T8.
LED8 | Pololu 2535 | GND | third (lens left, flat down) | GND | GND | Physical side view: lens left, flat down; right-side leads top-to-bottom DIN, 5V, GND, DOUT. Switch 4 / tap T8.
LED9 | Pololu 2535 | DIN | top / farthest from flat (lens left, flat down) | DIN | L8 | Physical side view: lens left, flat down; right-side leads top-to-bottom DIN, 5V, GND, DOUT. Switch E / tap T9.
LED9 | Pololu 2535 | DOUT | bottom / nearest flat (lens left, flat down) | DOUT | L9 | Physical side view: lens left, flat down; right-side leads top-to-bottom DIN, 5V, GND, DOUT. Switch E / tap T9.
LED9 | Pololu 2535 | +5V | second (lens left, flat down) | 5V | +5V | Physical side view: lens left, flat down; right-side leads top-to-bottom DIN, 5V, GND, DOUT. Switch E / tap T9.
LED9 | Pololu 2535 | GND | third (lens left, flat down) | GND | GND | Physical side view: lens left, flat down; right-side leads top-to-bottom DIN, 5V, GND, DOUT. Switch E / tap T9.
LED10 | Pololu 2535 | DIN | top / farthest from flat (lens left, flat down) | DIN | L9 | Physical side view: lens left, flat down; right-side leads top-to-bottom DIN, 5V, GND, DOUT. Switch 5 / tap T10.
LED10 | Pololu 2535 | DOUT | bottom / nearest flat (lens left, flat down) | DOUT | NC | Physical side view: lens left, flat down; right-side leads top-to-bottom DIN, 5V, GND, DOUT. Switch 5 / tap T10.
LED10 | Pololu 2535 | +5V | second (lens left, flat down) | 5V | +5V | Physical side view: lens left, flat down; right-side leads top-to-bottom DIN, 5V, GND, DOUT. Switch 5 / tap T10.
LED10 | Pololu 2535 | GND | third (lens left, flat down) | GND | GND | Physical side view: lens left, flat down; right-side leads top-to-bottom DIN, 5V, GND, DOUT. Switch 5 / tap T10.
U4 | 74HCT125 | 2 |  |  | MIDI_OUT_TX | Gates 1 and 2 used: inputs 2/5 joined to MIDI_OUT_TX, /OE 1/4 low; unused inputs 9/12 and /OE 10/13 to GND, outputs 8/11 open; 100nF bypass across pins 14/7.
U4 | 74HCT125 | 5 |  |  | MIDI_OUT_TX | Gates 1 and 2 used: inputs 2/5 joined to MIDI_OUT_TX, /OE 1/4 low; unused inputs 9/12 and /OE 10/13 to GND, outputs 8/11 open; 100nF bypass across pins 14/7.
U4 | 74HCT125 | 1 |  |  | GND | Gates 1 and 2 used: inputs 2/5 joined to MIDI_OUT_TX, /OE 1/4 low; unused inputs 9/12 and /OE 10/13 to GND, outputs 8/11 open; 100nF bypass across pins 14/7.
U4 | 74HCT125 | 4 |  |  | GND | Gates 1 and 2 used: inputs 2/5 joined to MIDI_OUT_TX, /OE 1/4 low; unused inputs 9/12 and /OE 10/13 to GND, outputs 8/11 open; 100nF bypass across pins 14/7.
U4 | 74HCT125 | 3 |  |  | TX_GATE1 | Gates 1 and 2 used: inputs 2/5 joined to MIDI_OUT_TX, /OE 1/4 low; unused inputs 9/12 and /OE 10/13 to GND, outputs 8/11 open; 100nF bypass across pins 14/7.
U4 | 74HCT125 | 6 |  |  | TX_GATE2 | Gates 1 and 2 used: inputs 2/5 joined to MIDI_OUT_TX, /OE 1/4 low; unused inputs 9/12 and /OE 10/13 to GND, outputs 8/11 open; 100nF bypass across pins 14/7.
U4 | 74HCT125 | 14 |  |  | MIDI_5V | Gates 1 and 2 used: inputs 2/5 joined to MIDI_OUT_TX, /OE 1/4 low; unused inputs 9/12 and /OE 10/13 to GND, outputs 8/11 open; 100nF bypass across pins 14/7.
U4 | 74HCT125 | 7 |  |  | GND | Gates 1 and 2 used: inputs 2/5 joined to MIDI_OUT_TX, /OE 1/4 low; unused inputs 9/12 and /OE 10/13 to GND, outputs 8/11 open; 100nF bypass across pins 14/7.
U4 | 74HCT125 | 9 |  |  | GND | Gates 1 and 2 used: inputs 2/5 joined to MIDI_OUT_TX, /OE 1/4 low; unused inputs 9/12 and /OE 10/13 to GND, outputs 8/11 open; 100nF bypass across pins 14/7.
U4 | 74HCT125 | 10 |  |  | GND | Gates 1 and 2 used: inputs 2/5 joined to MIDI_OUT_TX, /OE 1/4 low; unused inputs 9/12 and /OE 10/13 to GND, outputs 8/11 open; 100nF bypass across pins 14/7.
U4 | 74HCT125 | 12 |  |  | GND | Gates 1 and 2 used: inputs 2/5 joined to MIDI_OUT_TX, /OE 1/4 low; unused inputs 9/12 and /OE 10/13 to GND, outputs 8/11 open; 100nF bypass across pins 14/7.
U4 | 74HCT125 | 13 |  |  | GND | Gates 1 and 2 used: inputs 2/5 joined to MIDI_OUT_TX, /OE 1/4 low; unused inputs 9/12 and /OE 10/13 to GND, outputs 8/11 open; 100nF bypass across pins 14/7.
R52 | 10k | 1 |  |  | 3V3
R52 | 10k | 2 |  |  | MIDI_OUT_TX
D1 | 1N5819 | A |  |  | +5V
D1 | 1N5819 | K |  |  | MIDI_5V
D2 | 1N5819 | A |  |  | USB_VBUS
D2 | 1N5819 | K |  |  | MIDI_5V
C6 | 100nF | 1 |  |  | MIDI_5V
C6 | 100nF | 2 |  |  | GND
J3 | 3.5 mm TRS MIDI OUT | T |  |  | J3_TIP | MIDI OUT A; TRS Type A: tip = DIN pin 5 (sink), ring = DIN pin 4 (source), sleeve = DIN pin 2 shield to GND.
J3 | 3.5 mm TRS MIDI OUT | R |  |  | J3_RING | MIDI OUT A; TRS Type A: tip = DIN pin 5 (sink), ring = DIN pin 4 (source), sleeve = DIN pin 2 shield to GND.
J3 | 3.5 mm TRS MIDI OUT | S |  |  | GND | MIDI OUT A; TRS Type A: tip = DIN pin 5 (sink), ring = DIN pin 4 (source), sleeve = DIN pin 2 shield to GND.
J4 | 3.5 mm TRS MIDI OUT | T |  |  | J4_TIP | MIDI OUT B; TRS Type A: tip = DIN pin 5 (sink), ring = DIN pin 4 (source), sleeve = DIN pin 2 shield to GND.
J4 | 3.5 mm TRS MIDI OUT | R |  |  | J4_RING | MIDI OUT B; TRS Type A: tip = DIN pin 5 (sink), ring = DIN pin 4 (source), sleeve = DIN pin 2 shield to GND.
J4 | 3.5 mm TRS MIDI OUT | S |  |  | GND | MIDI OUT B; TRS Type A: tip = DIN pin 5 (sink), ring = DIN pin 4 (source), sleeve = DIN pin 2 shield to GND.
R53 | 220R | 1 |  |  | MIDI_5V
R53 | 220R | 2 |  |  | J3_RING
R54 | 220R | 1 |  |  | TX_GATE1
R54 | 220R | 2 |  |  | J3_TIP
R55 | 220R | 1 |  |  | MIDI_5V
R55 | 220R | 2 |  |  | J4_RING
R56 | 220R | 1 |  |  | TX_GATE2
R56 | 220R | 2 |  |  | J4_TIP
