awhite2000/sigmidi/design/fusion/modular/new-parts-print-orientations.png

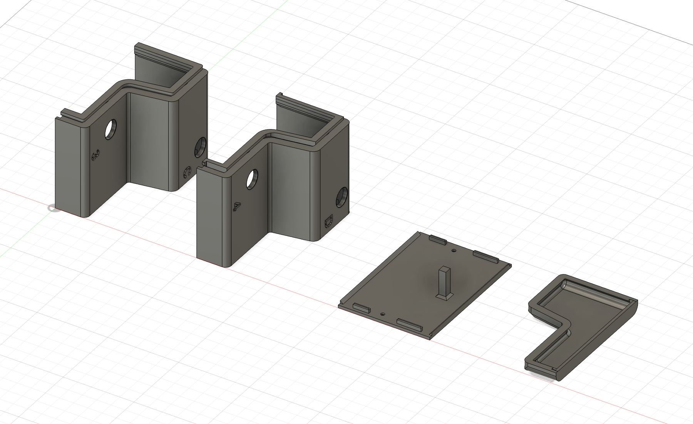
design/fusion/modular/new-parts-print-orientations.png
