awhite2000/sigmidi/design/fusion/mirrored/main/midi-foot-mirrored-main.step

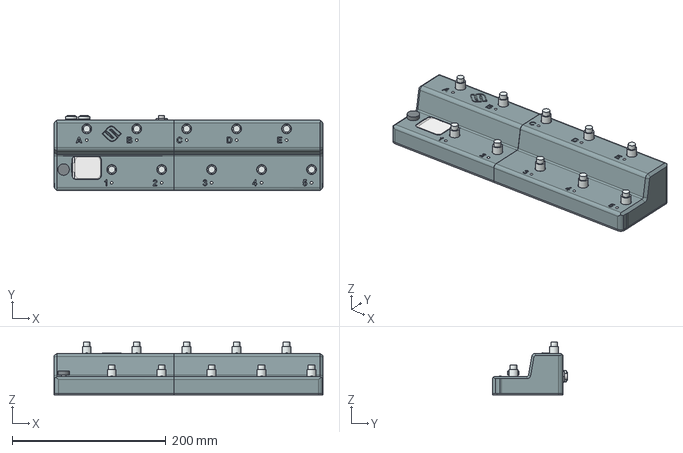
[picture p103: CAD file, 2026-11-01]
design/fusion/mirrored/main/midi-foot-mirrored-main.step
350.0 x 98.1 x 68.5 mm
