awhite2000/sigmidi/design/fusion/datasheets/dfr1075-step/[DFR1075][M027.00837](V1.1.0).step

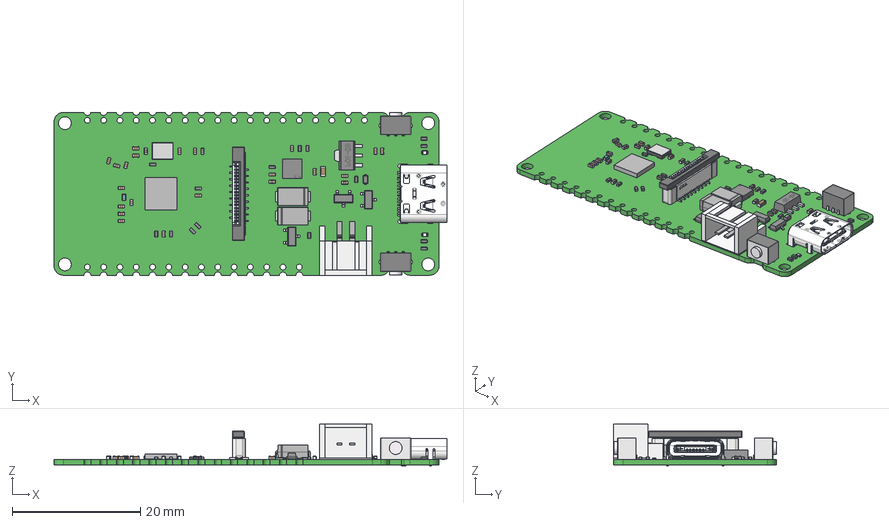
[picture p104: CAD file, 2026-10-28]
design/fusion/datasheets/dfr1075-step/[DFR1075][M027.00837](V1.1.0).step
61.2 x 25.5 x 6.50 mm
Board
CAPC1005(0402) x 23
BODY-SOT x 3
LEAD-SOT x 9
PIN1-ID x 3
TIEBAR x 3
RESC1005(0402) x 16
User_Library-USB_-_C
Extruded x 20
SOT89
TSA455G00 x 2
User_Library-Chip_Inductor_0402
CAPC1608(0603)
Weiss x 2
Cut005_(Mirror_#1) x 2
