awhite2000/sigmidi/design/fusion/datasheets/pololu-4083.step

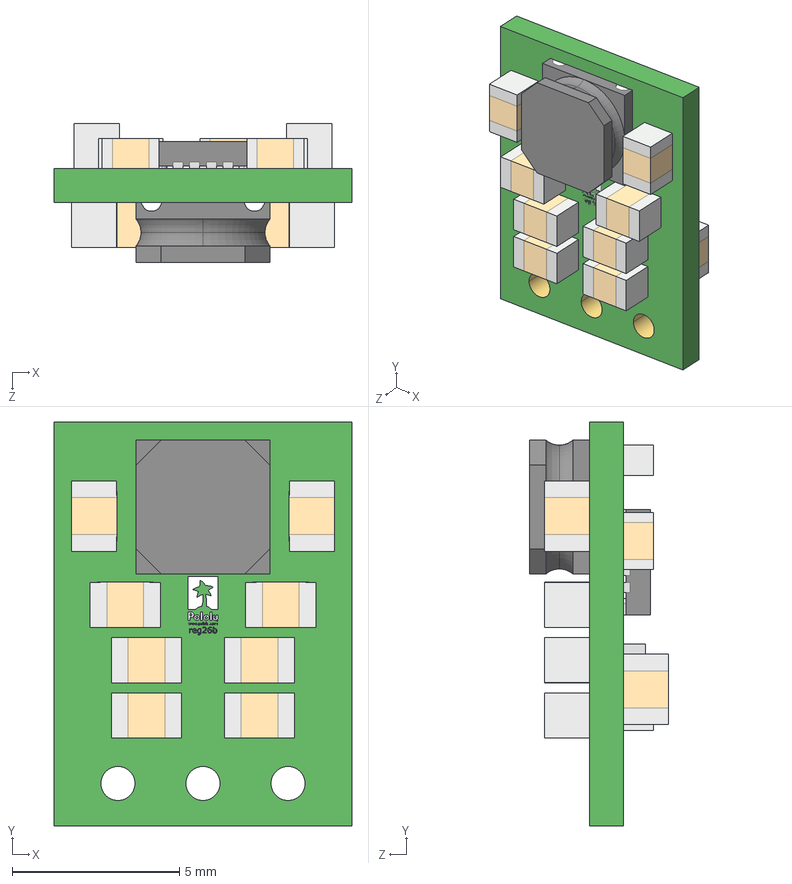
[picture p105: CAD file, 2026-10-28]
design/fusion/datasheets/pololu-4083.step
8.89 x 12.1 x 4.17 mm
