awhite2000/sigmidi/design/fusion/mirrored/modular/midi-foot-mirrored-modular.step

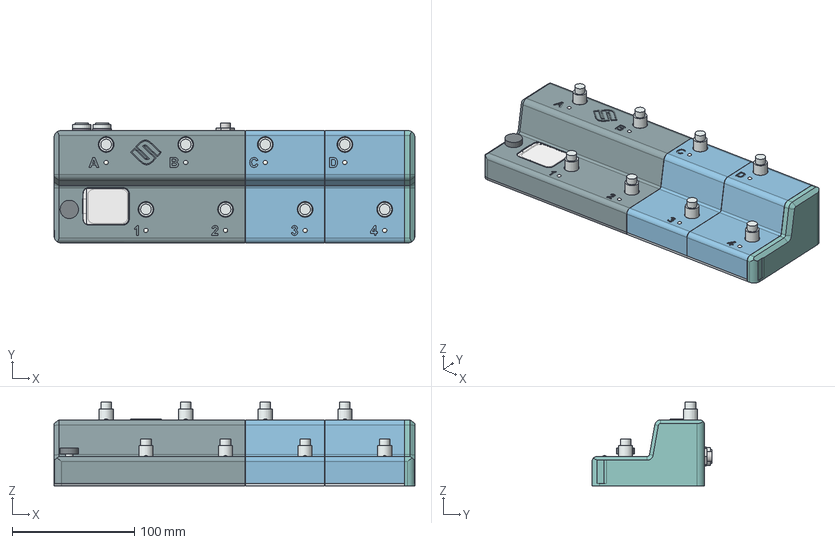
[picture p106: CAD file, 2026-10-30]
design/fusion/mirrored/modular/midi-foot-mirrored-modular.step
294.9 x 98.1 x 68.5 mm
