awhite2000/sigmidi/design/fusion/nano-esp32/nano-esp32-direct-mount.step

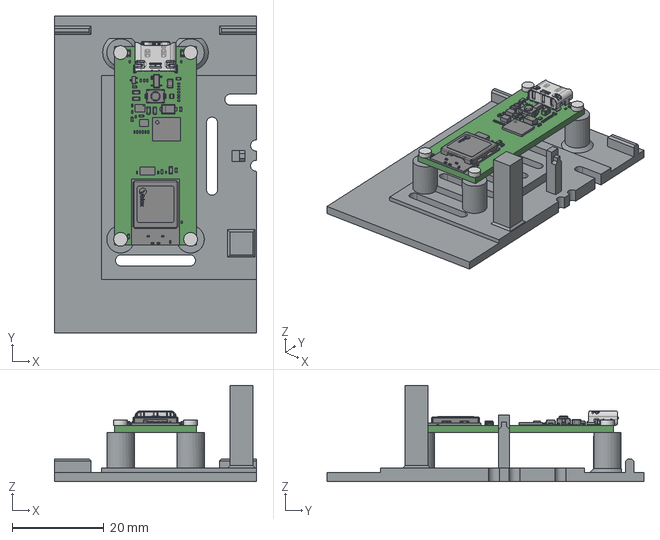
[picture p107: CAD file, 2026-10-30]
design/fusion/nano-esp32/nano-esp32-direct-mount.step
44.0 x 69.0 x 21.0 mm
