awhite2000/sigmidi/design/fusion/print/base-right.3mf

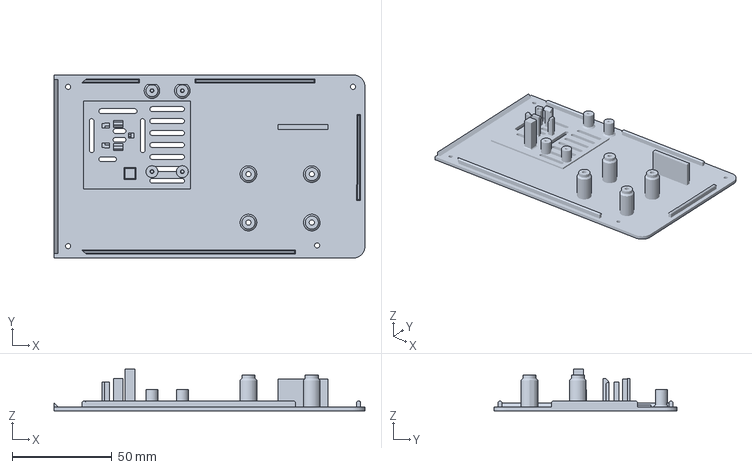
[picture p108: CAD file, 2026-10-30]
design/fusion/print/base-right.3mf
156.1 x 92.0 x 21.0 mm
