awhite2000/sigmidi/design/fusion/nano-esp32/usb-side-glue-insert.3mf

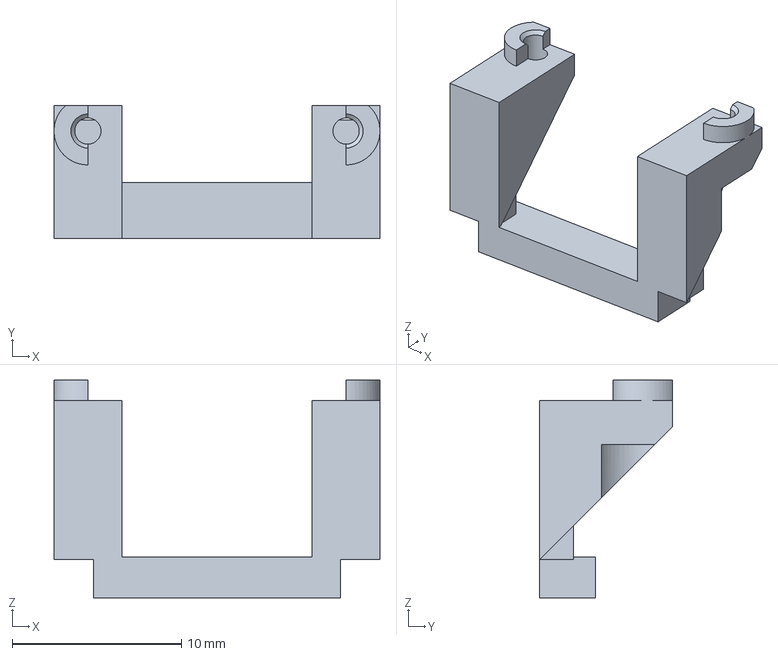
[picture p109: CAD file, 2026-10-29]
design/fusion/nano-esp32/usb-side-glue-insert.3mf
19.2 x 7.85 x 12.8 mm
