awhite2000/sigmidi/design/fusion/print/shell-right.stl

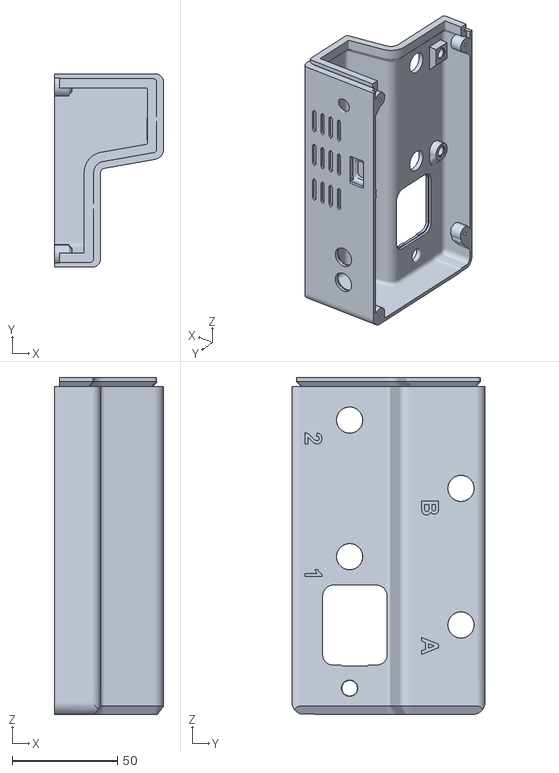
[picture p110: CAD file, 2026-10-28]
design/fusion/print/shell-right.stl
52.0 x 92.0 x 160.4
