awhite2000/sigmidi/design/fusion/mirrored/main/base-right.3mf

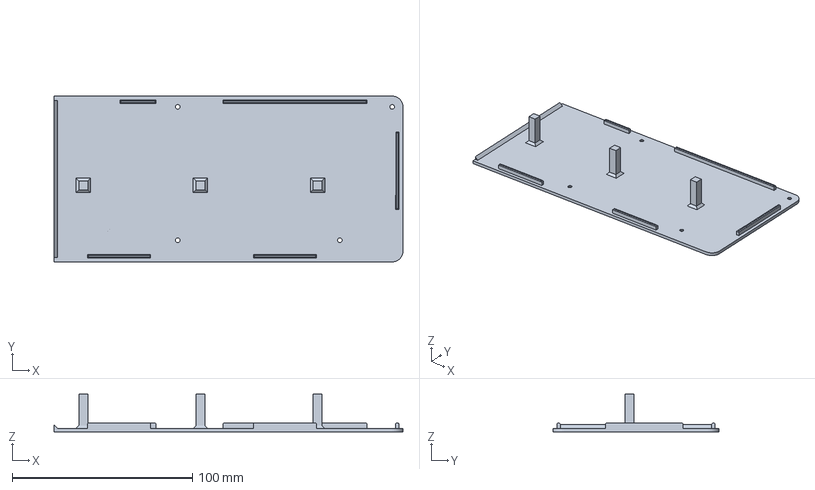
[picture p111: CAD file, 2026-10-28]
design/fusion/mirrored/main/base-right.3mf
193.6 x 92.0 x 21.0 mm
