awhite2000/sigmidi/design/fusion/mirrored/modular/pair-shell-D.step

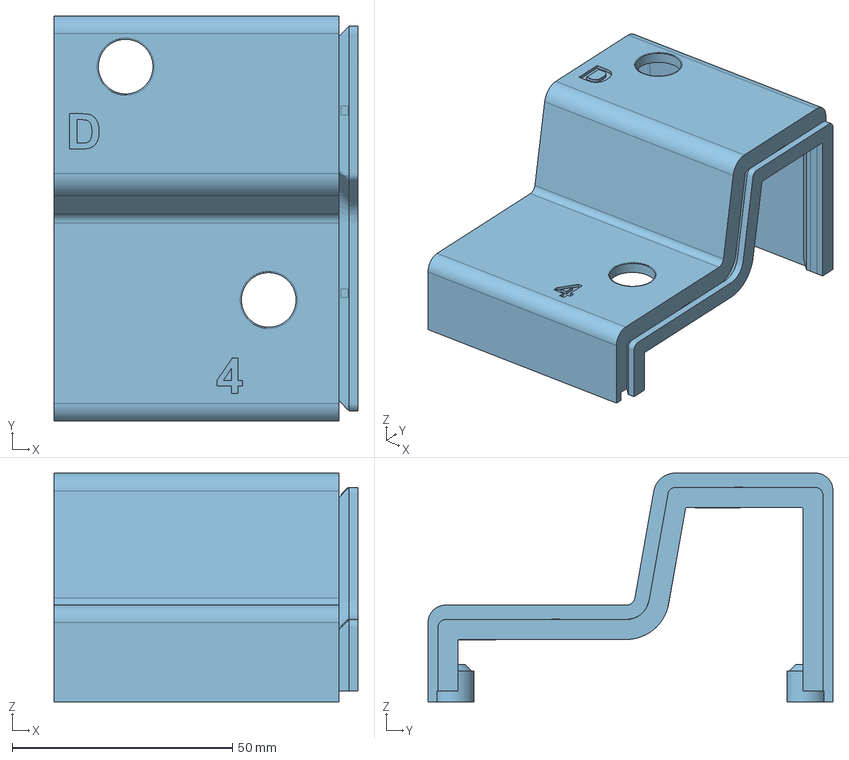
[picture p112: CAD file, 2026-10-28]
design/fusion/mirrored/modular/pair-shell-D.step
69.0 x 92.0 x 52.0 mm
