awhite2000/sigmidi/design/fusion/modular/left-cap.3mf

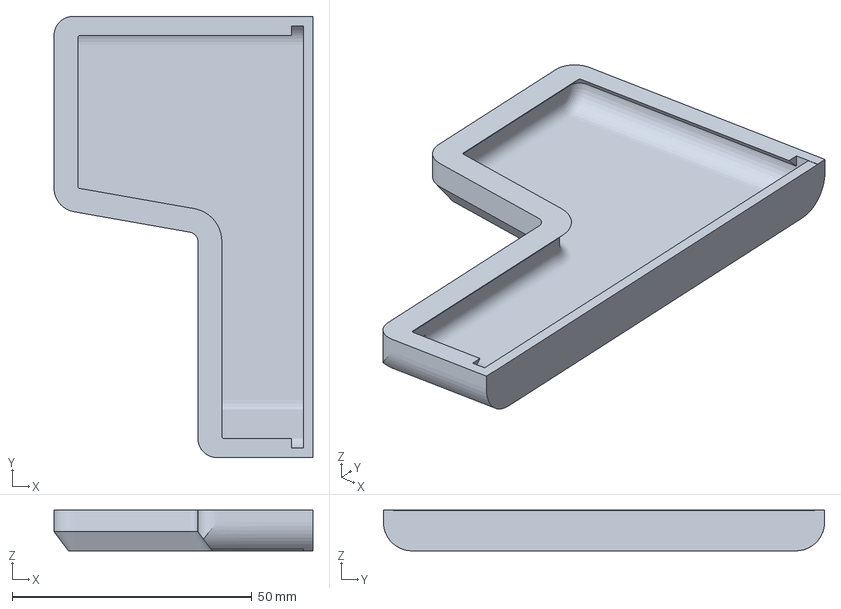
[picture p113: CAD file, 2026-10-28]
design/fusion/modular/left-cap.3mf
54.0 x 92.0 x 8.50 mm
