awhite2000/sigmidi/design/fusion/nano-esp32/nano-esp32-mount-kit.step

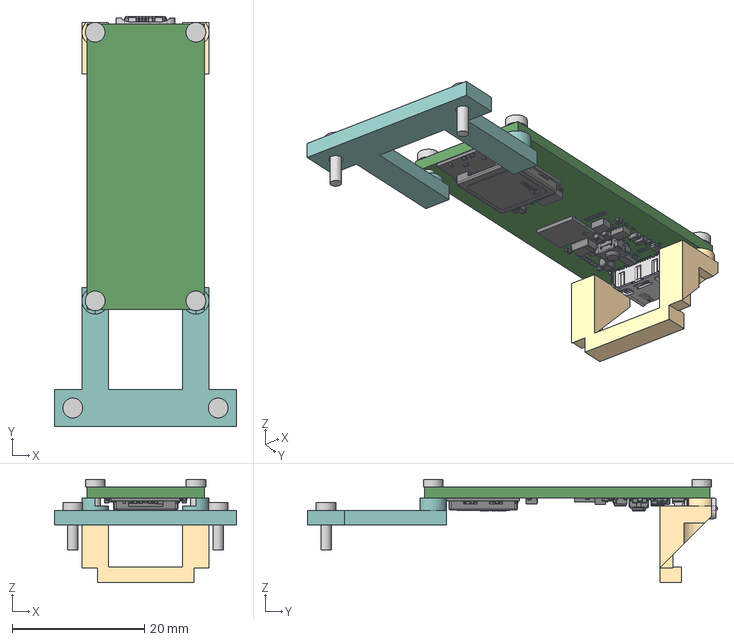
[picture p114: CAD file, 2026-10-29]
design/fusion/nano-esp32/nano-esp32-mount-kit.step
27.6 x 62.0 x 15.6 mm
