awhite2000/sigmidi/design/fusion/mirrored/main/shell-right.3mf

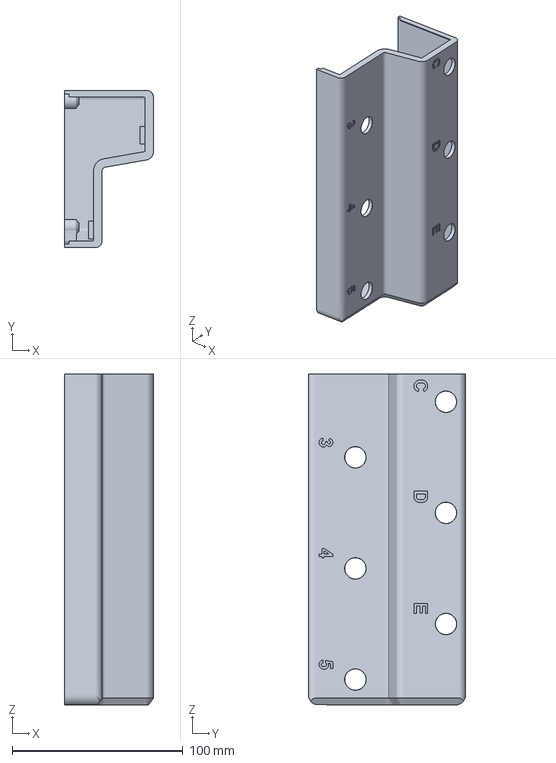
[picture p115: CAD file, 2026-10-28]
design/fusion/mirrored/main/shell-right.3mf
52.0 x 92.0 x 193.6 mm
