awhite2000/sigmidi/design/fusion/mirrored/modular/fit-coupon-left.3mf

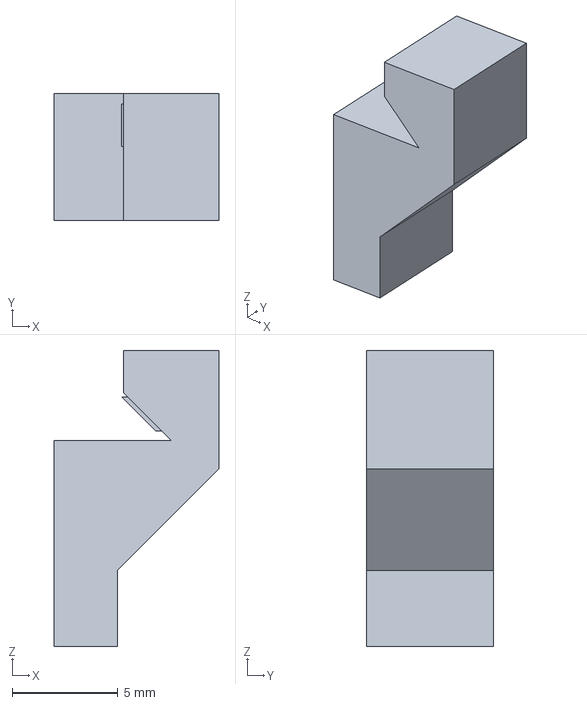
[picture p116: CAD file, 2026-10-28]
design/fusion/mirrored/modular/fit-coupon-left.3mf
7.80 x 6.00 x 14.0 mm
