awhite2000/sigmidi/design/fusion/nano-esp32/existing-pole-insert.3mf

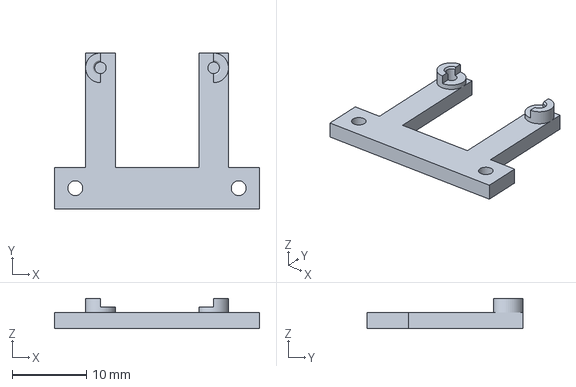
[picture p117: CAD file, 2026-10-29]
design/fusion/nano-esp32/existing-pole-insert.3mf
27.6 x 21.0 x 4.09 mm
