awhite2000/sigmidi/design/fusion/mirrored/main/fit-coupon-right.3mf

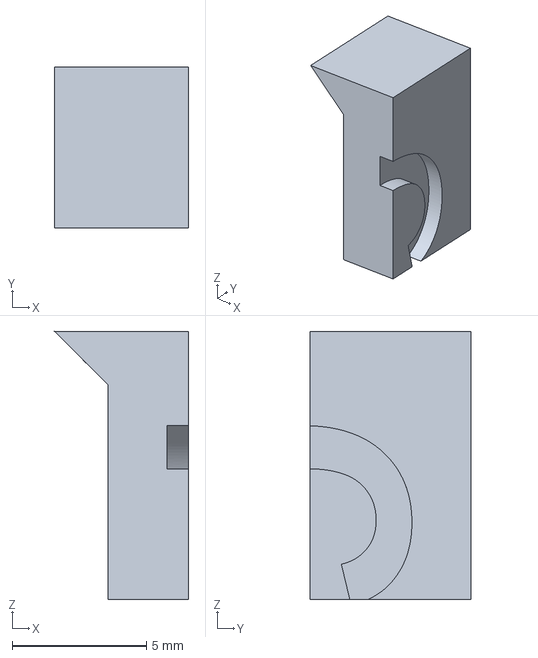
[picture p118: CAD file, 2026-10-28]
design/fusion/mirrored/main/fit-coupon-right.3mf
5.00 x 6.00 x 10.0 mm
