awhite2000/sigmidi/design/fusion/modular/pair-base.3mf

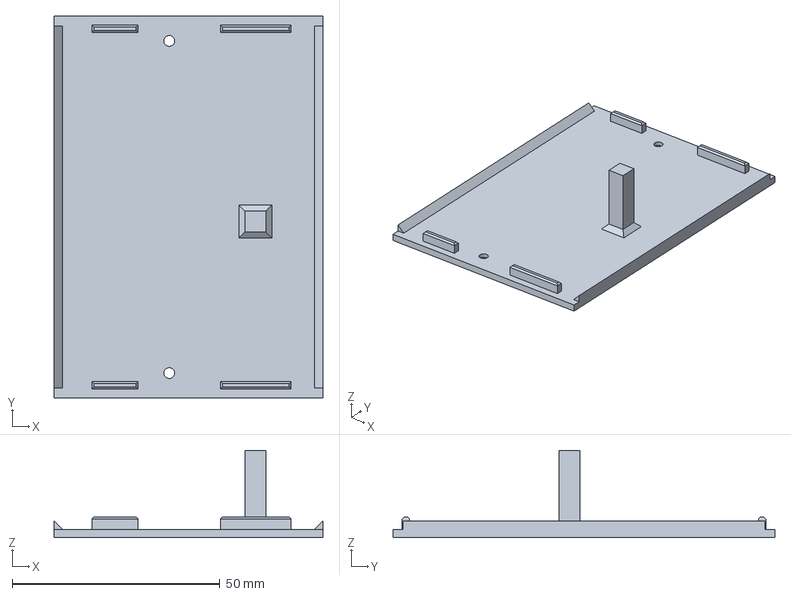
[picture p119: CAD file, 2026-10-28]
design/fusion/modular/pair-base.3mf
64.8 x 92.0 x 21.0 mm
