awhite2000/sigmidi/design/fusion/mirrored/main/shell-left.stl

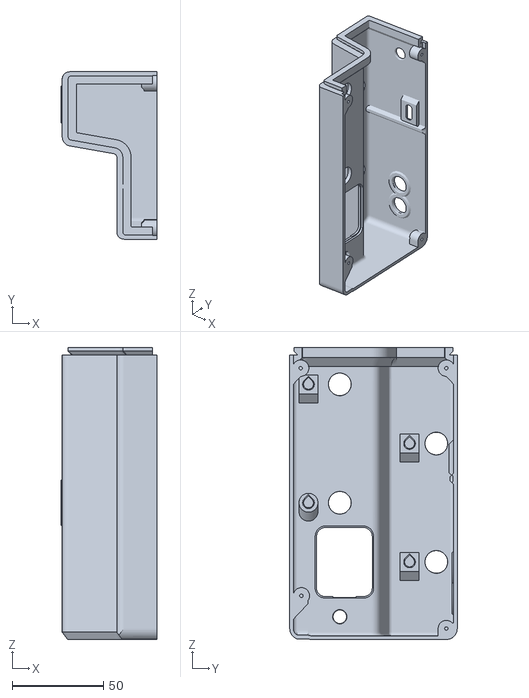
[picture p120: CAD file, 2026-10-28]
design/fusion/mirrored/main/shell-left.stl
52.6 x 92.0 x 160.4
