awhite2000/sigmidi/(list of files, cad)

Other CAD files:
design/fusion/midi-foot-chassis.step
design/fusion/modular/midi-foot-modular.step
design/fusion/mirrored/main/base-left.3mf
design/fusion/mirrored/modular/electronics-base-left.3mf
design/fusion/modular/electronics-base.stl
design/fusion/print/base-left.3mf
design/fusion/modular/pair-shell.3mf
design/fusion/print/shell-left.3mf
design/fusion/mirrored/modular/pair-shell-C.3mf
design/fusion/print/fit-coupon-right.stl
design/fusion/mirrored/modular/right-cap.3mf
design/fusion/modular/fit-coupon-left.3mf
design/fusion/mirrored/main/fit-coupon-left.stl
design/fusion/mirrored/modular/pair-shell-at-right-cap-E.step
design/fusion/modular/pair-shell-D.step
design/fusion/mirrored/modular/pair-base.3mf
design/fusion/modular/fit-coupon-right.3mf
design/fusion/mirrored/modular/pair-shell-at-right-cap-D.3mf
design/fusion/modular/pair-shell-at-cap.3mf
design/fusion/mirrored/modular/pair-shell-at-right-cap-C.step
design/fusion/modular/pair-shell-at-cap-E.step
design/fusion/mirrored/modular/electronics-shell-left.3mf
design/fusion/modular/pair-shell-at-cap-C.step
design/fusion/modular/electronics-shell.3mf
design/fusion/midi-foot-chassis.f3d
design/fusion/mirrored/main/base-left.stl
design/fusion/mirrored/main/base-right.stl
design/fusion/mirrored/main/fit-coupon-right.stl
design/fusion/mirrored/main/midi-foot-mirrored-main.f3d
design/fusion/mirrored/main/shell-right.stl
design/fusion/mirrored/modular/midi-foot-mirrored-modular.f3d
design/fusion/mirrored/modular/pair-base.stl
design/fusion/mirrored/modular/pair-shell-C.stl
design/fusion/mirrored/modular/pair-shell-D.3mf
design/fusion/mirrored/modular/pair-shell-D.f3d
design/fusion/mirrored/modular/pair-shell-D.stl
design/fusion/mirrored/modular/pair-shell-at-right-cap-C.3mf
design/fusion/mirrored/modular/pair-shell-at-right-cap-C.f3d
design/fusion/mirrored/modular/pair-shell-at-right-cap-C.stl
design/fusion/mirrored/modular/pair-shell-at-right-cap-D.stl
design/fusion/mirrored/modular/pair-shell-at-right-cap-E.3mf
design/fusion/mirrored/modular/pair-shell-at-right-cap-E.f3d
design/fusion/mirrored/modular/pair-shell-at-right-cap-E.stl
design/fusion/mirrored/modular/right-cap.stl
design/fusion/modular/fit-coupon-left.stl
design/fusion/modular/left-cap.stl
design/fusion/modular/midi-foot-modular.f3d
design/fusion/modular/pair-base.stl
design/fusion/modular/pair-shell-D.3mf
design/fusion/modular/pair-shell-D.f3d
design/fusion/modular/pair-shell-D.stl
design/fusion/modular/pair-shell-at-cap-C.3mf
design/fusion/modular/pair-shell-at-cap-C.f3d
design/fusion/modular/pair-shell-at-cap-C.stl
design/fusion/modular/pair-shell-at-cap-E.3mf
design/fusion/modular/pair-shell-at-cap-E.f3d
design/fusion/modular/pair-shell-at-cap-E.stl
design/fusion/modular/pair-shell-at-cap.stl
design/fusion/modular/pair-shell.stl
design/fusion/nano-esp32/existing-pole-insert.stl
design/fusion/nano-esp32/nano-esp32-direct-mount.f3d
design/fusion/nano-esp32/nano-esp32-mount-kit.f3d
design/fusion/nano-esp32/usb-side-glue-insert.stl
design/fusion/print/base-left.stl
design/fusion/print/base-right.stl
design/fusion/print/shell-left.stl
design/fusion/sigmidi-foot-controller-0.1.f3d
