awhite2000/sigmidi/design/fusion/assembled.png

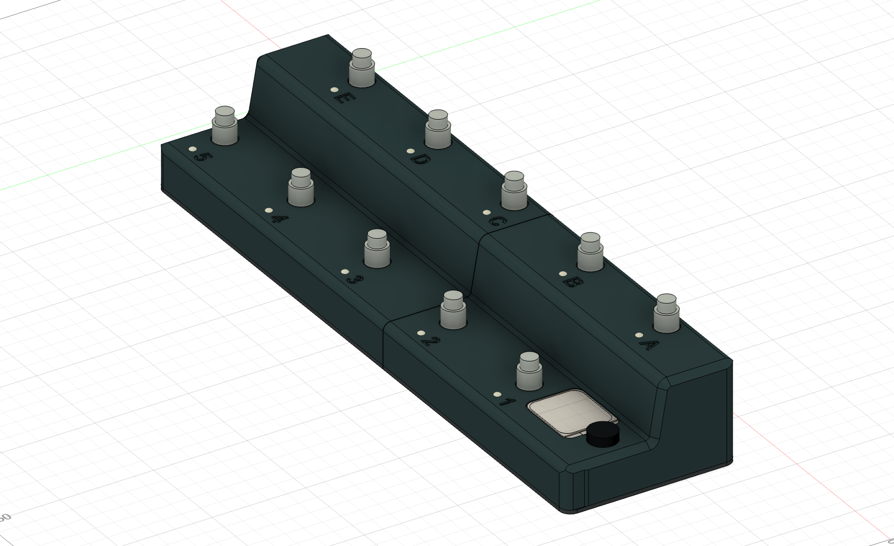
design/fusion/assembled.png
