awhite2000/sigmidi/design/fusion/modular/modular-assembled.png

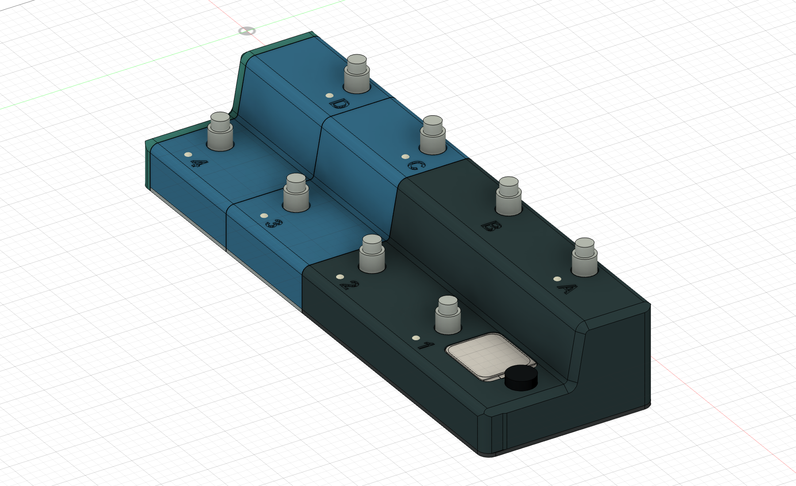
design/fusion/modular/modular-assembled.png
