awhite2000/sigmidi/design/fusion/nano-esp32/print-orientation.png

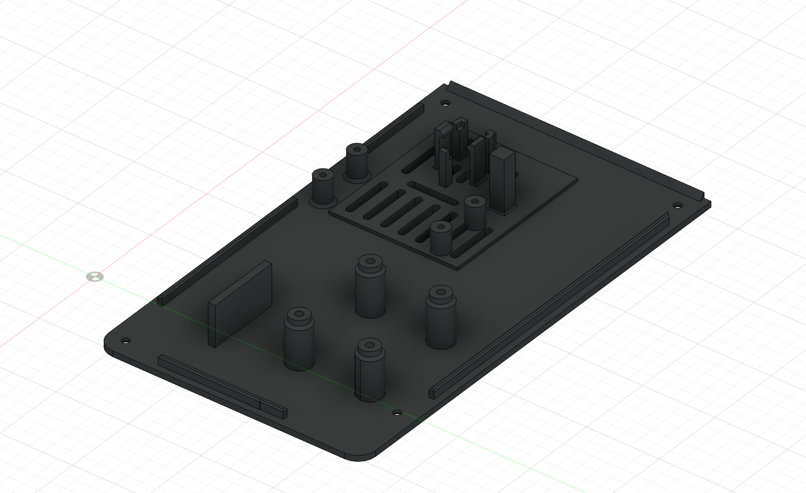
design/fusion/nano-esp32/print-orientation.png
