awhite2000/sigmidi/design/fusion/print/printing-orientations-supports.png

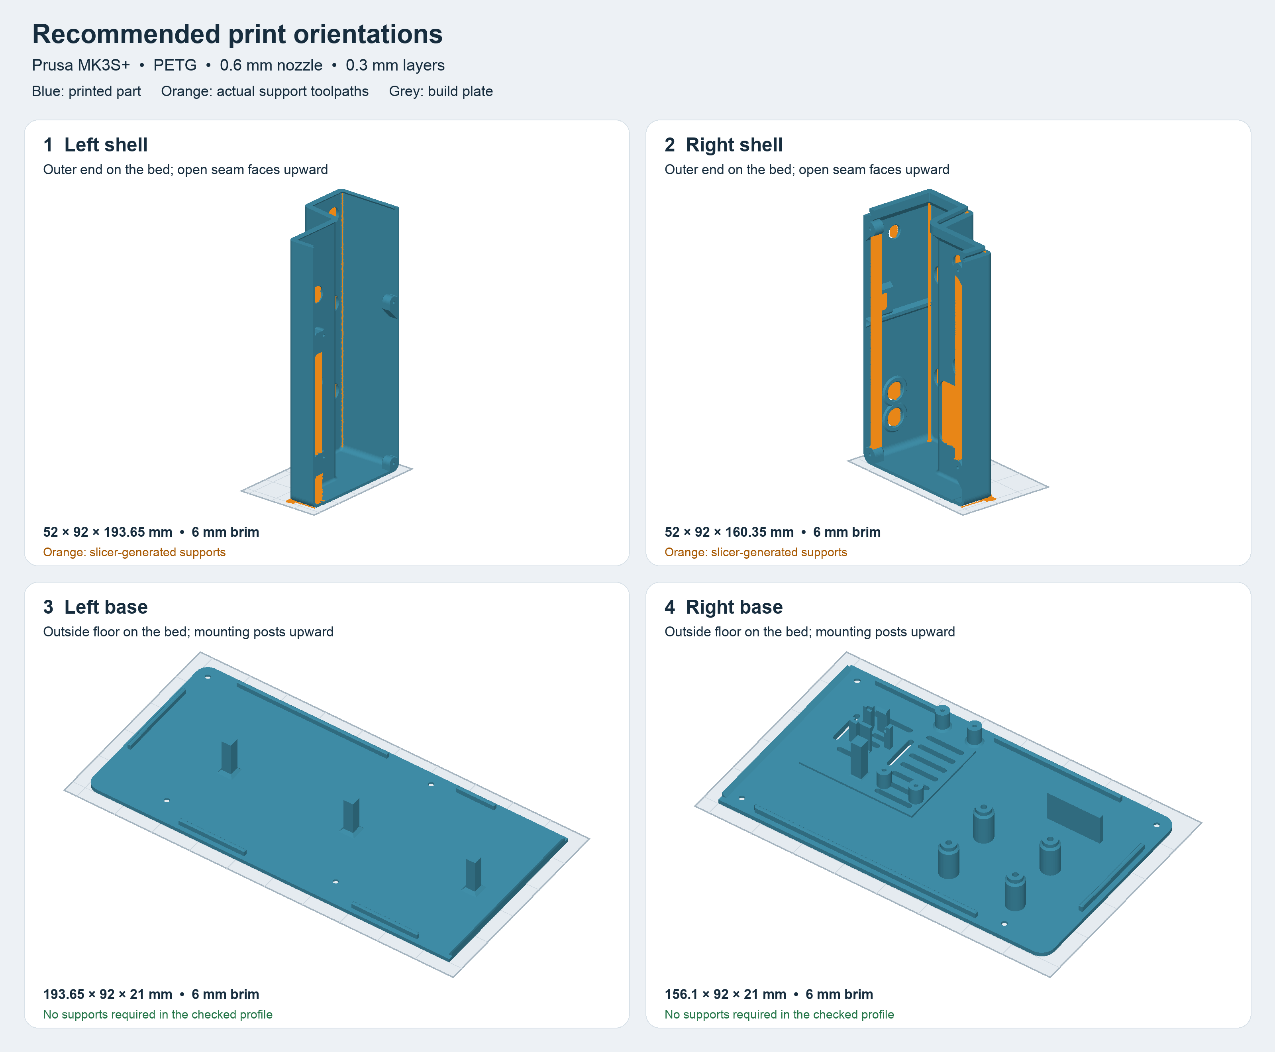
design/fusion/print/printing-orientations-supports.png
