awhite2000/sigmidi/design/fusion/print/split-exploded.png

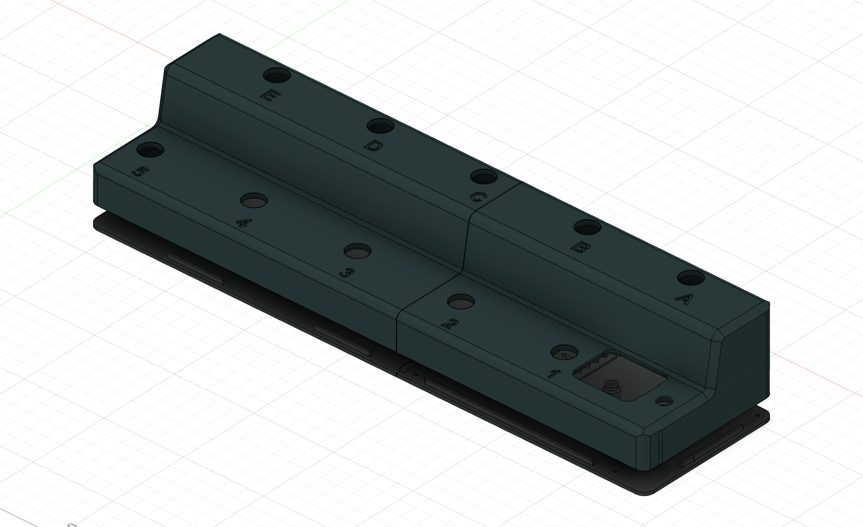
design/fusion/print/split-exploded.png
