awhite2000/sigmidi/design/fusion/print/straight-base-lips.png

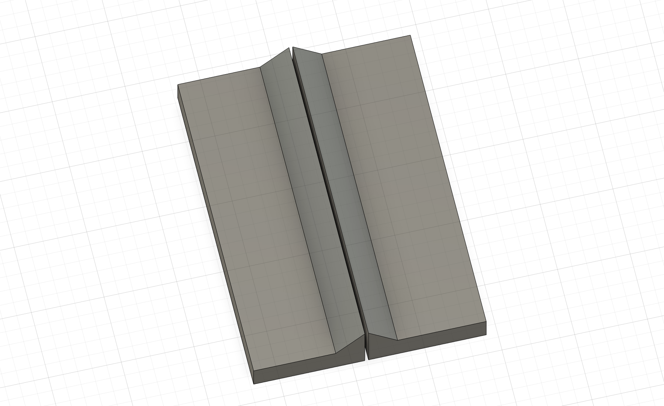
design/fusion/print/straight-base-lips.png
