awhite2000/sigmidi/previews/wifi-calibration-both-variants.png

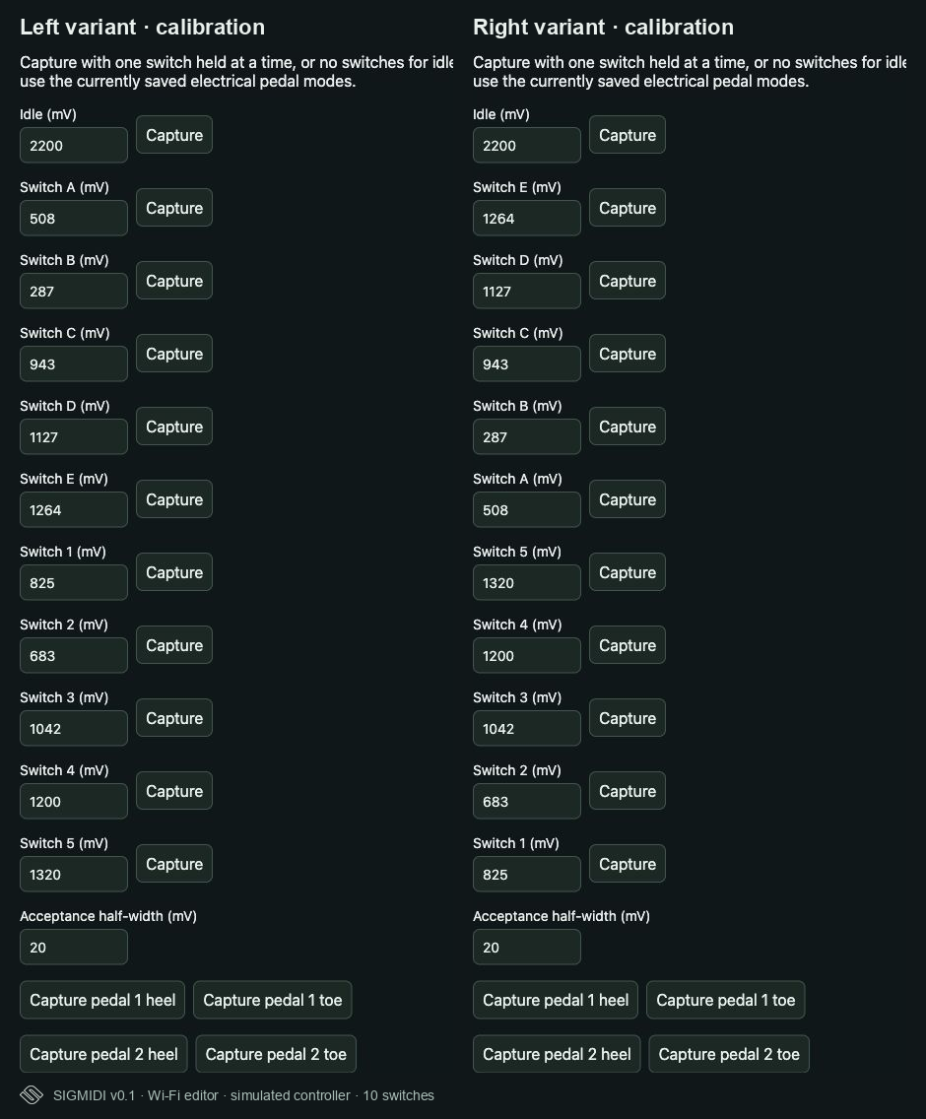
previews/wifi-calibration-both-variants.png
