awhite2000/sigmidi/previews/wifi-calibration.png

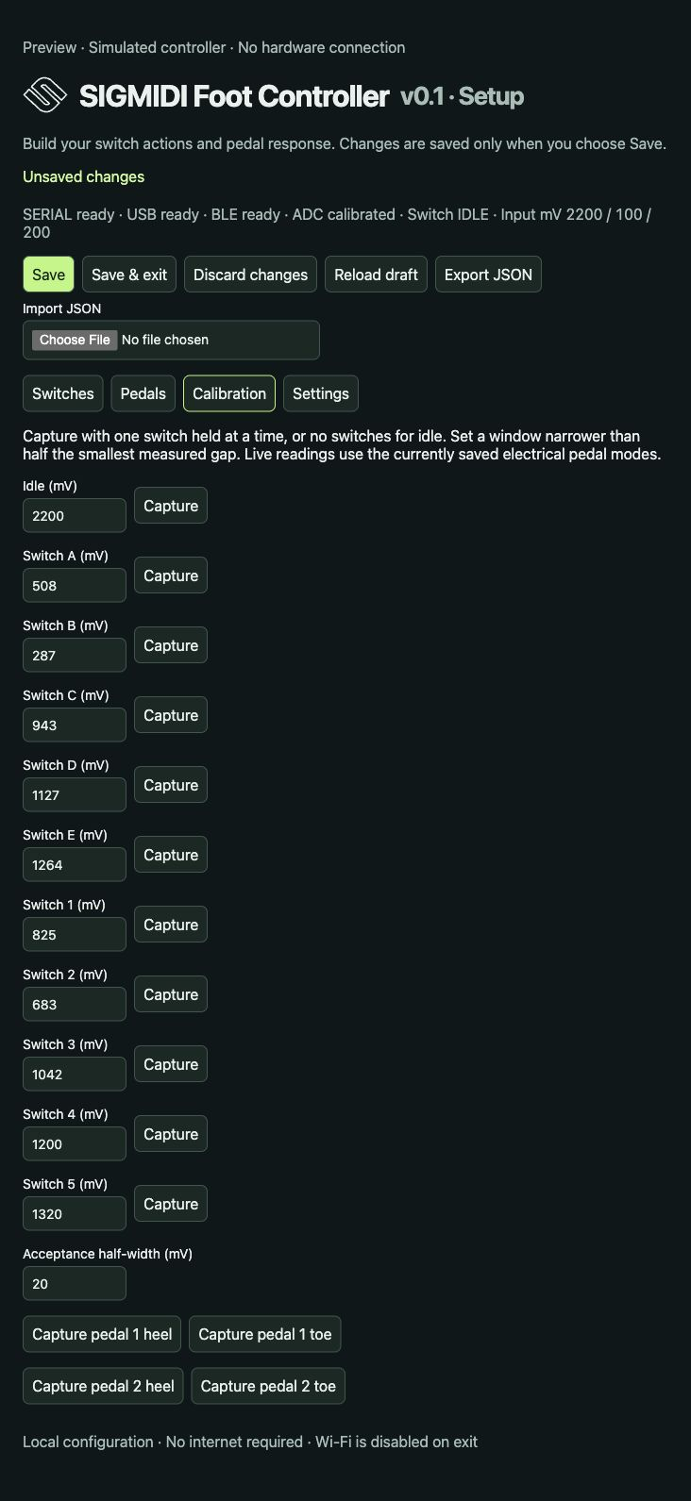
previews/wifi-calibration.png
