awhite2000/sigmidi/output/pdf/sigmidi-kicad-schematic.pdf

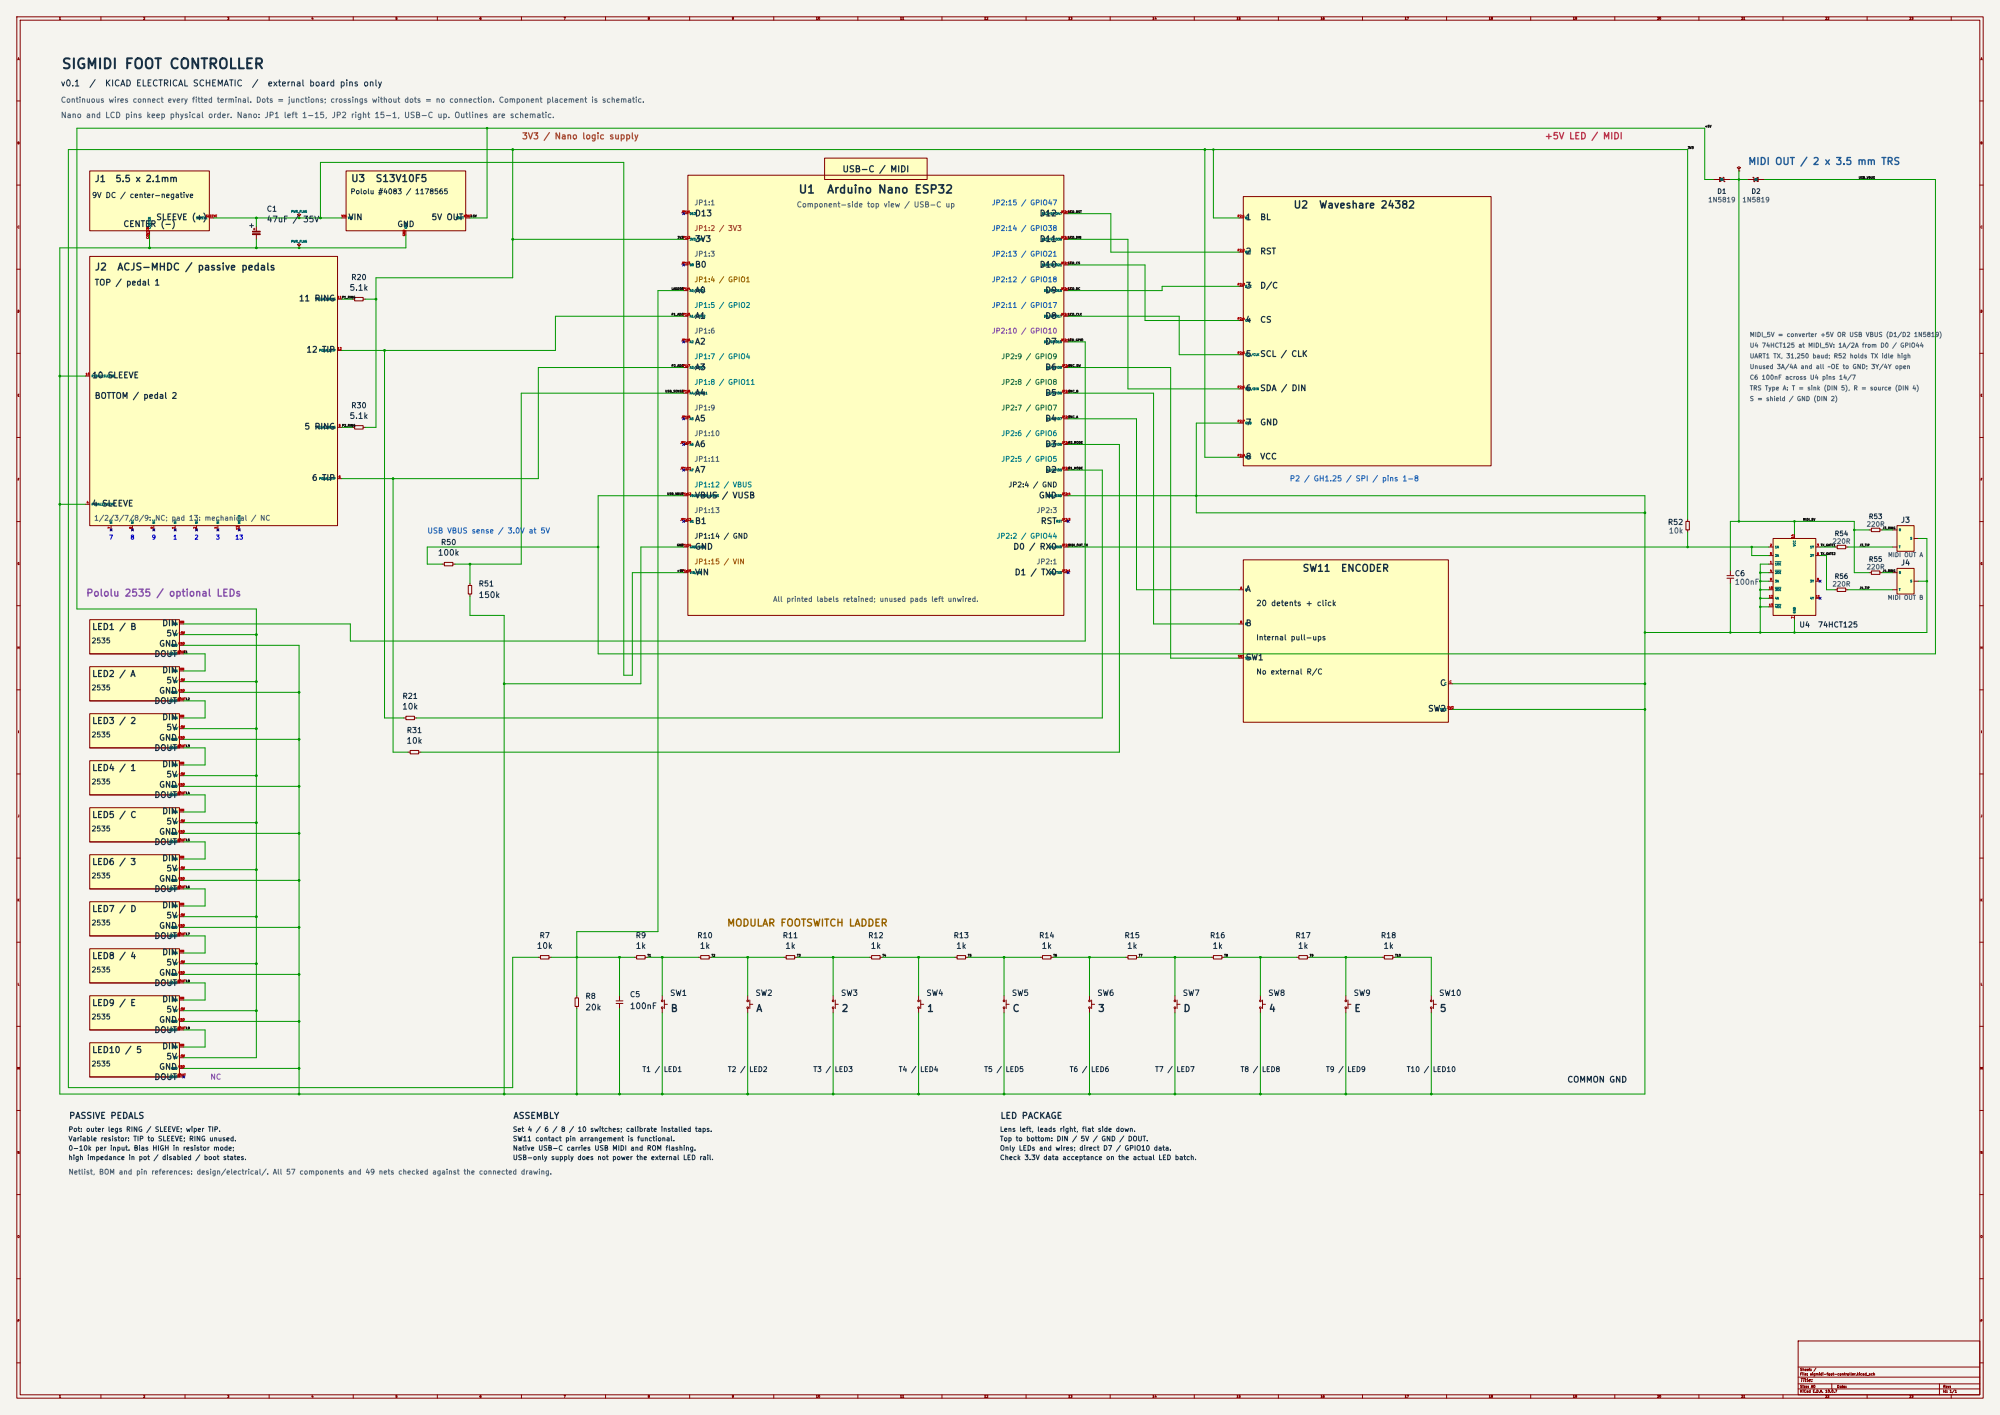
[picture p163: page 1]

v0.1 / KICAD ELECTRICAL SCHEMATIC / external board pins only

Continuous wires connect every fitted terminal. Dots = junctions; crossings without dots = no connection. Component placement is schematic.
Nano and LCD pins keep physical order. Nano: JP1 left 1-15, JP2 right 15-1, USB-C up. Outlines are schematic.

MIDI OUT / 2 x 3.5 mm TRS

Component-side top view / USB-C up

JP1:2B0 JP1:3 LADDER JP1:4 | | LCD_RST ENC_SW LCD_CS

J2 ACJS-MHDC / passive pedals
TOP / pedal 1

LCD_DC

P1_ADC JP1:5 | | LCD_CLK

MIDI_5V = converter +5V OR USB VBUS (D1/D2 1N5819)
U4 74HCT125 at MIDI_5V: 1A/2A from D0 / GPIO44
UART1 TX, 31,250 baud; R52 holds TX idle high
Unused 3A/4A and all ~OE to GND; 3Y/4Y open
C6 100nF across U4 pins 14/7
TRS Type A: T = sink (DIN 5), R = source (DIN 4)
S = shield / GND (DIN 2)

JP1:6 JP1:7 | | LED_GPIO

USB_VBUS USB_SENSE GND +9V JP1:9 JP1:10 JP1:11 | ENC_A ENC_B

P2_MODE

P1_MODE

JP1:12B1 JP1:14 | MIDI_OUT_TX

1/2/3/7/8/9: NC; pad 13: mechanical / NC

DOUTDOUT GND GND NC

USB VBUS sense / 3.0V at 5V

All printed labels retained; unused pads left unwired.

SW1 | SW1 SW1 No external R/C C C SW2 SW2 | C

Pot: outer legs RING / SLEEVE; wiper TIP.
Variable resistor: TIP to SLEEVE; RING unused.
0-10k per input. Bias HIGH in resistor mode;
high impedance in pot / disabled / boot states.
Netlist, BOM and pin references: design/electrical/. All 57 components and 49 nets checked against the connected drawing.

Set 4 / 6 / 8 / 10 switches; calibrate installed taps.
SW11 contact pin arrangement is functional.
Native USB-C carries USB MIDI and ROM flashing.
USB-only supply does not power the external LED rail.

Lens left, leads right, flat side down.
Top to bottom: DIN / 5V / GND / DOUT.
Only LEDs and wires; direct D7 / GPIO10 data.
Check 3.3V data acceptance on the actual LED batch.

Sheet: /
File: sigmidi-foot-controller.kicad_sch
Title:

Size: A0 | Rev:
KiCad E.D.A. 10.0.7 | Id: 1/1
