awhite2000/sigmidi/output/pdf/sigmidi-electrical-diagram.pdf

# Controller and display - external pins

## U1 Arduino Nano ESP32

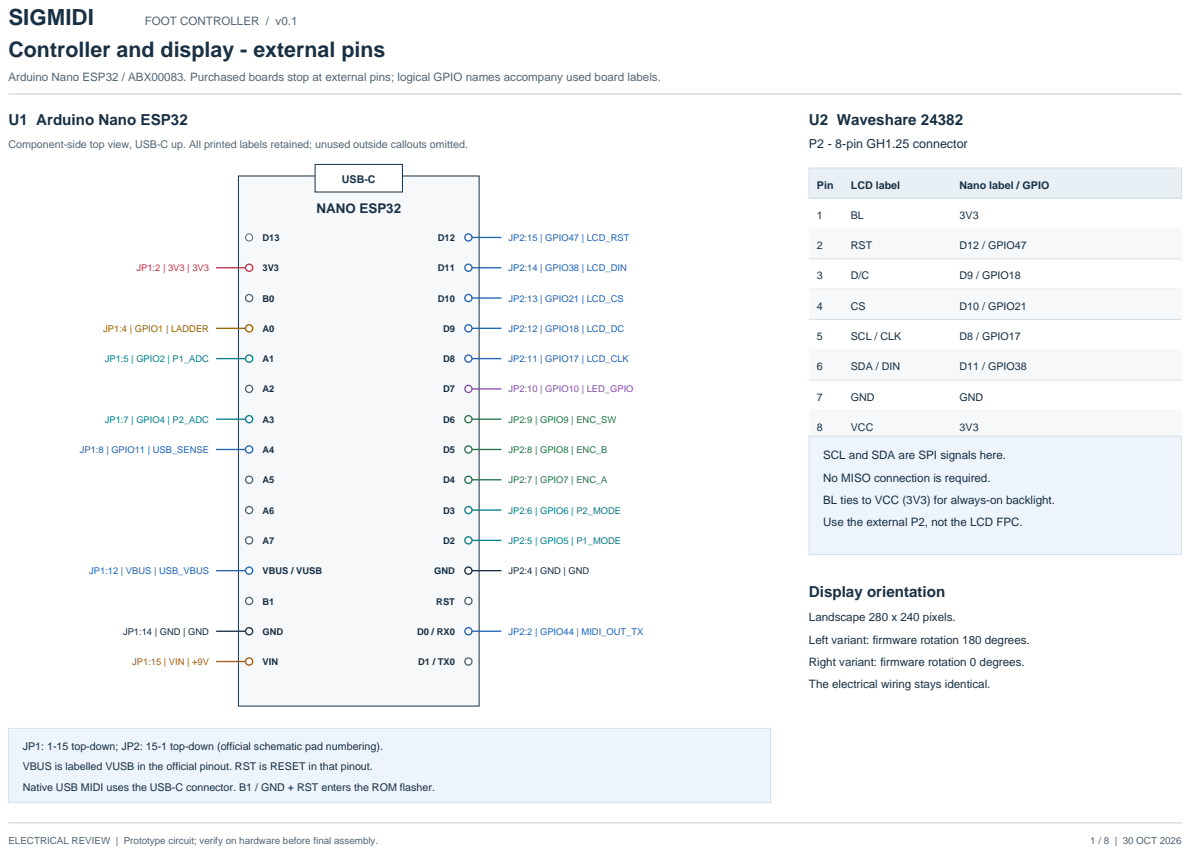
[picture p164: page 1]

Arduino Nano ESP32 / ABX00083. Purchased boards stop at external pins; logical GPIO names accompany used board labels.

Component-side top view, USB-C up. All printed labels retained; unused outside callouts omitted.

SCL and SDA are SPI signals here.
No MISO connection is required.
BL ties to VCC (3V3) for always-on backlight.
Use the external P2, not the LCD FPC.

Landscape 280 x 240 pixels.
Left variant: firmware rotation 180 degrees.
Right variant: firmware rotation 0 degrees.
The electrical wiring stays identical.

JP1: 1-15 top-down; JP2: 15-1 top-down (official schematic pad numbering).
VBUS is labelled VUSB in the official pinout. RST is RESET in that pinout.
Native USB MIDI uses the USB-C connector. B1 / GND + RST enters the ROM flasher.

# Power distribution and rotary encoder

## External power

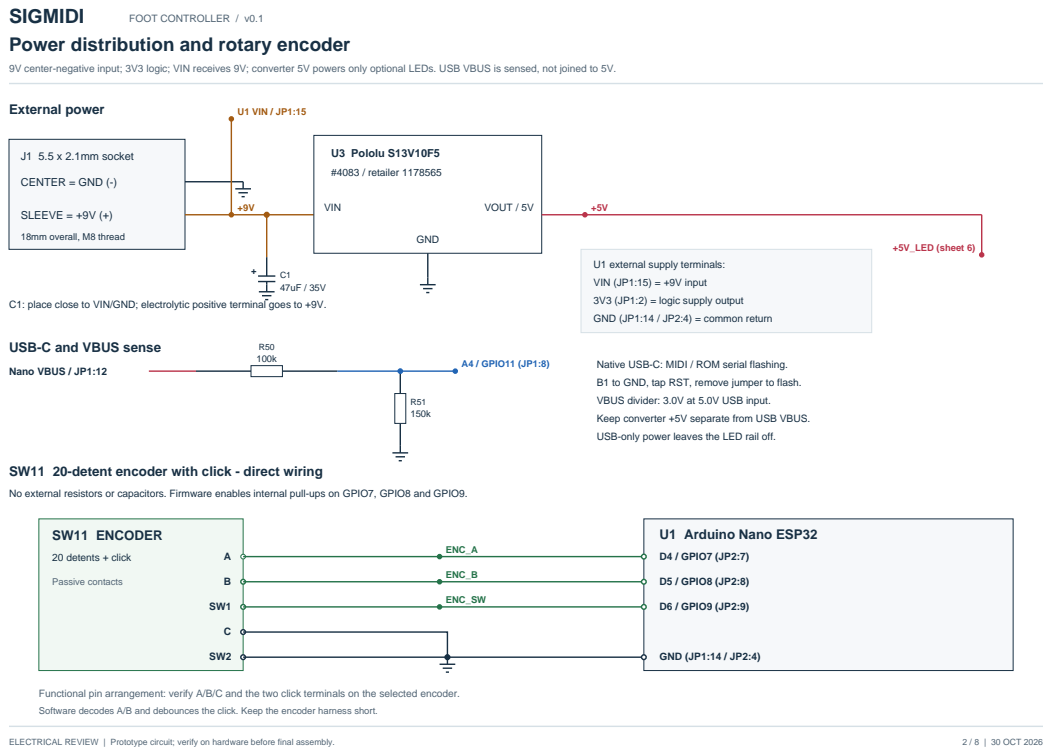
[picture p165: page 2]

9V center-negative input; 3V3 logic; VIN receives 9V; converter 5V powers only optional LEDs. USB VBUS is sensed, not joined to 5V.

C1: place close to VIN/GND; electrolytic positive terminal goes to +9V.

USB-C and VBUS sense

Native USB-C: MIDI / ROM serial flashing.
B1 to GND, tap RST, remove jumper to flash.
VBUS divider: 3.0V at 5.0V USB input.
Keep converter +5V separate from USB VBUS.
USB-only power leaves the LED rail off.

SW11 20-detent encoder with click - direct wiring

No external resistors or capacitors. Firmware enables internal pull-ups on GPIO7, GPIO8 and GPIO9.

Functional pin arrangement: verify A/B/C and the two click terminals on the selected encoder.
Software decodes A/B and debounces the click. Keep the encoder harness short.

# Modular footswitch resistor ladder

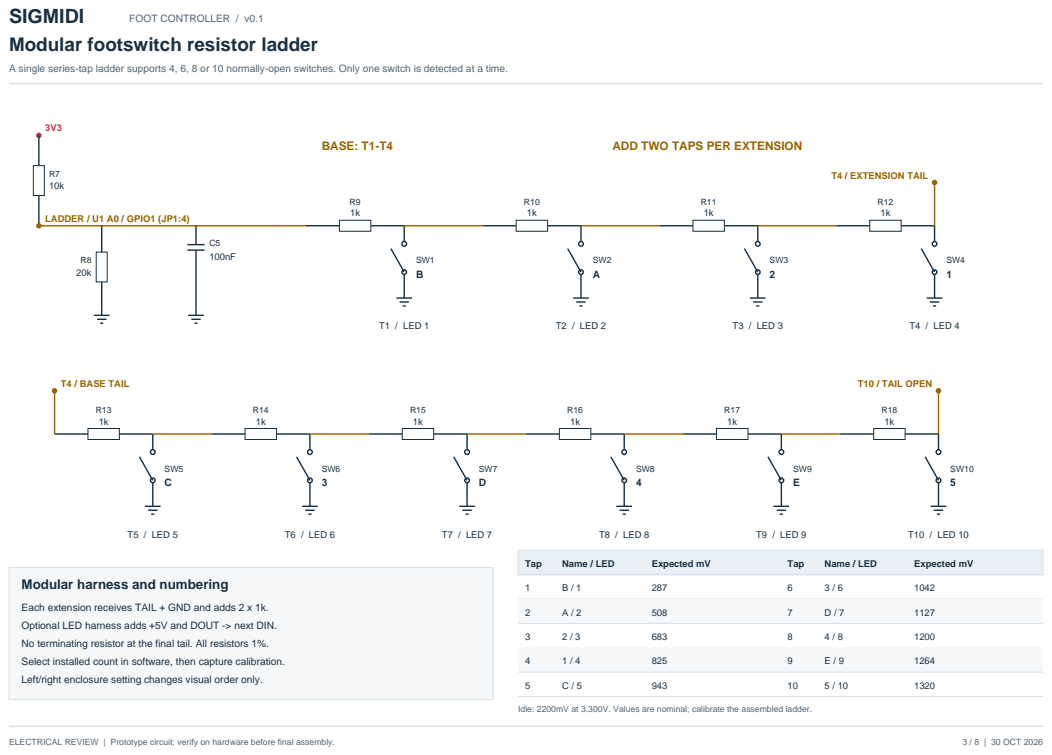
[picture p166: page 3]

A single series-tap ladder supports 4, 6, 8 or 10 normally-open switches. Only one switch is detected at a time.

Modular harness and numbering

Each extension receives TAIL + GND and adds 2 x 1k.
Optional LED harness adds +5V and DOUT -> next DIN.
No terminating resistor at the final tail. All resistors 1%.
Select installed count in software, then capture calibration.
Left/right enclosure setting changes visual order only.

Idle: 2200mV at 3.300V. Values are nominal; calibrate the assembled ladder.

# Continuous pedal input 1 - passive

Two resistors inside the controller. External pedal: passive variable resistor or potentiometer, 0-10k.

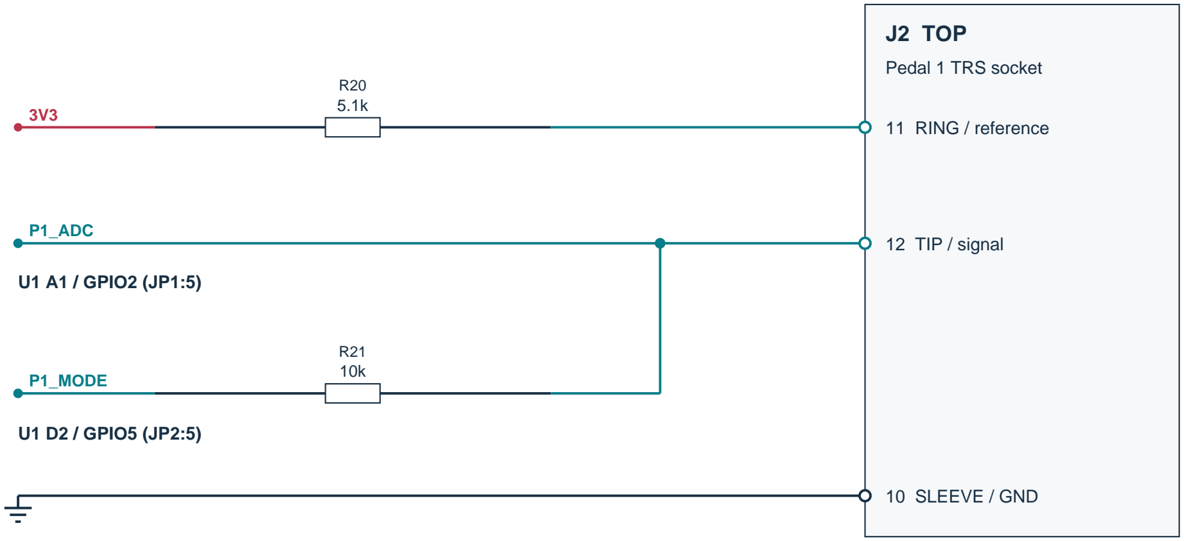
[picture p167: figure]
J2 TOP; Pedal 1 TRS socket; 11 RING / reference; P1_ADC; U1 A1 / GPIO2 (JP1:5); 12 TIP / signal; P1_MODE; U1 D2 / GPIO5 (JP2:5); 10 SLEEVE / GND
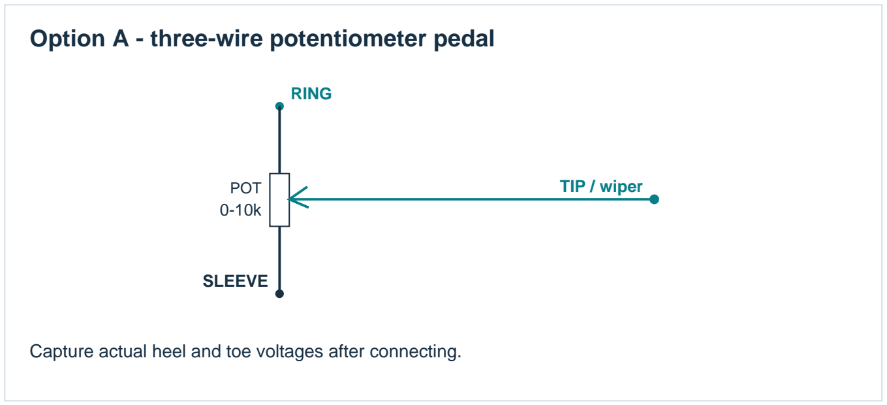
[picture p168: figure]
RING; POT 0-10k; SLEEVE; TIP / wiper

ELECTRICAL REVIEW | Prototype circuit; verify on hardware before final assembly. | 4 / 8 | 30 OCT 2026

## Inside the controller - only two resistors

## Firmware bias state

Resistor mode: mode GPIO = HIGH. Pot mode: mode GPIO = high impedance. Disabled / boot: high impedance. Internal pull-up and pull-down OFF. Never drive the bias GPIO LOW.

## Nominal values at 3.300V

10k variable resistor: TIP = 1650mV.

10k pot, full travel: TIP = 2185mV.

Ring short current: about 0.65mA.

ADC measures TIP directly (gain = 1).

## Option A - three-wire potentiometer pedal

Capture actual heel and toe voltages after connecting.

## Option B - two-wire variable resistor pedal

TIP

PEDAL R
0-10k

SLEEVE

RING unused; a TS plug may connect it to SLEEVE. Select resistor mode and configure maximum resistance.

No active pedal interface, scaling divider or external filter capacitors. J2 switched contacts remain NC; pad13 mechanical.

# Continuous pedal input 2 - passive

Two resistors inside the controller. External pedal: passive variable resistor or potentiometer, 0-10k.

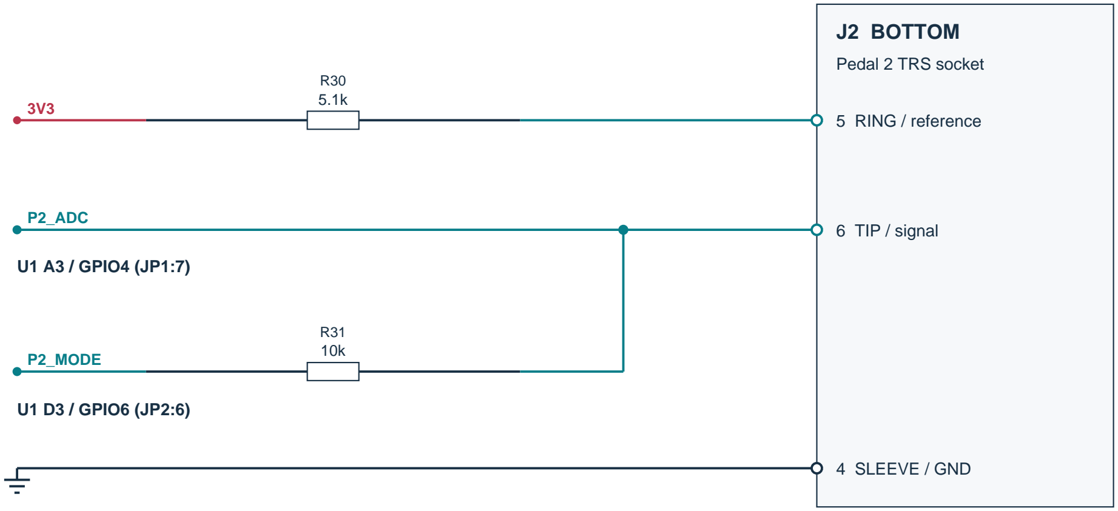
[picture p169: figure]
J2 BOTTOM; Pedal 2 TRS socket; 5 RING / reference; P2_ADC; U1 A3 / GPIO4 (JP1:7); 6 TIP / signal; P2_MODE; U1 D3 / GPIO6 (JP2:6); 4 SLEEVE / GND

ELECTRICAL REVIEW | Prototype circuit; verify on hardware before final assembly. | 5 / 8 | 30 OCT 2026

## Inside the controller - only two resistors

## Firmware bias state

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

## Nominal values at 3.300V

10k variable resistor: TIP = 1650mV.

10k pot, full travel: TIP = 2185mV.

Ring short current: about 0.65mA.

ADC measures TIP directly (gain = 1).

## Option A - three-wire potentiometer pedal

Capture actual heel and toe voltages after connecting.

## Option B - two-wire variable resistor pedal

TIP

PEDAL R
0-10k

SLEEVE

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

# Pololu 2535 - direct LED chain

## U1 Arduino Nano ESP32

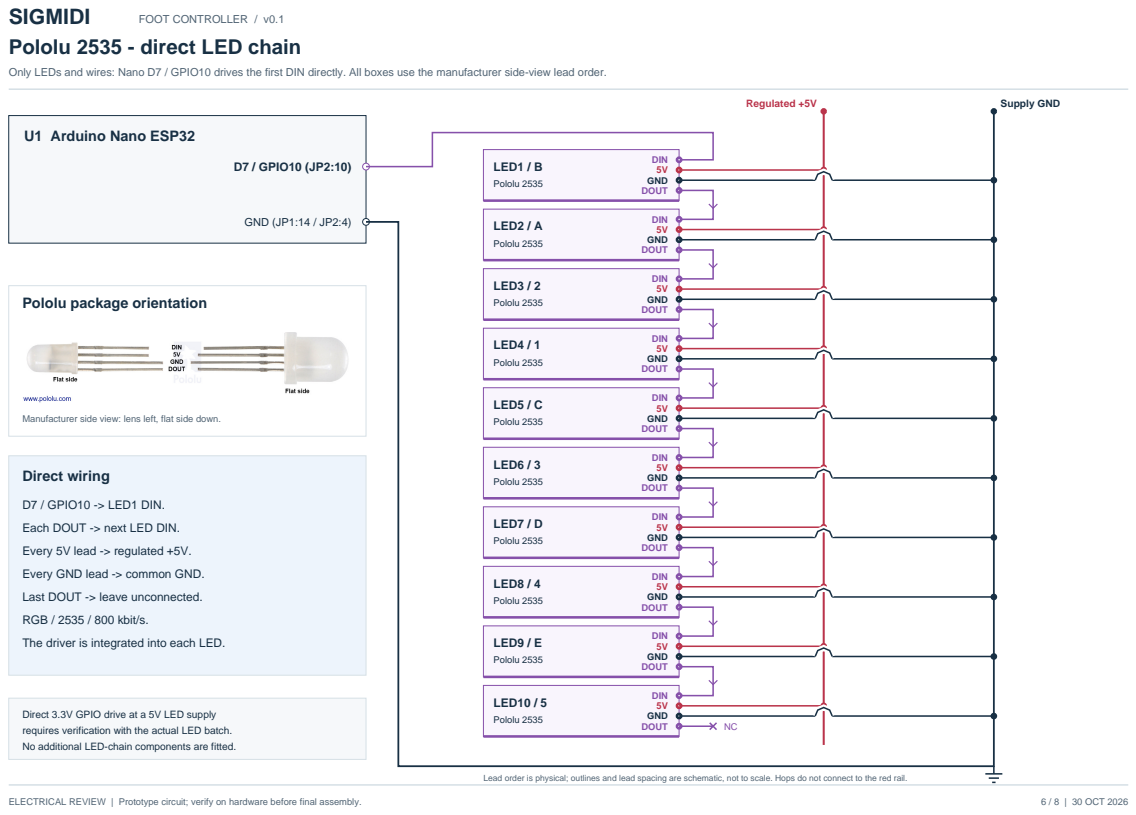
[picture p170: page 6]

Only LEDs and wires: Nano D7 / GPIO10 drives the first DIN directly. All boxes use the manufacturer side-view lead order.

Manufacturer side view: lens left, flat side down.

D7 / GPIO10 -> LED1 DIN.
Each DOUT -> next LED DIN.
Every 5V lead -> regulated +5V.
Every GND lead -> common GND.
Last DOUT -> leave unconnected.
RGB / 2535 / 800 kbit/s.
The driver is integrated into each LED.

Direct 3.3V GPIO drive at a 5V LED supply
requires verification with the actual LED batch.
No additional LED-chain components are fitted.

Lead order is physical; outlines and lead spacing are schematic, not to scale. Hops do not connect to the red rail.

# MIDI OUT - two 3.5 mm TRS current loops

UART1 TX at 31,250 baud, 8-N-1; 74HCT125 gates 1 and 2 each drive one TRS Type A output. UART0 remains ROM-flash serial.

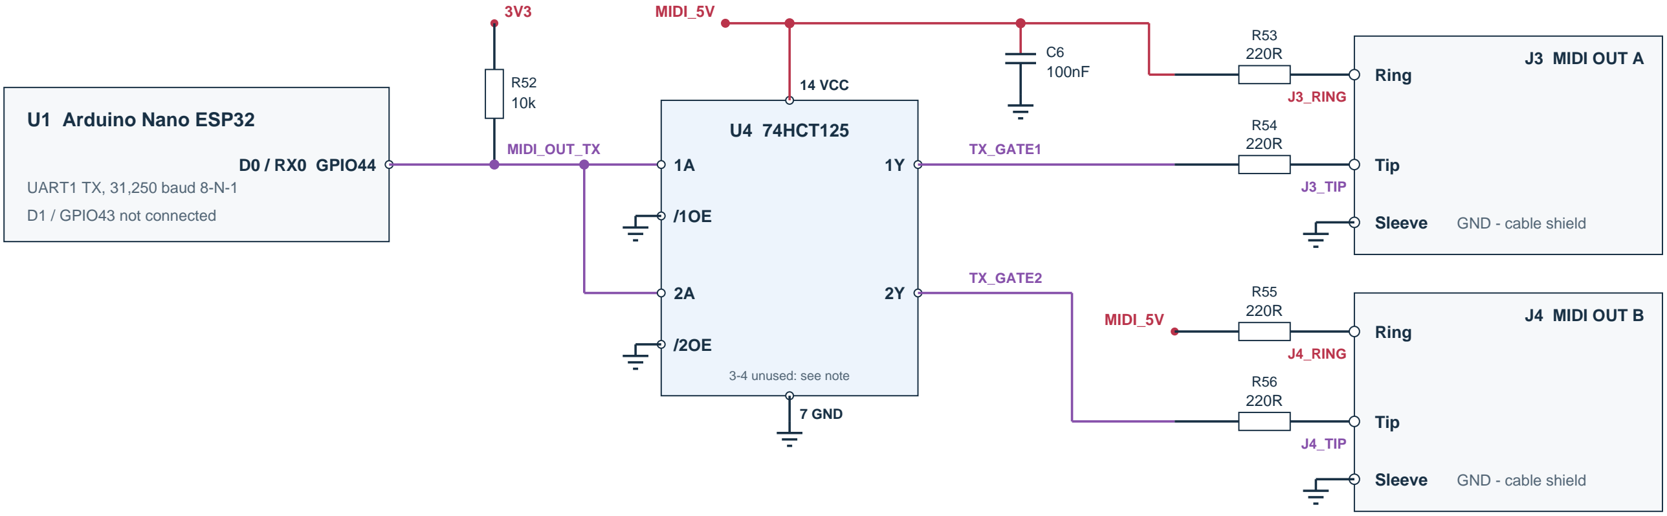
[picture p171: figure]
U1 Arduino Nano ESP32; UART1 TX, 31,250 baud 8-N-1; D1 / GPIO43 not connected; D0 / RX0 GPIO44; MIDI_OUT_TX; U4 74HCT125; 3-4 unused: see note; 14 VCC; 7 GND; MIDI_5V; TX_GATE1; TX_GATE2; J3 MIDI OUT A; Ring; J3_RING; Tip; J3_TIP; Sleeve; GND - cable shield; J4 MIDI OUT B; J4_RING; J4_TIP
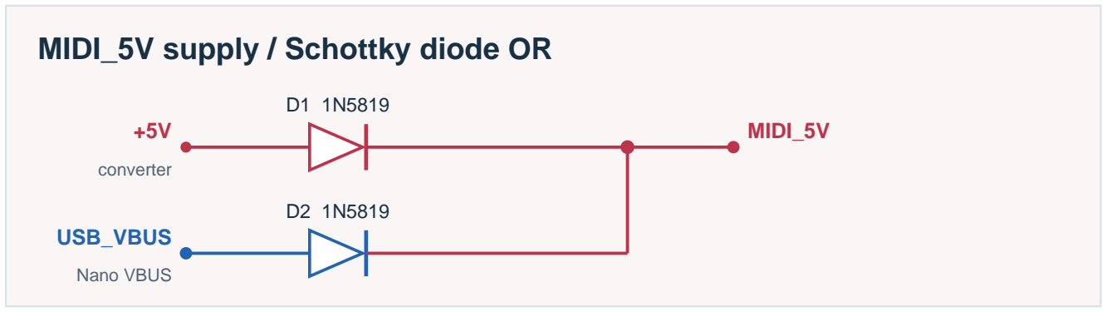
[picture p172: figure]
MIDI_5V supply / Schottky diode OR; USB_VBUS; MIDI_5V; converter; Nano VBUS

ELECTRICAL REVIEW | Prototype circuit; verify on hardware before final assembly. | 7 / 8 | 30 OCT 2026
UART TX, idle pull-up and 74HCT125 buffer | J3 / J4 3.5 mm TRS, Type A

## Buffer and supply notes

R52 holds both buffer inputs idle-high during reset.
U4 /1OE and /2OE grounded; C6 directly across pins 14 / 7. Unused inputs 9 / 12 and /OE 10 / 13 to GND;
outputs 8 / 11 left open.
Diodes isolate converter +5V and USB VBUS.

Each loop: MIDI_5V -> 220R -> ring -> receiver optocoupler -> tip -> 220R -> buffer output sink (J3: R53/R54/1Y, J4: R55/R56/2Y).

TRS Type A: tip = DIN pin 5, ring = DIN pin 4, sleeve = DIN pin 2. Each sleeve connects to GND to ground the cable shield.

One-way outputs only; no receive connection to the Nano. Use Type A adapters or cables for 5-pin DIN receivers.

# Assembly reference, options and sources

The accompanying netlist and connection schedule include every external component terminal shown in this set.

ELECTRICAL REVIEW | Prototype circuit; verify on hardware before final assembly. | 8 / 8 | 30 OCT 2026

## Harness and assembly rules

All GND symbols are the same electrical net. Run analog returns separately to the controller ground point. Keep LADDER and pedal signals away from LED power/data and the DC converter. Pair signals with ground. Feed LED +5V/GND directly from the power distribution, rather than through the Nano headers.
The 10-pixel chain can draw about 0.5A at full white. Keep total load within the 1A converter rating.
LED lead order, lens pointing left and leads right, flat side down: top DIN, +5V, GND, bottom DOUT.
The LED chain contains only Pololu 2535 LEDs and wiring: GPIO10 directly to the first DIN.
Encoder terminal labels are functions; a specific encoder package pin numbering has not been selected. GPIO numbers are logical; D/A labels and SCK/MOSI/TX names identify the external board pins.

## Prototype verification

With power disconnected: continuity-check TRS terminals, power polarity, ground and all off-sheet nets.
Verify regulated +5V, then U1 3V3. Flash the passive-input firmware and recalibrate both pedals.
Check resistor-mode HIGH / pot-mode high impedance, ADC ranges, ladder taps, encoder, TRS, USB and BLE MIDI. Each passive pedal input uses two resistors. Connect only unpowered variable-resistor or pot pedals.
This document does not establish ESD compliance, measured analog accuracy (https://docs.arduino.cc/resources/pinouts/ABX00083-full-pinout.pdf) or simultaneous-supply qualification.
Source documents checked (https://docs.arduino.cc/resources/schematics/ABX00083-schematics.pdf)
Arduino Nano ESP32 ABX00083 pinout | Component-side (https://www.waveshare.com/wiki/1.69inch_LCD_Module) top view, USB-C up; all 30 header pads
Arduino Nano ESP32 schematic V0.3 | JP1: 1-15 top-down; JP2: 15-1 top-down
Waveshare 24382 external P2 connector | Local: design/fusion/datasheets/waveshare-24382-schematic.pdf (https://www.pololu.com/product/4083)
Amphenol ACJS-MHDC socket drawing | Local: design/fusion/datasheets/double-trs-ACJS-MHDC.pdf
Pololu S13V10F5 / #4083 | 5V, 1A step-up/down regulator; retailer item 1178565
Pololu #2535 (https://docs.espressif.com/projects/esp-usb/en/latest/esp32s3/usb_device.html) | 5mm addressable RGB LED / WS2811 / 5V / 800kHz
Espressif self-powered USB devices | VBUS sense: (https://midi.org/midi-1-0-detailed-specification) 100k / 150k divider to A4 / GPIO11
MIDI Association - MIDI 1.0 electrical specifications | 5 V current-loop interface; TRS Type A pin mapping

Source URLs, BOM, exact terminal connectivity and generated SVG sheets are in design/electrical/.
