awhite2000/sigmidi/output/pdf/sigmidi-electrical-single-page.pdf

## U1 Arduino Nano ESP32

## U2 Waveshare 24382

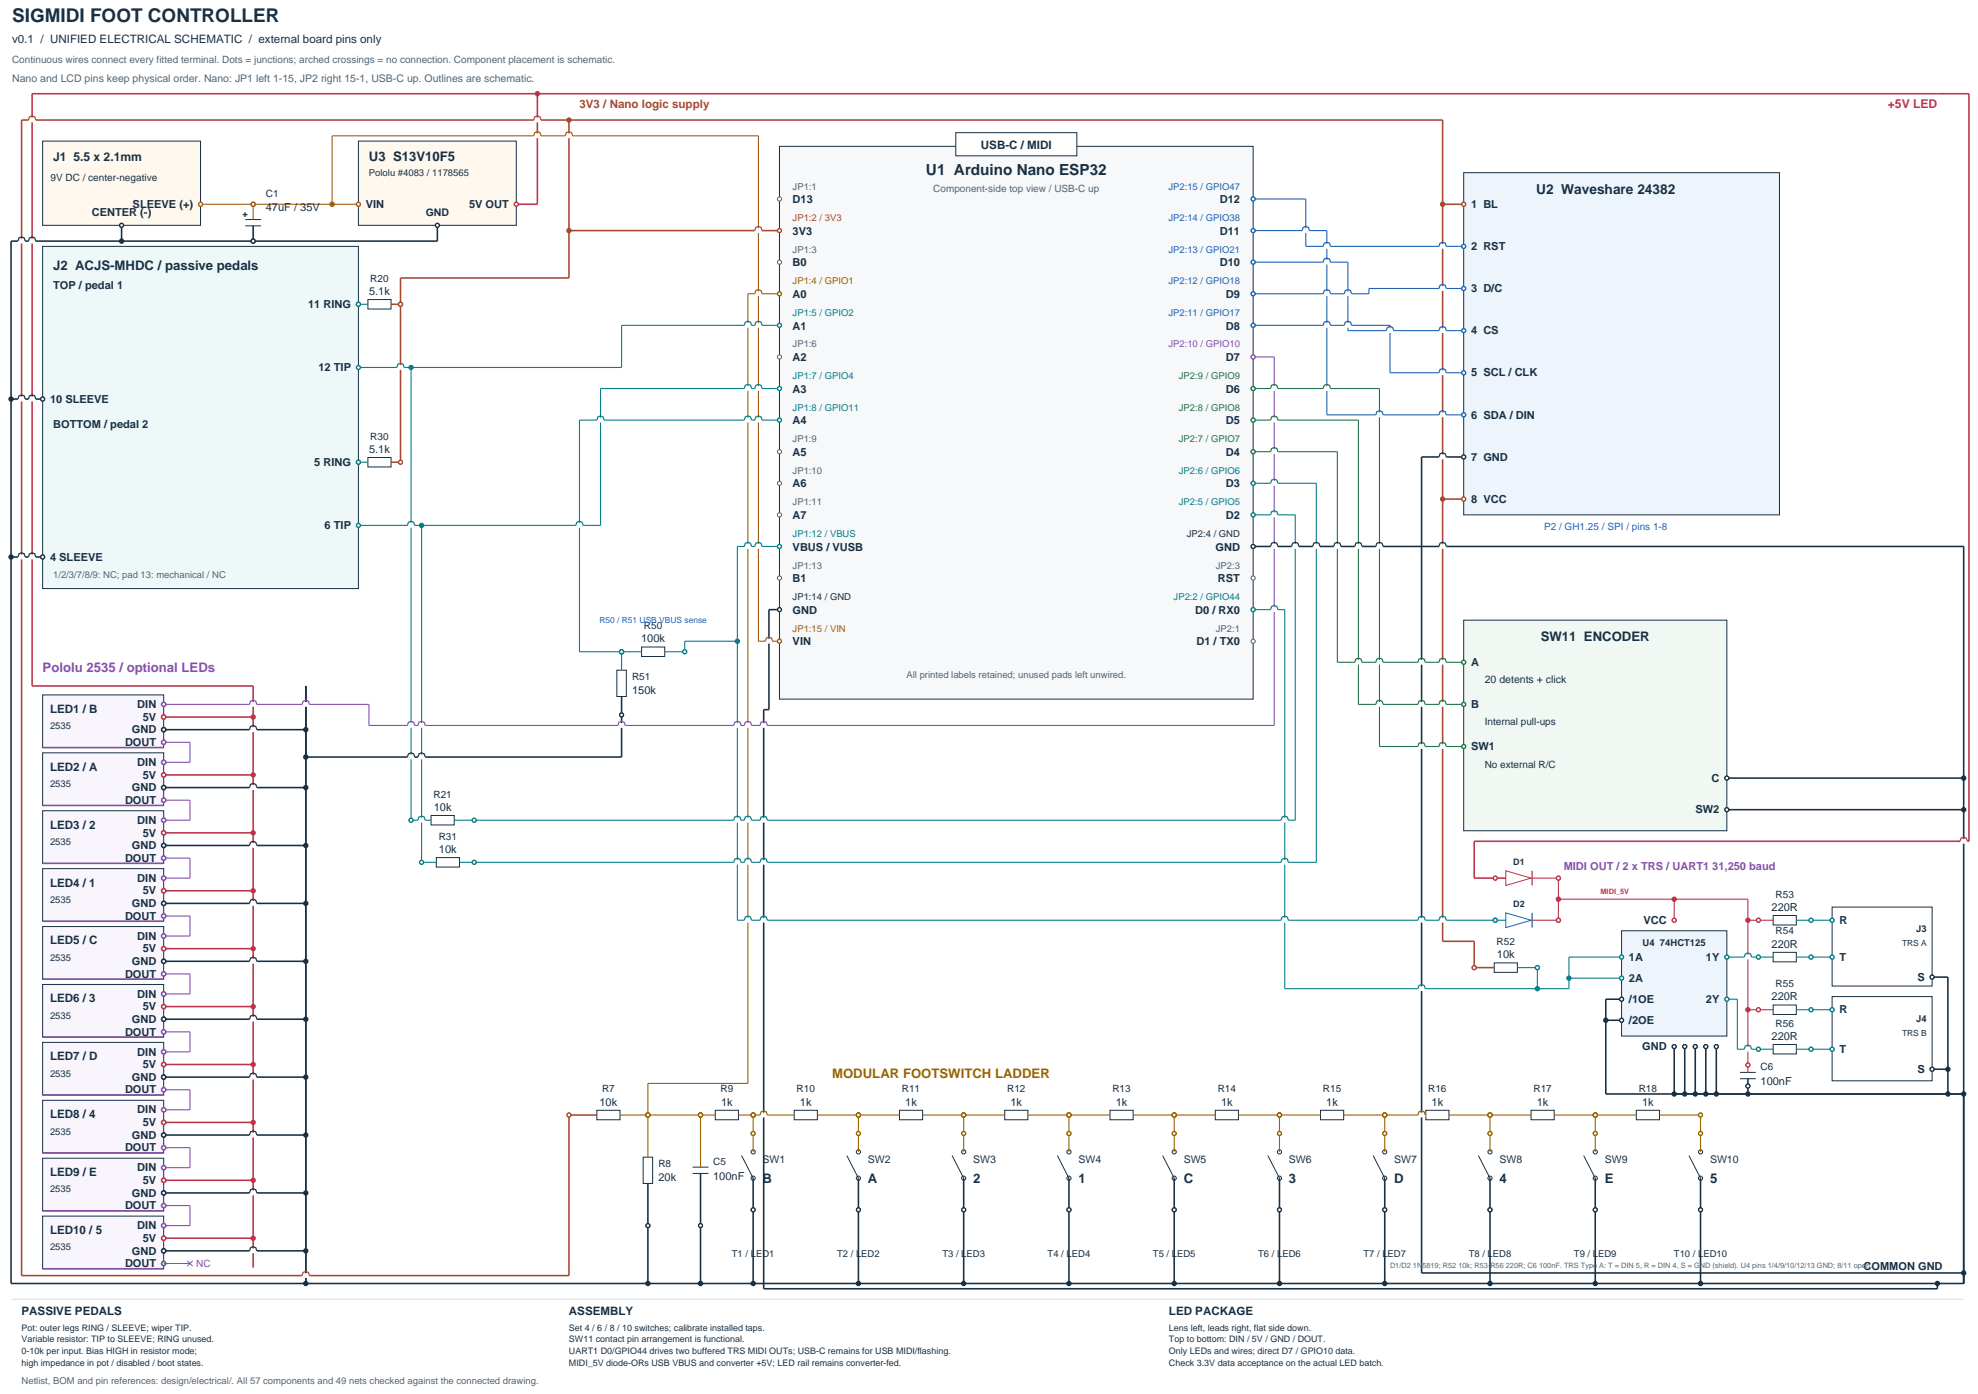
[picture p173: page 1]

v0.1 / UNIFIED ELECTRICAL SCHEMATIC / external board pins only
Continuous wires connect every fitted terminal. Dots = junctions; arched crossings = no connection. Component placement is schematic.
Nano and LCD pins keep physical order. Nano: JP1 left 1-15, JP2 right 15-1, USB-C up. Outlines are schematic.

J2 ACJS-MHDC / passive pedals
TOP / pedal 1

4 SLEEVE
1/2/3/7/8/9: NC; pad 13: mechanical / NC

All printed labels retained; unused pads left unwired.

MIDI OUT / 2 x TRS / UART1 31,250 baud

D1/D2 1N5819; R52 10k; R53-R56 220R; C6 100nF. TRS Type A: T = DIN 5, R = DIN 4, S = GND (shield). U4 pins 1/4/9/10/12/13 GND; 8/11 open.

PASSIVE PEDALS
Pot: outer legs RING / SLEEVE; wiper TIP.
Variable resistor: TIP to SLEEVE; RING unused.
0-10k per input. Bias HIGH in resistor mode;
high impedance in pot / disabled / boot states.
Netlist, BOM and pin references: design/electrical/. All 57 components and 49 nets checked against the connected drawing.

ASSEMBLY
Set 4 / 6 / 8 / 10 switches; calibrate installed taps.
SW11 contact pin arrangement is functional.
UART1 D0/GPIO44 drives two buffered TRS MIDI OUTs; USB-C remains for USB MIDI/flashing.
MIDI_5V diode-ORs USB VBUS and converter +5V; LED rail remains converter-fed.

LED PACKAGE
Lens left, leads right, flat side down.
Top to bottom: DIN / 5V / GND / DOUT.
Only LEDs and wires; direct D7 / GPIO10 data.
Check 3.3V data acceptance on the actual LED batch.
