awhite2000/sigmidi/design/kicad/sigmidi-foot-controller.kicad_sch

## KiCad design design/kicad/sigmidi-foot-controller.kicad_sch (2026-11-01)

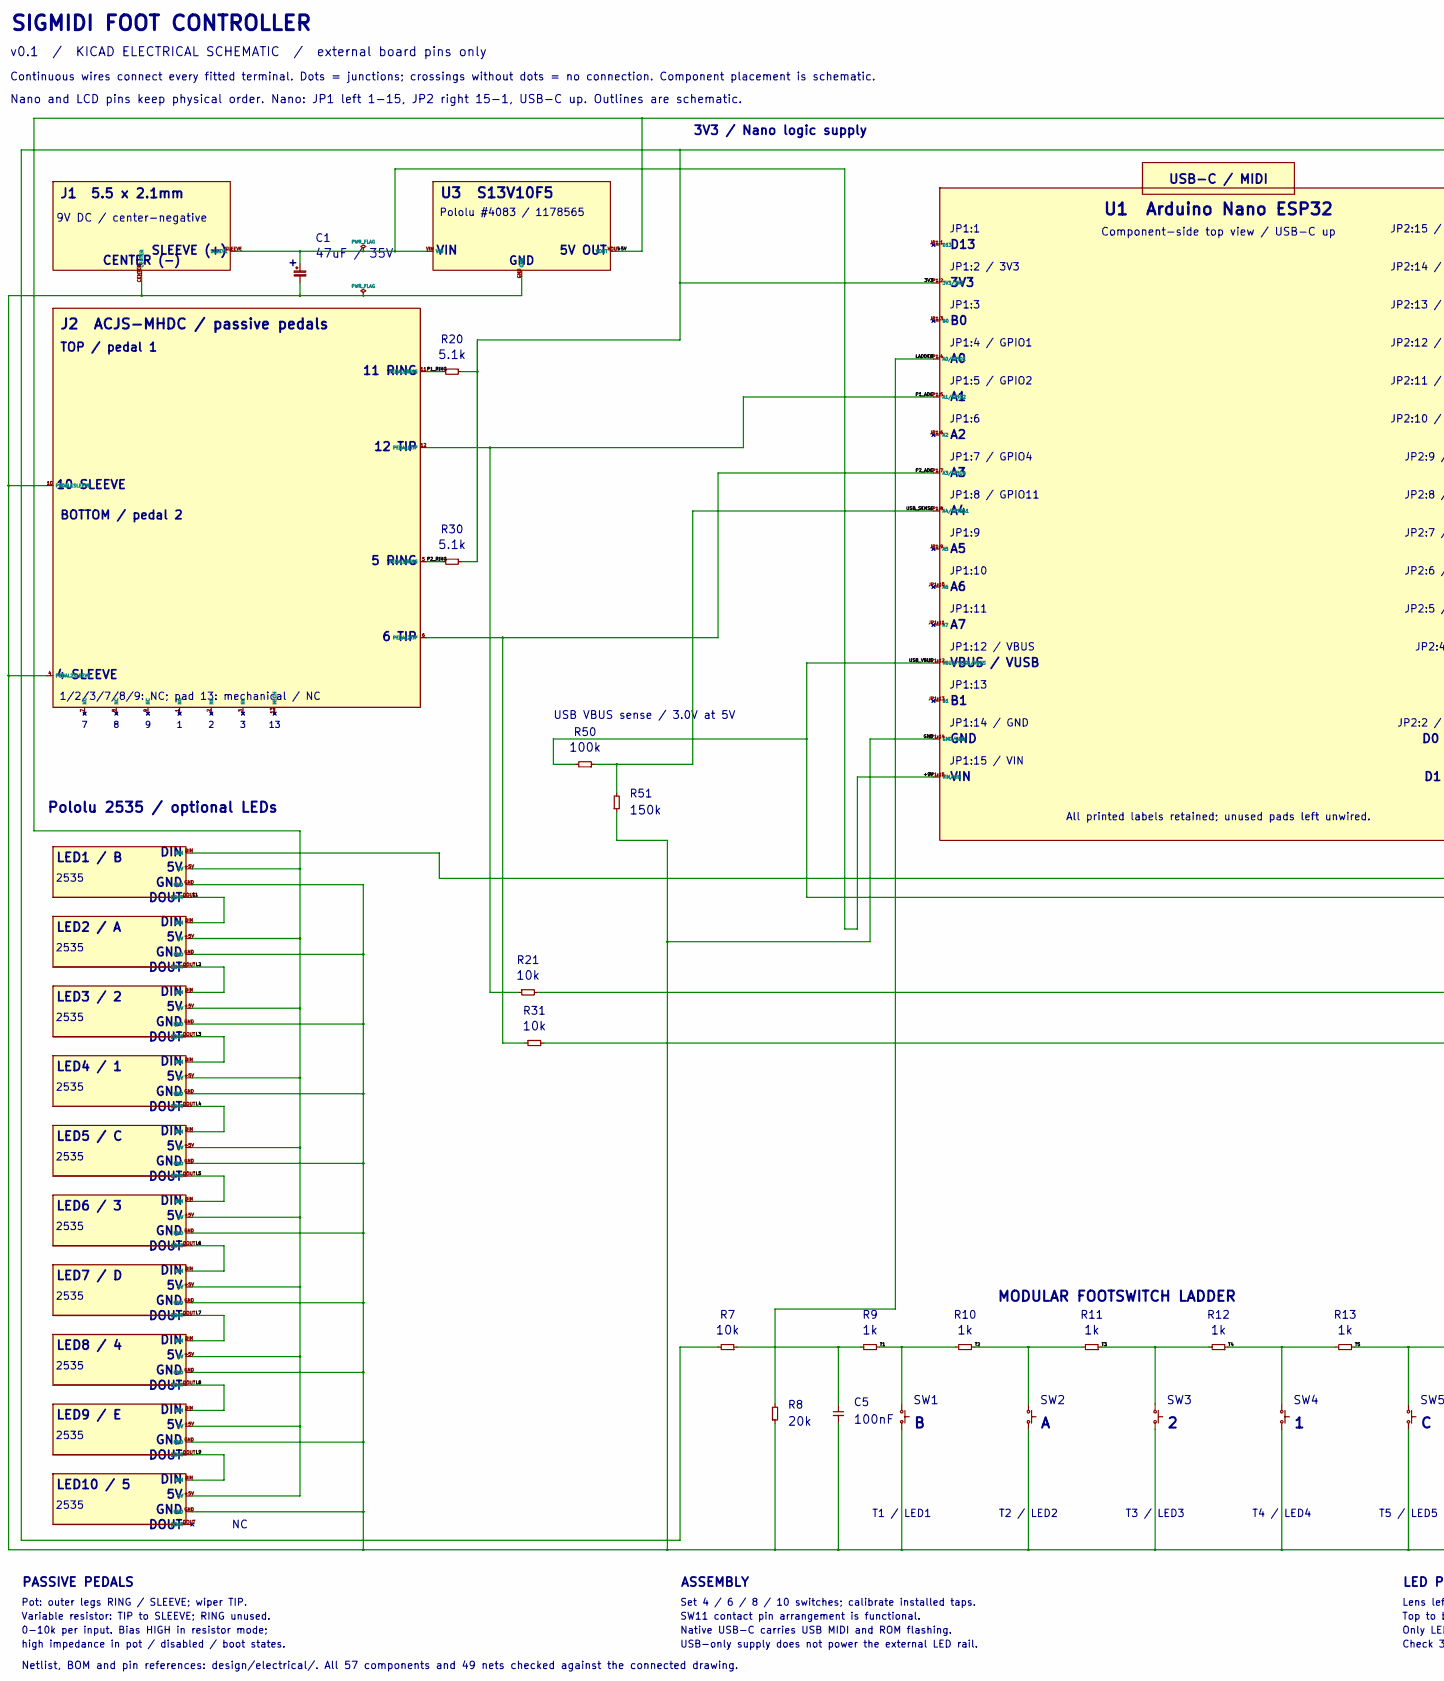
[picture p174: schematic sigmidi-foot-controller.kicad_sch, part in row 1, column 1]

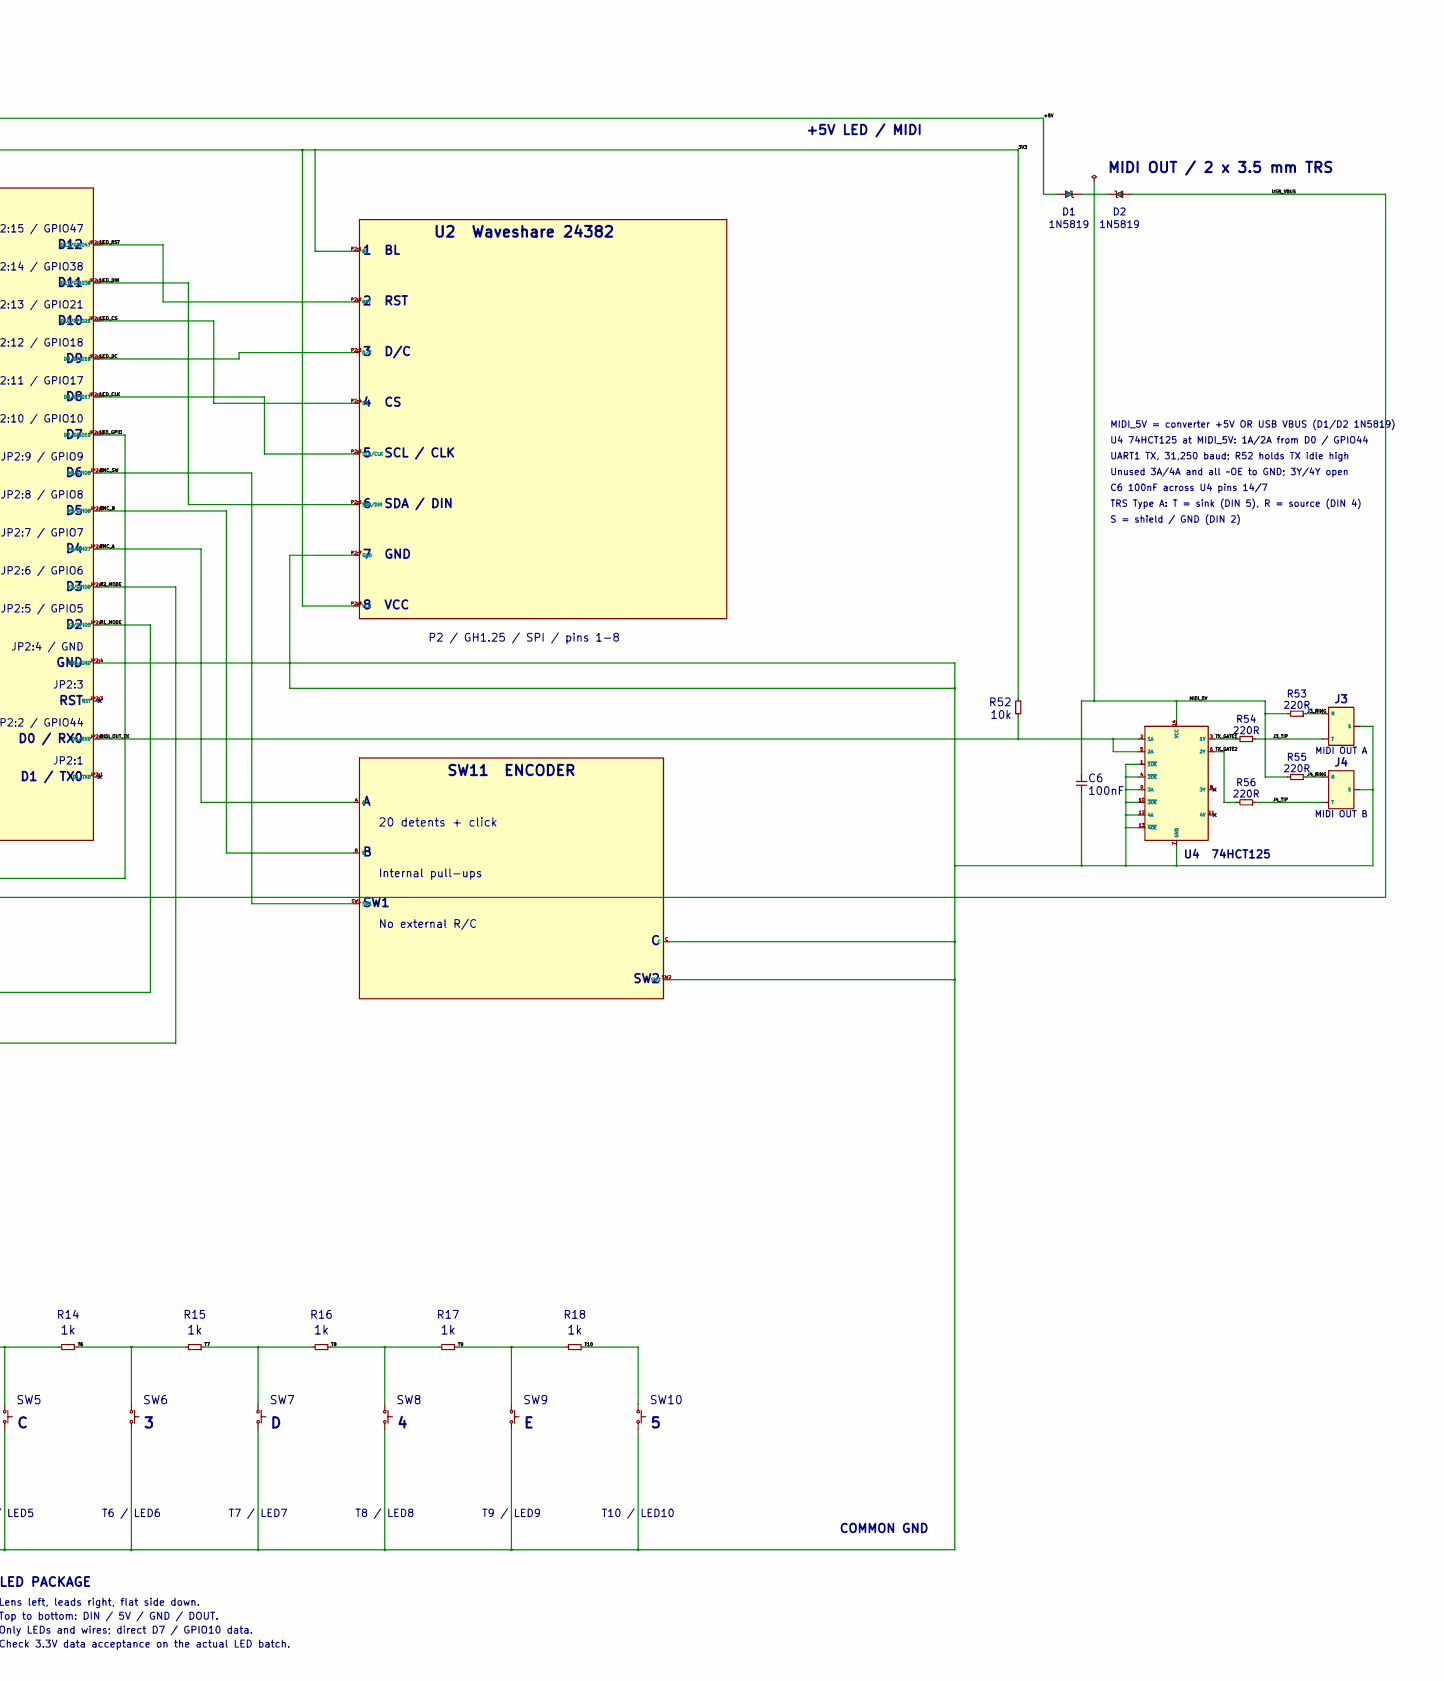
[picture p175: schematic sigmidi-foot-controller.kicad_sch, part in row 1, column 2]

Parts:
C1: 47uF / 35V
C5, C6: 100nF
D1, D2: 1N5819
J1: 5.5x2.1mm center-negative
J2: Amphenol ACJS-MHDC
J3, J4: 3.5 mm TRS MIDI OUT
LED1, LED2, LED3, LED4, LED5, LED6, LED7, LED8, LED9, LED10: Pololu 2535
R7, R21, R31, R52: 10k
R8: 20k
R9, R10, R11, R12, R13, R14, R15, R16, R17, R18: 1k
R20, R30: 5.1k
R50: 100k
R51: 150k
R53, R54, R55, R56: 220R
SW1, SW2, SW3, SW4, SW5, SW6, SW7, SW8, SW9, SW10: momentary NO
SW11: 20-detent rotary encoder + NO click
U1: Arduino Nano ESP32 ABX00083
U2: Waveshare 24382
U3: Pololu S13V10F5 #4083
U4: 74HCT125

Connections:
3V3: R7.1, R20.1, R30.1, R52.1, U1.JP1:2 (3V3/3V3), U2.P2:1 (BL), U2.P2:8 (VCC)
+5V: D1.A, LED1.+5V (5V), LED2.+5V (5V), LED3.+5V (5V), LED4.+5V (5V), LED5.+5V (5V), LED6.+5V (5V), LED7.+5V (5V), LED8.+5V (5V), LED9.+5V (5V), LED10.+5V (5V), U3.VOUT
+9V: C1.1, J1.SLEEVE, U1.JP1:15 (VIN/VIN), U3.VIN
ENC_A: SW11.A, U1.JP2:7 (D4/GPIO7)
ENC_B: SW11.B, U1.JP2:8 (D5/GPIO8)
ENC_SW: SW11.SW1, U1.JP2:9 (D6/GPIO9)
GND: C1.2, C5.2, C6.2, J1.CENTER, J2.4 (PEDAL2SLEEVE), J2.10 (PEDAL1SLEEVE), J3.S, J4.S, LED1.GND, LED2.GND, LED3.GND, LED4.GND, LED5.GND, LED6.GND, LED7.GND, LED8.GND, LED9.GND, LED10.GND, R8.2, R51.2, SW1.2, SW2.2, SW3.2, SW4.2, SW5.2, SW6.2, SW7.2, SW8.2, SW9.2, SW10.2, SW11.C, SW11.SW2, U1.JP1:14 (GND/GND), U1.JP2:4 (GND/GND), U2.P2:7 (GND), U3.GND, U4.1 (~1OE), U4.4 (~2OE), U4.7 (GND), U4.9 (3A), U4.10 (~3OE), U4.12 (4A), U4.13 (~4OE)
J3_RING: J3.R, R53.2
J3_TIP: J3.T, R54.2
J4_RING: J4.R, R55.2
J4_TIP: J4.T, R56.2
L1: LED1.DOUT, LED2.DIN
L2: LED2.DOUT, LED3.DIN
L3: LED3.DOUT, LED4.DIN
L4: LED4.DOUT, LED5.DIN
L5: LED5.DOUT, LED6.DIN
L6: LED6.DOUT, LED7.DIN
L7: LED7.DOUT, LED8.DIN
L8: LED8.DOUT, LED9.DIN
L9: LED9.DOUT, LED10.DIN
LADDER: C5.1, R7.2, R8.1, R9.1, U1.JP1:4 (A0/GPIO1)
LCD_CLK: U1.JP2:11 (D8/GPIO17), U2.P2:5 (SCL/CLK)
LCD_CS: U1.JP2:13 (D10/GPIO21), U2.P2:4 (CS)
LCD_DC: U1.JP2:12 (D9/GPIO18), U2.P2:3 (D/C)
LCD_DIN: U1.JP2:14 (D11/GPIO38), U2.P2:6 (SDA/DIN)
LCD_RST: U1.JP2:15 (D12/GPIO47), U2.P2:2 (RST)
LED_GPIO: LED1.DIN, U1.JP2:10 (D7/GPIO10)
MIDI_5V: C6.1, D1.K, D2.K, R53.1, R55.1, U4.14 (VCC)
MIDI_OUT_TX: R52.2, U1.JP2:2 (D0/RX0), U4.2 (1A), U4.5 (2A)
P1_ADC: J2.12 (PEDAL1TIP), R21.2, U1.JP1:5 (A1/GPIO2)
P1_MODE: R21.1, U1.JP2:5 (D2/GPIO5)
P1_RING: J2.11 (PEDAL1RING), R20.2
P2_ADC: J2.6 (PEDAL2TIP), R31.2, U1.JP1:7 (A3/GPIO4)
P2_MODE: R31.1, U1.JP2:6 (D3/GPIO6)
P2_RING: J2.5 (PEDAL2RING), R30.2
T1: R9.2, R10.1, SW1.1
T2: R10.2, R11.1, SW2.1
T3: R11.2, R12.1, SW3.1
T4: R12.2, R13.1, SW4.1
T5: R13.2, R14.1, SW5.1
T6: R14.2, R15.1, SW6.1
T7: R15.2, R16.1, SW7.1
T8: R16.2, R17.1, SW8.1
T9: R17.2, R18.1, SW9.1
T10: R18.2, SW10.1
TX_GATE1: R54.1, U4.3 (1Y)
TX_GATE2: R56.1, U4.6 (2Y)
USB_SENSE: R50.2, R51.1, U1.JP1:8 (A4/GPIO11)
USB_VBUS: D2.A, R50.1, U1.JP1:12 (VBUS/VUSB/VBUS)

Notes on the sheet:
USB-C / MIDI
U1 Arduino Nano ESP32
Component-side top view / USB-C up
JP1:1
D13
JP1:2 / 3V3
3V3
JP1:3
JP1:4 / GPIO1
JP1:5 / GPIO2
JP1:6
JP1:7 / GPIO4
JP1:8 / GPIO11
JP1:9
JP1:10
JP1:11
JP1:12 / VBUS
VBUS / VUSB
JP1:13
JP1:14 / GND
GND
JP1:15 / VIN
VIN
JP2:15 / GPIO47
D12
JP2:14 / GPIO38
D11
JP2:13 / GPIO21
D10
JP2:12 / GPIO18
JP2:11 / GPIO17
JP2:10 / GPIO10
JP2:9 / GPIO9
JP2:8 / GPIO8
JP2:7 / GPIO7
JP2:6 / GPIO6
JP2:5 / GPIO5
JP2:4 / GND
JP2:3
RST
JP2:2 / GPIO44
D0 / RX0
JP2:1
D1 / TX0
All printed labels retained; unused pads left unwired.
3V3 / Nano logic supply
+5V LED / MIDI
COMMON GND
U2 Waveshare 24382
1 BL
2 RST
3 D/C
4 CS
5 SCL / CLK
6 SDA / DIN
7 GND
8 VCC
P2 / GH1.25 / SPI / pins 1-8
J1 5.5 x 2.1mm
9V DC / center-negative
CENTER (-)
SLEEVE (+)
U3 S13V10F5
Pololu #4083 / 1178565
5V OUT
47uF / 35V
R50
100k
R51
150k
USB VBUS sense / 3.0V at 5V
J2 ACJS-MHDC / passive pedals
TOP / pedal 1
11 RING
12 TIP
5 RING
6 TIP
10 SLEEVE
4 SLEEVE
BOTTOM / pedal 2
1/2/3/7/8/9: NC; pad 13: mechanical / NC
R20
5.1k
R30
R21
10k
R31
SW11 ENCODER
SW1
SW2
20 detents + click
Internal pull-ups
No external R/C
MODULAR FOOTSWITCH LADDER
20k
100nF
T1 / LED1
R10
T2 / LED2
R11
SW3
T3 / LED3
R12
SW4
T4 / LED4
R13
SW5
T5 / LED5
R14
SW6
T6 / LED6
R15
SW7
T7 / LED7
R16
SW8
T8 / LED8
R17
SW9
T9 / LED9
R18
SW10
T10 / LED10
Pololu 2535 / optional LEDs
LED1 / B
2535
DIN
DOUT
LED2 / A
LED3 / 2
LED4 / 1
LED5 / C
LED6 / 3
LED7 / D
LED8 / 4
LED9 / E
LED10 / 5
SIGMIDI FOOT CONTROLLER
v0.1 / KICAD ELECTRICAL SCHEMATIC / external board pins only
Continuous wires connect every fitted terminal. Dots = junctions; crossings without dots = no connection. Component placement is schematic.
Nano and LCD pins keep physical order. Nano: JP1 left 1-15, JP2 right 15-1, USB-C up. Outlines are schematic.
PASSIVE PEDALS
Pot: outer legs RING / SLEEVE; wiper TIP.
Variable resistor: TIP to SLEEVE; RING unused.
0-10k per input. Bias HIGH in resistor mode;
high impedance in pot / disabled / boot states.
ASSEMBLY
Set 4 / 6 / 8 / 10 switches; calibrate installed taps.
SW11 contact pin arrangement is functional.
Native USB-C carries USB MIDI and ROM flashing.
USB-only supply does not power the external LED rail.
LED PACKAGE
Lens left, leads right, flat side down.
Top to bottom: DIN / 5V / GND / DOUT.
Only LEDs and wires; direct D7 / GPIO10 data.
Check 3.3V data acceptance on the actual LED batch.
Netlist, BOM and pin references: design/electrical/. All 57 components and 49 nets checked against the connected drawing.
MIDI OUT / 2 x 3.5 mm TRS
1N5819
MIDI_5V = converter +5V OR USB VBUS (D1/D2 1N5819)
U4 74HCT125 at MIDI_5V: 1A/2A from D0 / GPIO44
UART1 TX, 31,250 baud; R52 holds TX idle high
Unused 3A/4A and all ~OE to GND; 3Y/4Y open
C6 100nF across U4 pins 14/7
TRS Type A: T = sink (DIN 5), R = source (DIN 4)
S = shield / GND (DIN 2)
U4 74HCT125
R52
R53
220R
R54
R55
R56
MIDI OUT A
MIDI OUT B
