awhite2000/sigmidi/scripts/verify_kicad_netlist.py

#!/usr/bin/env python3
"""Compare a KiCad XML netlist export with the electrical diagram's pin map."""

import argparse
import json
import math
from pathlib import Path
import xml.etree.ElementTree as ET


ROOT = Path(__file__).resolve().parents[1]


def verify_physical_order(source_path, pin_locations_path):
    """Check Konnect's queried coordinates, independently of requested placement."""
    source = json.loads(source_path.read_text())
    queried = json.loads(pin_locations_path.read_text())
    components = {c['reference']: c for c in queried['components']}
    board = {p['number']: p for p in components['U1']['pins']}
    assert set(board) == set(source['components']['U1']['pins'])
    # The official Nano schematic numbers JP2 from TX at the bottom upwards;
    # its top-view physical order is therefore JP2:15 down to JP2:1.
    physical = source.get('controller_external_pins', source.get('nano_external_pins'))
    assert physical is not None, 'Missing controller physical-pin metadata'
    header_orders = {
        'JP1': [f'JP1:{i}' for i in range(1, 16)],
        'JP2': [f'JP2:{i}' for i in range(15, 0, -1)],
    }
    headers = {}
    for header, order in header_orders.items():
        pins = [board[number] for number in order]
        assert len({round(p['x'], 6) for p in pins}) == 1, header
        pitch = pins[1]['y'] - pins[0]['y']
        assert pitch > 0, header
        assert all(math.isclose(pins[i]['y'] - pins[i - 1]['y'], pitch,
                                abs_tol=1e-6) for i in range(1, len(order))), header
        headers[header] = (pins, pitch)
    left, pitch = headers['JP1']
    right, right_pitch = headers['JP2']
    assert left[0]['x'] < right[0]['x']
    assert math.isclose(pitch, right_pitch, abs_tol=1e-6)
    assert math.isclose(right[0]['y'], left[0]['y'], abs_tol=1e-6)
    expected_labels = {
        'JP1': ['D13', '3V3', 'B0', 'A0', 'A1', 'A2', 'A3', 'A4', 'A5',
                'A6', 'A7', 'VBUS', 'B1', 'GND', 'VIN'],
        'JP2': ['D12', 'D11', 'D10', 'D9', 'D8', 'D7', 'D6', 'D5', 'D4',
                'D3', 'D2', 'GND', 'RST', 'D0/RX', 'D1/TX'],
    }
    for header, order in header_orders.items():
        for number, label in zip(order, expected_labels[header]):
            data = physical[number]
            # Printed RESET/VUSB aliases may be retained alongside RST/VBUS.
            accepted = {'RST': ('RST', 'RESET'), 'VBUS': ('VBUS', 'VUSB')}.get(label, (label,))
            assert data['physical_label'].replace(' ', '').startswith(accepted), (number, data)
            assert board[number]['name'].startswith(data['physical_label'].replace(' ', '')), (number, data)

    lcd = {p['number']: p for p in components['U2']['pins']}
    expected_names = ['BL', 'RST', 'D/C', 'CS', 'SCL/CLK', 'SDA/DIN', 'GND', 'VCC']
    assert set(lcd) == {f'P2:{i}' for i in range(1, 9)}
    pins = [lcd[f'P2:{i}'] for i in range(1, 9)]
    assert [p['name'].replace(' ', '') for p in pins] == expected_names
    assert len({round(p['x'], 6) for p in pins}) == 1
    assert all(pins[i]['y'] > pins[i - 1]['y'] for i in range(1, 8))
    return {'nano_physical_order': True, 'nano_JP2_order': '15 to 1, top to bottom',
            'nano_header_tops_aligned': True,
            'display_physical_order': True}


def verify(source_path, exported_path):
    source = json.loads(source_path.read_text())
    exported = ET.parse(exported_path).getroot()
    expected_components = source['components']
    components = {c.attrib['ref'] for c in exported.findall('./components/comp')
                  if not c.attrib['ref'].startswith('#')}
    assert components == set(expected_components), {
        'missing_components': sorted(set(expected_components) - components),
        'unexpected_components': sorted(components - set(expected_components)),
    }

    expected = {name: {tuple(terminal.split('.', 1)) for terminal in terminals}
                for name, terminals in source['nets'].items()}
    actual = {}
    seen = set()
    unused = {(ref, pin) for ref, component in expected_components.items()
              for pin, net in component['pins'].items() if net is None}
    for net in exported.findall('./nets/net'):
        pins = {(node.attrib['ref'], node.attrib['pin'])
                for node in net.findall('node') if node.attrib['ref'] in components}
        assert not seen.intersection(pins), ('Pins in multiple nets', seen.intersection(pins))
        seen.update(pins)
        if not pins:
            continue
        if len(pins) == 1 and (pins <= unused or not any(
                pin in expected_components[ref]['pins'] for ref, pin in pins)):
            continue  # KiCad may include an isolated NC or open package pin as a one-node net.
        assert not pins.intersection(unused), ('Unexpected NC connection', net.attrib, pins)
        name = net.attrib['name'].removeprefix('/')
        assert name not in actual, ('Duplicate net name', name)
        actual[name] = pins

    assert set(actual) == set(expected), {
        'missing_nets': sorted(set(expected) - set(actual)),
        'unexpected_nets': sorted(set(actual) - set(expected)),
    }
    for name, pins in expected.items():
        assert actual[name] == pins, {
            'net': name,
            'missing_pins': sorted(pins - actual[name]),
            'unexpected_pins': sorted(actual[name] - pins),
        }
    return {
        'components': len(components),
        'nets': len(actual),
        'connected_terminals': sum(map(len, actual.values())),
        'unused_terminals': len(unused),
        'connectivity_matches_source': True,
    }


if __name__ == '__main__':
    parser = argparse.ArgumentParser(description=__doc__)
    parser.add_argument('export', nargs='?', type=Path,
                        default=ROOT / 'design/kicad/sigmidi-foot-controller.net')
    parser.add_argument('--source', type=Path,
                        default=ROOT / 'design/electrical/netlist.json')
    parser.add_argument('--pins', type=Path,
                        default=ROOT / 'design/kicad/verification/pin-locations.json')
    args = parser.parse_args()
    result = verify(args.source, args.export)
    result.update(verify_physical_order(args.source, args.pins))
    print(json.dumps(result, indent=2))
