awhite2000/sigmidi/(commit log)

2026-10-28 Add wiring diagrams and simplify pedal inputs
2026-10-29 Add verified KiCad schematic
2026-10-29 Add switch toggle mode
2026-10-29 Refresh device menu previews
2026-10-29 Add bill of materials
2026-10-29 Fix browser pedal calibration scaling
2026-10-29 Illustrate on-device editing screen paths
2026-10-29 Add Nano ESP32 mounting inserts
2026-10-29 Port firmware to Nano ESP32 with USB MIDI
2026-10-30 Update Nano wiring docs and previews
2026-10-30 Add illustrated assembly guide
2026-10-30 Mount Nano directly on reinforced base posts
2026-10-30 Describe only the current design in documentation
2026-10-30 Remove mounting post root remnants
2026-10-31 Add buffered DIN MIDI OUT and align documentation
    Send every resolved PC/CC message over UART1 on GPIO44 through a
    74HCT125-buffered 5-pin DIN current loop, alongside USB and BLE MIDI.
    MIDI_5V is a Schottky diode-OR of USB VBUS and the converter rail.
    - Route messages to DIN, USB and BLE with one FIFO per link.
    - Report USB/BLE state on the LCD badge and show DIN MIDI when no
    host link is ready.
    - Correct the BLE MIDI characteristic UUID byte order.
    - Store the configuration as an NVS blob, reading the legacy string.
    - Tie unused 74HCT125 inputs and enables to GND.
    - Redraw the MIDI OUT sheet and single-page diode/buffer area.
    - Update firmware, hardware, assembly, BOM and user documentat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
2026-10-31 Switch MIDI OUT to two TRS jacks and add carrier perfboard layout
    Replace the 5-pin DIN output with two 3.5 mm TRS Type A sockets. U4
    gates 1 and 2 share the UART input; 1Y drives J3 and 2Y drives J4,
    each through its own 220R ring/tip pair (R53/R54, R55/R56). Sleeves
    ground the cable shield.
    - Redraw the MIDI OUT sheet and single-page area; update netlist,
    BOM, hardware, firmware, assembly, bring-up and user docs.
    - Show TRS MIDI on the LCD badge when no USB/BLE link is ready.
    - Add a checked 6 x 26 perfboard layout for the U1-side passives,
    ladder top segment and MIDI stage as assembly guide step 7.
    - Keep Finder metadata out of the web-flasher package.
    - Regenerate diagrams, PDFs, ma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
2026-11-01 Show the carrier perfboard in the routing diagram under the dual TRS socket, draw lead lines for upright parts on the perfboard views, move the D1 cathode band so its label shows, and require short s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
2026-11-01 Model the populated 80.5 x 20 mm carrier perfboard (6 x 28 holes, 2.5 mm pitch, 3 mm mounting holes, end pads) in the Left main Fusion assembly, add perspective views of the board and of the open ass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
2026-11-01 Render the remaining documentation Markdown as reference PDFs with a new generator that checks every Markdown file is covered, link the set from the README, and sync the design/fusion power notes cop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
2026-11-01 Add the TRS MIDI OUT stage to the KiCad schematic, netlist checks and BOM, rebuild firmware and web-flasher distributions, print packages and documentation PDFs, update the power and resistor-ladder 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
2026-11-01 Limit ladder calibration centers to 2300 mV, since the 10 kΩ/20 kΩ divider holds idle at about 2200 mV, explain the limit in the user manual, rebuild the firmware and web-flasher distributions, and s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
2026-11-01 Add the TRS MIDI OUT bundle and the converter 5 V feed to the cable-bundle preview, end the LED 5 V and return at J-LED, route the perfboard's insulated links on separate lanes with marked solder end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
